radiolok/rln-trace/fw/README.md

# fw — прошивка CH569

Задачи прошивки:

- USB 3.0 SuperSpeed device (запасной путь — USB2 HS) с составным набором интерфейсов:
  трасса (как у ORBTrace), события, CMSIS-DAP v2, CDC-ACM, управление, DFU;
- приём пакетов из ПЛИС по HSPI (DMA, двойная буферизация) и отправка их в bulk IN;
- команды и запись CSR ПЛИС в обратную сторону;
- загрузка и обновление конфигурационного флеша ПЛИС по SPI0;
- позже — режим USB-Blaster для Quartus: отдельное перечисление как FT245-устройство Altera,
  образец — [`au/pico-usb-blaster`](../au/pico-usb-blaster).

Основа — BSP и примеры [`au/hydrausb3_fw`](../au/hydrausb3_fw), протокольное ядро CMSIS-DAP —
[`au/free-dap`](../au/free-dap).

## Состав

| Папка | Что |
|---|---|
| [`ch569/`](ch569/) | Прошивки CH569 на BSP HydraUSB3: пока `usbstream` — поток самопроверки USB3 без ПЛИС, 335–345 МБ/с без ошибок |
| [`uhsif/`](uhsif/) | Открытый драйвер UHSIF для CH32H417 — второго кандидата на USB3-мост, замена `libUHSIF.a` |
