radiolok/rln-trace/gw/boards/tangnano20k/README.md

# Tang Nano 20K — стенд, шаг 0

[`top_step0.sv`](top_step0.sv): ПЛИС → HSPI 16 бит → CH569 ([`fw/ch569/hspi2usb`](../../../fw/ch569/hspi2usb))
→ USB3 → [`sw/usbstream`](../../../sw/usbstream), и обратное направление CH569 → ПЛИС для замера CRC HSPI.

- 27 МГц → rPLL → `clk`, `CLK_MHZ`: 15 (проводки, по умолчанию), 30, 60, 96. Это HRCLK CH569 (через ODDR,
  в противофазе — CH569 защёлкивает HD по своему фронту посередине бита) и самотест: блоки PRBS31 по
  4096 байт, пакет HSPI — блок, USDF 0x0525354.
- HTCLK CH569 тактирует `hspi_rx` в сыром режиме; принятые пакеты уходят в UART BL616 (115200 8N1)
  hex-строками — вход [`tools/hspi-crc/find_crc.py`](../../../tools/hspi-crc).
- Раз в секунду в тот же UART — строка состояния (комментарий для `find_crc.py`):
  `# <пакетов ушло> <пакетов пришло> <из них плохих> <таймаутов HTACK> <флаги>`, всё hex;
  флаги: бит 0 — самотест включён, бит 1 — PLL захвачен, биты 15:8 — `CLK_MHZ`.
- Шина HD общая: пока CH569 держит HTREQ, новый пакет не начинается. HD отпущена (подтяжка вверх),
  пока ПЛИС не передаёт: HD0 низкий при включении CH569 — это его загрузчик.
- S1 (88) — сброс, S2 (87) — самотест вкл/выкл (после сброса включён). Нажатая кнопка даёт 1 — так в
  примерах Sipeed, на плате не проверено.

## Переделка платы

Резисторы светодиодов LED0–LED5 сняты: выводы 15–20 становятся обычными, все 34 вывода гребёнок заняты
стендом. Светодиодов на ПЛИС больше нет — состояние идёт строкой в UART.

## Выводы (план v2, HSPI 16 бит)

Гребёнки — по картинке Sipeed (`tang_nano_20k_pinlabel.png` на wiki.sipeed.com). Ограничения —
[`tangnano20k.cst`](tangnano20k.cst), частоты тактов — [`clocks.py`](clocks.py) (nextpnr) и
[`top_step0.sdc.in`](top_step0.sdc.in) (Gowin).

| Назначение | Выводы |
|---|---|
| HD0–HD14 | 80, 42, 41, 56, 54, 51, 48, 55, 49, 86, 79, 72, 71, 53, 52 (правая гребёнка) |
| HD15 | 30 |
| HRCLK, HRACT, HRVLD (выходы), HTACK (вход) | 73, 74, 75, 85 |
| HTCLK (вход, GCLKC_1), HTREQ, HTVLD (входы), HTRDY (выход) | 76, 25, 26, 29 |
| TRACECLK (GCLKT_1), TRACED0–3 — шаг 1 | 77; 15, 16, 27, 28 |
| PPS, SMA2 | 31, 17 |
| SWDIO, SWCLK, nRESET — шаг 6 | 20, 19, 18 |
| JTAG (шаг 7): TDI, TDO, nTRST | не хватает: HSPI на 8 бит освобождает HD8–HD15 |

77 — единственный вывод гребёнок для одиночного глобального такта (GCLKT), он у TRACECLK. HTCLK — на
парном 76 (GCLKC_1): по nextpnr домен HTCLK держит 155–177 МГц при нужных 120.

На тех же выводах сидит периферия платы: 79 — вход WS2812, 80 и 85 — слот SD (карту не вставлять),
51/54/55/56 — усилитель звука, 41/42/48/49 — разъём LCD. Это только нагрузка, мешать не должна.

## Соединение с CH569 EVT (проводки, шаг 0)

Гребёнка P3 (LEFT_P, 2×25) на CH569 EVT по схеме `EVT/PUB/CH569WSCH.pdf` (openwch/ch569):

- HD*n* — контакт 19 + *n*: HD0 — 19, HD1 — 20, …, HD15 — 34.
- Земля — 5, 7, 9, 11, 13, 15, 17, 18. **Контакты 1 и 3 — питание платы (POW), не подключать.**
- Линии управления идут на P3 через одну из двух пар резисторных сборок, смотрите, какая запаяна:
  **R34/R35** — прямо (метки на P3 = выводы CH569), **R32/R33** — накрест (для стыковки двух EVT,
  метка `HTCLK1` — это вывод HRCLK микросхемы и т. д.). В документе на EVT заводским для HSPI указан
  набор «R2/R22/R33» — похоже, плата приходит накрест, но лучше посмотреть.

| Tang Nano 20K | Сигнал CH569 | P3 при R34/R35 | P3 при R32/R33 |
|---|---|---|---|
| 73 HRCLK → | HRCLK (PA19) | 10 HRCLK1 | 2 HTCLK1 |
| 74 HRACT → | HRACT (PA18) | 12 HRACK1 | 4 HTREQ1 |
| 75 HRVLD → | HRVLD (PA6) | 16 HRVLD1 | 8 HTVLD1 |
| 85 HTACK ← | HTACK (PA10) | 14 HTACK1 | 6 HTRDY1 |
| 76 HTCLK ← | HTCLK (PA11) | 2 HTCLK1 | 10 HRCLK1 |
| 25 HTREQ ← | HTREQ (PA9) | 4 HTREQ1 | 12 HRACK1 |
| 26 HTVLD ← | HTVLD (PA21) | 8 HTVLD1 | 16 HRVLD1 |
| 29 HTRDY → | HTRDY (PA23) | 6 HTRDY1 | 14 HTACK1 |
| 80, 42, 41, 56, 54, 51, 48, 55 | HD0–HD7 | 19–26 | 19–26 |
| 49, 86, 79, 72, 71, 53, 52, 30 | HD8–HD15 | 27–34 | 27–34 |
| GND | GND | 5–17 нечётные, 18 | то же |

HD15 — PB14 через R2 (в ISP-варианте вместо него R1 на MISO): на заводской плате это HSPI. HD14 — PB15,
он же RST#: в нашем CH569 RESET_EN = 0, вывод свободен.

На проводках начинать с `CLK_MHZ = 15`: 16 бит × 15 МГц = 30 МБ/с. Земля — через каждые 2–3 сигнала,
HRCLK и HTCLK — с отдельной землёй рядом. Прошивка CH569 — `hspi2usb` (HSPI 16 бит).

## Сборка

```sh
make -C gw board-lint                    # Verilator, все четыре CLK_MHZ
make -C gw board-synth                   # Yosys synth_gowin (так и в CI)
make -C gw board-pnr OSS=~/.local/opt/oss-cad-suite/bin/ TN20K_MHZ=15     # nextpnr-himbaechel -> .fs
openFPGALoader -b tangnano20k gw/build/tangnano20k/top_step0.fs    # в SRAM; -f — во флеш
make -C gw board-gowin TN20K_MHZ=15      # Gowin EDA под Windows из WSL (gw_sh.exe, GW_SH=...)
```

`board-gowin` копирует исходники, `tangnano20k.cst`, SDC и [`gowin.tcl`](gowin.tcl) во временный каталог
Windows, подставляет `CLK_MHZ`, запускает `gw_sh` и забирает отчёты и битстрим в
`gw/build/tangnano20k/gowin/pnr/`. Нужна Gowin EDA с действующей лицензией (бесплатную выдаёт Gowin по
запросу). Путь — переменная `GW_SH`.

| Дата | Тулчейн | Вариант | LUT4 | ALU | DFF | BSRAM | Fmax clk / HTCLK |
|---|---|---|---|---|---|---|---|
| 2026-10-21 | Yosys 0.70 + nextpnr-himbaechel 0.11 | 8 бит, 60 МГц | 1002 | 354 | 549 | 1 | 150 / 197 МГц (нужно 60 / 120) |
| 2026-10-21 | Gowin EDA 1.9.12.04 | 8 бит, 60 МГц | 572 | 203 | 533 | 1 | 112 / 170 МГц |
| 2026-10-21 | Yosys 0.70 + nextpnr-himbaechel 0.11 | 16 бит, 15 МГц | 1401 | — | — | 1 | 115 / 155 МГц (нужно 15 / 120) |
| 2026-10-21 | Yosys 0.70 + nextpnr-himbaechel 0.11 | 16 бит, 96 МГц | 1392 | — | — | 1 | 102–123 / 174–177 МГц (нужно 96 / 120) |

Оценки Fmax у nextpnr заметно оптимистичнее, для подписи по таймингам надёжнее Gowin. На 96 МГц запас
по `clk` у nextpnr от прогона к прогону 6–28 % — до работы на этой частоте проверить в Gowin. Он же нашёл
узкое место HTCLK: свободное место FIFO `hspi_rx` (перевод указателя из кода Грея, вычитание,
сравнение) — 131 МГц при нужных 120; после регистра на `wfree` в `async_fifo` — 170 МГц.
