radiolok/rln-trace/hw/probe-b/kicad/README.md

# Открытый Debug+Trace зонд — схема rev 0.1 (KiCad 9)

Иерархический проект: корневой лист `probe.kicad_sch` + 5 листов.

| Лист | Содержимое |
|---|---|
| `usb_power.kicad_sch` | USB-C (USB 3.2 Gen1), мультиплексор SS-ориентации CBTL02043A + детектор CC на TLV7031, ESD (USBLC6, 2× TPD4EUSB30), предохранитель, 2× TLV62569 (3V3 и 1V0, 1V0 включается по PG от 3V3) |
| `mcu.kicad_sch` | CH569W: HSPI 16 бит, кварц 30 МГц, развязка по референсу WCH, BOOT (HD0), UART, доступ к флешу ПЛИС по SPI0, подтяжки I2C, разъём EXP |
| `fpga.kicad_sch` | GW2AR-18 QN88 (4 юнита: банки 0/1, 4/5, 2/3/6/7, питание), MSPI-флеш W25Q128, JTAG 10 pin 1,27 мм, генератор 50 МГц, MODE-резисторы, EXTR, светодиоды |
| `target.kicad_sch` | MIPI20, ESD (3× TPD4E02B04), последовательные 33 Ом, SN74AVC8T245 (вход трассы, TDO, контроль nRESET), SN74AVC4T245 (SWDIO, SWCLK, TDI), nRESET на 2N7002, фильтр VREF, TgtPwr (AP2161 + шунт + INA219, перемычка JP1 для 11/13), ADS1115 |
| `sma.kicad_sch` | 2× SMA, двунаправленные через SN74LVC1T45, 33 Ом, TVS, отключаемая нагрузка 50 Ом |

Также: `probe.kicad_sym` (все символы проекта), `probe.pretty` (посадка QN88), `pinmap.csv` (все выводы GW2AR-18 и CH569W → цепи), `BOM_draft.csv`. PDF-превью листов — [`../probe_schematic_preview.pdf`](../probe_schematic_preview.pdf).

## Откуда распиновки

- GW2AR-18 QN88 (вариант со SDRAM): Gowin UG115E v1.7.2, колонка QN88[1]. Сверено с Tang Nano 20K (тактовый на 4, кнопки на 87/88).
- CH569W: референсная схема WCH CH569W-R0-1v0 (репозиторий openwch/ch569).
- Остальные микросхемы: символы из библиотеки KiCad (с их номерами выводов).

## Как схема собрана

Схема сгенерирована скриптом [`tools/schgen`](../../../tools/schgen), KiCad в рабочем окружении не было. Связи сделаны метками: у каждого используемого вывода — короткий провод и метка или символ питания. Цепи между листами — глобальные метки. Собственная проверка связности (ERC-подобная) ошибок не нашла: все выводы подключены или помечены «не подключено», нет цепей из одного вывода, нет питания без источника, нет двух выходов на одной цепи.

**Первым делом:** откройте `probe.kicad_pro` в KiCad 9, выполните ERC и «Update PCB from schematic» — так проверяется, что файлы корректно читаются и все посадки находятся. Если KiCad ругнётся на формат, пришлите текст ошибки — генератор поправлю.

## Открытые вопросы до разводки

1. Посадка QN88: номинальная (контакт 0,22×0,85 мм, центральная площадка 6,74 мм), сверить с чертежом в UG229.
2. CH569W QFN68: размер центральной площадки по даташиту CH569DS1 (сейчас стоит стандартная 5,2×5,2 мм).
3. PB15 = HD14 одновременно RST#: в конфигурации CH569 отключить RST# до того, как ПЛИС начнёт управлять HSPI_D14 (стоит подтяжка 10 кОм).
4. MODE[1:0] = 00 → MSPI (по UG290, таблица 5-2), MODE2 внутри на земле — проверить.
5. Полярность SEL у CBTL02043A (SEL=0 → A↔B) — проверить по даташиту NXP.
6. Разъём USB-C (Amphenol 12401610E4-2A) — подтвердить, что это полная USB3-версия, или заменить на доступный.
7. Номиналы 33 Ом на линиях трассы подобрать на макете (84–100 МГц DDR).
8. Режим TRIGIN (TRC_DATA[2] на выход) в rev 0.1 не поддержан — вход трассы только через AVC8T245.
