radiolok/rln-trace/doc/slogic-pinmap-method.md

# SLogic16U3: методика прозвонки входов на стенде

Цель — узнать, на какие выводы GW5AT-15 приходят каналы CH0–CH15 (и выводы CK на гребёнке) у
Sipeed SLogic16U3, не рискуя прибором. Это нужно для своей прошивки направления A: адаптера потока
трассы TPIU. Что известно о приборе, его флеш и восстановлении — [`tools/slogic/README.md`](../tools/slogic/README.md).

## Что уже известно

- **ПЛИС — GW5AT-LV15MG132C1/I0**, корпус MG132: 53 пользовательских вывода. Флеш XT25F128F
  (16 МиБ, `0b4018`): приложение с 0x0, золотой образ DFU с 0x800000, оба зашифрованы; свой
  открытый битстрим ПЛИС принимает.
- **Входы — только пассивные компоненты** (резисторные сборки, конденсатор, защитный диод): каналы
  идут на выводы ПЛИС через последовательные резисторы. Порог анализатора, видимо, задаётся
  напряжением банка ввода-вывода от DC-DC (TMI7003?).
- **Отладочный разъём** `5V TMS TDO TCK TDI RXD TXD GND`, 3,3 В: JTAG ПЛИС и UART. JTAG работает
  (openFPGALoader через FT2232H); заводской образ в UART не пишет ничего.
- **Первая прозвонка (2026-10-21) собрана под корпус CS130** (`GW5AT-LV15CS130C1/I0`) вместо MG132.
  Сначала это сочли причиной неудачи; 2026-10-25 выяснилось, что нет: площадки кристалла у корпусов
  одни и те же, и образ слушал все 40 свободных (разбор — [журнал](slogic-pinmap-journal.md)).
  Итог: ни одного фронта на 40 выводах; D3, F7, K2, N2 (по раскладке CS130) снаружи держатся в 0; подтяжки вверх, вероятно, легли на линии USB-части — USB2 перестал подниматься, MODE не давал
  DFU. Прибор восстановлен через JTAG 2026-10-25.

## Стенд

```
STM32F4-Discovery ── PD0..7, PE0..7 (+GND) ──> входы CH0..CH15 SLogic16U3 ── USB ──> ПК (питание, заводской анализатор)
      │                                              │
   ST-LINK ──> ПК (OpenOCD)                     отладочный разъём
                                                     │
                                  FT2232H: канал A — JTAG, канал B — UART ──> ПК
```

| Откуда | Куда | Зачем |
|---|---|---|
| Discovery PD0–PD7, PE0–PE7 | SLogic CH0–CH15 | источник: бит k счётчика (канал CHk) меняется 500 кГц / 2^k раз в секунду ([`tools/slogic/pinmap/stm32`](../tools/slogic/pinmap/stm32)); PE0/PE1 заняты акселерометром — CH8/CH9 при необходимости с PE8/PE9 |
| Discovery GND | SLogic GND входов | общая земля |
| SLogic TCK, TDI, TDO, TMS | FT2232H ADBUS0, 1, 2, 3 | JTAG ПЛИС: загрузка образа в SRAM, чтение результата |
| SLogic TXD / RXD | FT2232H BDBUS1 / BDBUS0 (через 1 кОм) | UART разъёма, `/dev/ttyUSB1` |
| SLogic GND разъёма | FT2232H GND | |
| SLogic 5V разъёма | — | не подключать |
| SLogic USB | порт ПК (не зарядка) | питание и проверка заводским анализатором |

Все USB-устройства идут в WSL через usbipd: ST-LINK `0483:3748`, FT2232H `0403:6010`, SLogic
`359f:*` (приложение и DFU). Признак работы источника — зелёный PD12 на Discovery мигает ~1 Гц.

## Правила безопасности

1. **Флеш не трогать.** Опытные образы грузятся только в SRAM ПЛИС по JTAG
   (`openFPGALoader -c ft2232 -m образ.fs`). Сбой — передёрнуть питание SLogic: ПЛИС загрузит
   заводское приложение из флеш. Перед любой серией проверять, что бэкап `slogic16u3-factory.bin`
   на месте (sha256 `161e2bcf…85bc`), а JTAG-восстановление из `tools/slogic/README.md` под рукой.
2. **Никаких выходов на неизвестных выводах.** Все кандидаты — входы без подтяжки (в крайнем случае
   с подтяжкой вниз). Выход разрешается только на выводе, назначение которого подтверждено.
3. **Не трогать служебные выводы:** JTAG, RECONFIG_N (кнопка MODE), DONE, READY, MODE0/1, выводы
   флеш (CS, CLK, IO0–IO3), SerDes и всё, что относится к USB. Список — по таблице выводов MG132, а
   не по памяти и не по чужому корпусу.
4. **Банки ввода-вывода.** В образе задавать тот стандарт (LVCMOS33/25/18), который соответствует
   напряжению банка на плате; при сомнении — входом с самым высоким VCCIO, который не превышает
   питание банка. Напряжение банков проверить мультиметром на доступных конденсаторах, если найдутся.
5. **Остановиться**, если после загрузки образа меняется поведение прибора не так, как ожидалось
   (греется, гаснет индикатор, пропадает JTAG): снять питание, разобраться до следующей попытки.

## Ход эксперимента

### Э0. Подготовка

- Таблица выводов GW5AT-15 из документации Gowin («GW5AT-15 Pinout», excel, или «GW5A series
  Package & Pinout User Guide»; на gowinsemi.com — после входа в учётную запись). Из неё —
  список кандидатов: 53 пользовательских вывода MG132 минус служебные (п. 3 правил).
- Сборка образов для GW5AT-15 — только Gowin EDA: в открытом тулчейне
  (nextpnr-himbaechel / apycula) базы для этого кристалла нет. Корпус в проекте —
  `GW5AT-LV15MG132C1/I0`, ревизия кристалла — по `--detect` (прошлые сборки: device_version B).
- Прошивка источника на Discovery (`tools/slogic/pinmap/stm32`, OpenOCD
  `board/stm32f4discovery.cfg`); проверить PD12.

### Э1. Источник и входы — заводским анализатором

ПЛИС не трогаем. SLogic подключён к ПК, работает заводское приложение.

1. Записать несколько секунд всех 16 каналов на частоте ≥ 4 МГц (сигрок/PulseView или свой
   приёмник по протоколу Sipeed: vendor control, bulk IN 0x82).
2. Ожидание: канал CHk — меандр 500 кГц / 2^k / 2 (бит k меняется 500 кГц / 2^k раз в секунду).
3. Итог этапа: источник работает, входы целы, нумерация каналов на корпусе совпадает с прошивкой
   STM32. Если нет — дальше не идём, сначала источник и проводка.

### Э2. Канал для результата: JTAG

Чтобы не ставить ни одного выхода на неизвестный вывод, результат прозвонки читается обратно
**через JTAG**: в образе — примитив пользовательского JTAG Gowin (`GW_JTAG`, инструкции
пользовательских регистров), сдвиговый регистр с результатом. Читается он с ПК через тот же
FT2232H (OpenOCD `irscan`/`drscan` или pyftdi). Коды инструкций и поведение примитива на GW5A —
сверить с документацией Gowin (UG по примитивам и по конфигурации GW5A) и проверить на коротком
тестовом образе (константа в регистре) до прозвонки.

UART разъёма — запасной канал. Чтобы им пользоваться, сначала нужно найти шарик RXD: FT2232H шлёт в
RXD известную последовательность, образ (только входы) ищет вывод, на котором она видна. TXD —
вывод-выход: включать его только после того, как назначение подтверждено (рядом с RXD по разводке
или по документации платы, если появится).

### Э3. Прозвонка входов

Образ: все кандидаты — входы без подтяжки, на каждом — счётчик фронтов за окно (как в
[`tools/slogic/pinmap/pinmap.v`](../tools/slogic/pinmap/pinmap.v): 2^28 тактов внутреннего генератора ≈ 5 с) и
снимок уровня. Результат — в регистр пользовательского JTAG.

1. Загрузить образ в SRAM, источник **выключен** (STM32 в сбросе): записать уровни всех кандидатов.
   Это фон: что держится снаружи и чем.
2. Источник **включён**: записать число фронтов на каждом кандидате.
3. Канал опознаётся по частоте: `log2(ожидаемое для CH0 / измеренное)` = номер канала (разбор —
   [`pinmap.py`](../tools/slogic/pinmap/pinmap.py), отчёт в том же формате).
4. Повторить, отключив один канал на Discovery (вывод STM32 — вход), — подтверждение для каждого
   спорного соответствия.
5. Передёрнуть питание SLogic, убедиться, что заводское приложение работает (индикатор, USB).

### Э4. CK и порог

- Выводы CK на гребёнке (по Sipeed «зарезервированы») — найти тем же образом, подав на них сигнал с
  Discovery (свободный вывод PDx/PEx); это кандидат на вход TRACECLK.
- Порог: в заводском приложении менять порог (AUX-регистр) и смотреть, какое напряжение на плате
  меняется — так находится банк входов и его регулятор. Нужен для выбора IO_TYPE в своей прошивке.

## Что записывать

Журнал каждой попытки: дата, образ (имя, sha256, корпус и ревизия в сборке), что было подключено,
уровни и счётчики из отчёта, поведение прибора после образа и после передёргивания питания.
Итоговая таблица «канал → шарик MG132 → банк» — в `tools/slogic/README.md`.

## Восстановление

Если что-то пошло не так и передёргивание питания не помогает (а флеш не трогали — должно помогать):
порядок через JTAG в [`tools/slogic/README.md`](../tools/slogic/README.md#jtag-плис-путь-восстановления-без-dfu-проверен-2026-10-25):
дамп, сверка золотого образа, стирание 0x0, DFU, `slogic_dfu.py restore`.
