radiolok/rln-trace/tools/slogic/trace/runs/beu1000/show.txt

полубайтов 65536, простоя 43607, сообщений 3185, вне сообщений 3
  TCODE  3 DirectBranch           453
  TCODE  4 IndirectBranch         2720
  TCODE  9 ProgTraceSync          12
  @     5 10 d1 b4 07              IndirectBranch BTYPE=0 ICNT=13 UADDR=0xda                  
  @    15 10 81 60 07              IndirectBranch BTYPE=0 ICNT=8 UADDR=0xb0                   
  @    23 10 e1 2b                 IndirectBranch BTYPE=0 ICNT=14 UADDR=0x14                  
  @    29 10 e1 3c 07              IndirectBranch BTYPE=0 ICNT=14 UADDR=0x9e                  
  @    37 10 91 14 07              IndirectBranch BTYPE=0 ICNT=9 UADDR=0x8a                   
  @   137 0c 17                    DirectBranch ICNT=5                                        
  @   143 10 91 d7                 IndirectBranch BTYPE=0 ICNT=9 UADDR=0x6a                   
  @   151 10 d1 e4 07              IndirectBranch BTYPE=0 ICNT=13 UADDR=0xf2                  
  @   161 10 c1 30 07              IndirectBranch BTYPE=0 ICNT=12 UADDR=0x98                  
  @   169 10 e1 2b                 IndirectBranch BTYPE=0 ICNT=14 UADDR=0x14                  
  @   175 10 e1 48 07              IndirectBranch BTYPE=0 ICNT=14 UADDR=0xa4                  
  @   187 10 81 60 07              IndirectBranch BTYPE=0 ICNT=8 UADDR=0xb0                   
  @   277 0c 17                    DirectBranch ICNT=5                                        
  @   283 10 91 d7                 IndirectBranch BTYPE=0 ICNT=9 UADDR=0x6a                   
  @   291 10 d1 c0 07              IndirectBranch BTYPE=0 ICNT=13 UADDR=0xe0                  
  @   301 10 91 14 07              IndirectBranch BTYPE=0 ICNT=9 UADDR=0x8a                   
  @   309 10 e1 2b                 IndirectBranch BTYPE=0 ICNT=14 UADDR=0x14                  
  @   315 10 e1 18 07              IndirectBranch BTYPE=0 ICNT=14 UADDR=0x8c                  
  @   331 10 c1 30 07              IndirectBranch BTYPE=0 ICNT=12 UADDR=0x98                  
  @   425 0c 17                    DirectBranch ICNT=5                                        
  @   431 10 91 d7                 IndirectBranch BTYPE=0 ICNT=9 UADDR=0x6a                   
  @   439 10 d1 b4 07              IndirectBranch BTYPE=0 ICNT=13 UADDR=0xda                  
  @   449 10 81 60 07              IndirectBranch BTYPE=0 ICNT=8 UADDR=0xb0                   
  @   457 10 e1 2b                 IndirectBranch BTYPE=0 ICNT=14 UADDR=0x14                  
  @   463 10 e1 3c 07              IndirectBranch BTYPE=0 ICNT=14 UADDR=0x9e                  
  @   471 10 91 14 07              IndirectBranch BTYPE=0 ICNT=9 UADDR=0x8a                   
  @   571 0c 17                    DirectBranch ICNT=5                                        
  @   577 10 91 d7                 IndirectBranch BTYPE=0 ICNT=9 UADDR=0x6a                   
  @   585 10 d1 e4 07              IndirectBranch BTYPE=0 ICNT=13 UADDR=0xf2                  
  @   595 10 c1 30 07              IndirectBranch BTYPE=0 ICNT=12 UADDR=0x98                  
  @   603 10 e1 2b                 IndirectBranch BTYPE=0 ICNT=14 UADDR=0x14                  
  @   609 10 e1 48 07              IndirectBranch BTYPE=0 ICNT=14 UADDR=0xa4                  
  @   621 10 81 60 07              IndirectBranch BTYPE=0 ICNT=8 UADDR=0xb0                   
  @   711 0c 17                    DirectBranch ICNT=5                                        
  @   717 10 91 d7                 IndirectBranch BTYPE=0 ICNT=9 UADDR=0x6a                   
  @   725 10 d1 c0 07              IndirectBranch BTYPE=0 ICNT=13 UADDR=0xe0                  
  @   735 10 91 14 07              IndirectBranch BTYPE=0 ICNT=9 UADDR=0x8a                   
  @   743 10 e1 2b                 IndirectBranch BTYPE=0 ICNT=14 UADDR=0x14                  
  @   749 10 e1 18 07              IndirectBranch BTYPE=0 ICNT=14 UADDR=0x8c                  
  @   767 10 c1 30 07              IndirectBranch BTYPE=0 ICNT=12 UADDR=0x98                  
  @   861 0c 17                    DirectBranch ICNT=5                                        
  @   867 10 91 d7                 IndirectBranch BTYPE=0 ICNT=9 UADDR=0x6a                   
  @   875 10 d1 b4 07              IndirectBranch BTYPE=0 ICNT=13 UADDR=0xda                  
  @   885 10 81 60 07              IndirectBranch BTYPE=0 ICNT=8 UADDR=0xb0                   
  @   893 10 e1 2b                 IndirectBranch BTYPE=0 ICNT=14 UADDR=0x14                  
  @   899 10 e1 3c 07              IndirectBranch BTYPE=0 ICNT=14 UADDR=0x9e                  
  @   907 10 91 14 07              IndirectBranch BTYPE=0 ICNT=9 UADDR=0x8a                   
  @  1007 0c 17                    DirectBranch ICNT=5                                        
  @  1013 10 91 d7                 IndirectBranch BTYPE=0 ICNT=9 UADDR=0x6a                   
  @  1021 10 d1 e4 07              IndirectBranch BTYPE=0 ICNT=13 UADDR=0xf2                  
  @  1031 10 c1 30 07              IndirectBranch BTYPE=0 ICNT=12 UADDR=0x98                  
  @  1039 10 e1 2b                 IndirectBranch BTYPE=0 ICNT=14 UADDR=0x14                  
  @  1045 10 e1 48 07              IndirectBranch BTYPE=0 ICNT=14 UADDR=0xa4                  
  @  1053 10 81 60 07              IndirectBranch BTYPE=0 ICNT=8 UADDR=0xb0                   
  @  1147 0c 17                    DirectBranch ICNT=5                                        
  @  1153 10 91 d7                 IndirectBranch BTYPE=0 ICNT=9 UADDR=0x6a                   
  @  1161 10 d1 c0 07              IndirectBranch BTYPE=0 ICNT=13 UADDR=0xe0                  
  @  1171 10 91 14 07              IndirectBranch BTYPE=0 ICNT=9 UADDR=0x8a                   
  @  1179 10 e1 2b                 IndirectBranch BTYPE=0 ICNT=14 UADDR=0x14                  
  @  1185 10 e1 18 07              IndirectBranch BTYPE=0 ICNT=14 UADDR=0x8c                  
  @  1199 10 c1 30 07              IndirectBranch BTYPE=0 ICNT=12 UADDR=0x98                  
  @  1295 0c 17                    DirectBranch ICNT=5                                        
  @  1301 10 91 d7                 IndirectBranch BTYPE=0 ICNT=9 UADDR=0x6a                   
  @  1309 10 d1 b4 07              IndirectBranch BTYPE=0 ICNT=13 UADDR=0xda                  
  @  1319 10 81 60 07              IndirectBranch BTYPE=0 ICNT=8 UADDR=0xb0                   
  @  1327 10 e1 2b                 IndirectBranch BTYPE=0 ICNT=14 UADDR=0x14                  
  @  1333 10 e1 3c 07              IndirectBranch BTYPE=0 ICNT=14 UADDR=0x9e                  
  @  1341 10 91 14 07              IndirectBranch BTYPE=0 ICNT=9 UADDR=0x8a                   
  @  1441 0c 17                    DirectBranch ICNT=5                                        
  @  1447 10 91 d7                 IndirectBranch BTYPE=0 ICNT=9 UADDR=0x6a                   
  @  1455 10 d1 e4 07              IndirectBranch BTYPE=0 ICNT=13 UADDR=0xf2                  
  @  1465 10 c1 30 07              IndirectBranch BTYPE=0 ICNT=12 UADDR=0x98                  
  @  1473 10 e1 2b                 IndirectBranch BTYPE=0 ICNT=14 UADDR=0x14                  
  @  1479 10 e1 48 07              IndirectBranch BTYPE=0 ICNT=14 UADDR=0xa4                  
  @  1487 10 81 60 07              IndirectBranch BTYPE=0 ICNT=8 UADDR=0xb0                   
  @  1581 0c 17                    DirectBranch ICNT=5                                        
  @  1587 10 91 d7                 IndirectBranch BTYPE=0 ICNT=9 UADDR=0x6a                   
  @  1595 10 d1 c0 07              IndirectBranch BTYPE=0 ICNT=13 UADDR=0xe0                  
  @  1605 10 91 14 07              IndirectBranch BTYPE=0 ICNT=9 UADDR=0x8a                   
  @  1613 10 e1 2b                 IndirectBranch BTYPE=0 ICNT=14 UADDR=0x14                  
  @  1619 10 e1 18 07              IndirectBranch BTYPE=0 ICNT=14 UADDR=0x8c                  
  @  1633 10 c1 30 07              IndirectBranch BTYPE=0 ICNT=12 UADDR=0x98                  
  @  1729 0c 17                    DirectBranch ICNT=5                                        
  @  1735 10 91 d7                 IndirectBranch BTYPE=0 ICNT=9 UADDR=0x6a                   
  @  1743 10 d1 b4 07              IndirectBranch BTYPE=0 ICNT=13 UADDR=0xda                  
  @  1753 10 81 60 07              IndirectBranch BTYPE=0 ICNT=8 UADDR=0xb0                   
  @  1761 10 e1 2b                 IndirectBranch BTYPE=0 ICNT=14 UADDR=0x14                  
  @  1767 10 e1 3c 07              IndirectBranch BTYPE=0 ICNT=14 UADDR=0x9e                  
  @  1775 10 91 14 07              IndirectBranch BTYPE=0 ICNT=9 UADDR=0x8a                   
  @  1875 0c 17                    DirectBranch ICNT=5                                        
  @  1881 10 91 d7                 IndirectBranch BTYPE=0 ICNT=9 UADDR=0x6a                   
  @  1889 10 d1 e4 07              IndirectBranch BTYPE=0 ICNT=13 UADDR=0xf2                  
  @  1899 10 c1 30 07              IndirectBranch BTYPE=0 ICNT=12 UADDR=0x98                  
  @  1907 10 e1 2b                 IndirectBranch BTYPE=0 ICNT=14 UADDR=0x14                  
  @  1913 10 e1 48 07              IndirectBranch BTYPE=0 ICNT=14 UADDR=0xa4                  
  @  1921 10 81 60 07              IndirectBranch BTYPE=0 ICNT=8 UADDR=0xb0                   
  @  2015 0c 17                    DirectBranch ICNT=5                                        
  @  2021 10 91 d7                 IndirectBranch BTYPE=0 ICNT=9 UADDR=0x6a                   
  @  2029 10 d1 c0 07              IndirectBranch BTYPE=0 ICNT=13 UADDR=0xe0                  
  @  2039 10 91 14 07              IndirectBranch BTYPE=0 ICNT=9 UADDR=0x8a                   
  @  2047 10 e1 2b                 IndirectBranch BTYPE=0 ICNT=14 UADDR=0x14                  
  @  2053 10 e1 18 07              IndirectBranch BTYPE=0 ICNT=14 UADDR=0x8c                  
  @  2067 10 c1 30 07              IndirectBranch BTYPE=0 ICNT=12 UADDR=0x98                  
  @  2163 0c 17                    DirectBranch ICNT=5                                        
  @  2169 10 91 d7                 IndirectBranch BTYPE=0 ICNT=9 UADDR=0x6a                   
  @  2177 10 d1 b4 07              IndirectBranch BTYPE=0 ICNT=13 UADDR=0xda                  
  @  2187 10 81 60 07              IndirectBranch BTYPE=0 ICNT=8 UADDR=0xb0                   
  @  2195 10 e1 2b                 IndirectBranch BTYPE=0 ICNT=14 UADDR=0x14                  
  @  2201 10 e1 3c 07              IndirectBranch BTYPE=0 ICNT=14 UADDR=0x9e                  
  @  2209 10 91 14 07              IndirectBranch BTYPE=0 ICNT=9 UADDR=0x8a                   
  @  2309 0c 17                    DirectBranch ICNT=5                                        
  @  2315 10 91 d7                 IndirectBranch BTYPE=0 ICNT=9 UADDR=0x6a                   
  @  2323 10 d1 e4 07              IndirectBranch BTYPE=0 ICNT=13 UADDR=0xf2                  
  @  2333 10 c1 30 07              IndirectBranch BTYPE=0 ICNT=12 UADDR=0x98                  
  @  2341 10 e1 2b                 IndirectBranch BTYPE=0 ICNT=14 UADDR=0x14                  
  @  2347 10 e1 48 07              IndirectBranch BTYPE=0 ICNT=14 UADDR=0xa4                  
  @  2355 10 81 60 07              IndirectBranch BTYPE=0 ICNT=8 UADDR=0xb0                   
  @  2449 0c 17                    DirectBranch ICNT=5                                        
  @  2455 10 91 d7                 IndirectBranch BTYPE=0 ICNT=9 UADDR=0x6a                   
  @  2463 10 d1 c0 07              IndirectBranch BTYPE=0 ICNT=13 UADDR=0xe0                  
  @  2473 10 91 14 07              IndirectBranch BTYPE=0 ICNT=9 UADDR=0x8a                   
  @  2481 10 e1 2b                 IndirectBranch BTYPE=0 ICNT=14 UADDR=0x14                  
  @  2487 10 e1 18 07              IndirectBranch BTYPE=0 ICNT=14 UADDR=0x8c                  
  @  2501 10 c1 30 07              IndirectBranch BTYPE=0 ICNT=12 UADDR=0x98                  
  @  2597 0c 17                    DirectBranch ICNT=5                                        
  @  2603 10 91 d7                 IndirectBranch BTYPE=0 ICNT=9 UADDR=0x6a                   
  @  2611 10 d1 b4 07              IndirectBranch BTYPE=0 ICNT=13 UADDR=0xda                  
  @  2621 10 81 60 07              IndirectBranch BTYPE=0 ICNT=8 UADDR=0xb0                   
  @  2629 10 e1 2b                 IndirectBranch BTYPE=0 ICNT=14 UADDR=0x14                  
  @  2635 10 e1 3c 07              IndirectBranch BTYPE=0 ICNT=14 UADDR=0x9e                  
  @  2643 10 91 14 07              IndirectBranch BTYPE=0 ICNT=9 UADDR=0x8a                   
  @  2743 0c 17                    DirectBranch ICNT=5                                        
  @  2749 10 91 d7                 IndirectBranch BTYPE=0 ICNT=9 UADDR=0x6a                   
  @  2757 10 d1 e4 07              IndirectBranch BTYPE=0 ICNT=13 UADDR=0xf2                  
  @  2767 10 c1 30 07              IndirectBranch BTYPE=0 ICNT=12 UADDR=0x98                  
  @  2775 10 e1 2b                 IndirectBranch BTYPE=0 ICNT=14 UADDR=0x14                  
  @  2781 10 e1 48 07              IndirectBranch BTYPE=0 ICNT=14 UADDR=0xa4                  
  @  2789 10 81 60 07              IndirectBranch BTYPE=0 ICNT=8 UADDR=0xb0                   
  @  2883 0c 17                    DirectBranch ICNT=5                                        
  @  2889 10 91 d7                 IndirectBranch BTYPE=0 ICNT=9 UADDR=0x6a                   
  @  2897 10 d1 c0 07              IndirectBranch BTYPE=0 ICNT=13 UADDR=0xe0                  
  @  2907 10 91 14 07              IndirectBranch BTYPE=0 ICNT=9 UADDR=0x8a                   
  @  2915 10 e1 2b                 IndirectBranch BTYPE=0 ICNT=14 UADDR=0x14                  
  @  2921 10 e1 18 07              IndirectBranch BTYPE=0 ICNT=14 UADDR=0x8c                  
  @  2935 10 c1 30 07              IndirectBranch BTYPE=0 ICNT=12 UADDR=0x98                  
  @  3031 0c 17                    DirectBranch ICNT=5                                        
  @  3037 10 91 d7                 IndirectBranch BTYPE=0 ICNT=9 UADDR=0x6a                   
  @  3045 10 d1 b4 07              IndirectBranch BTYPE=0 ICNT=13 UADDR=0xda                  
  @  3055 10 81 60 07              IndirectBranch BTYPE=0 ICNT=8 UADDR=0xb0                   
  @  3063 10 e1 2b                 IndirectBranch BTYPE=0 ICNT=14 UADDR=0x14                  
  @  3069 10 e1 3c 07              IndirectBranch BTYPE=0 ICNT=14 UADDR=0x9e                  
  @  3077 10 91 14 07              IndirectBranch BTYPE=0 ICNT=9 UADDR=0x8a                   
  @  3177 0c 17                    DirectBranch ICNT=5                                        
  @  3183 10 91 d7                 IndirectBranch BTYPE=0 ICNT=9 UADDR=0x6a                   
  @  3191 10 d1 e4 07              IndirectBranch BTYPE=0 ICNT=13 UADDR=0xf2                  
  @  3201 10 c1 30 07              IndirectBranch BTYPE=0 ICNT=12 UADDR=0x98                  
  @  3209 10 e1 2b                 IndirectBranch BTYPE=0 ICNT=14 UADDR=0x14                  
  @  3215 10 e1 48 07              IndirectBranch BTYPE=0 ICNT=14 UADDR=0xa4                  
  @  3223 10 81 60 07              IndirectBranch BTYPE=0 ICNT=8 UADDR=0xb0                   
  @  3317 0c 17                    DirectBranch ICNT=5                                        
  @  3323 10 91 d7                 IndirectBranch BTYPE=0 ICNT=9 UADDR=0x6a                   
  @  3331 10 d1 c0 07              IndirectBranch BTYPE=0 ICNT=13 UADDR=0xe0                  
  @  3341 10 91 14 07              IndirectBranch BTYPE=0 ICNT=9 UADDR=0x8a                   
  @  3349 10 e1 2b                 IndirectBranch BTYPE=0 ICNT=14 UADDR=0x14                  
  @  3355 10 e1 18 07              IndirectBranch BTYPE=0 ICNT=14 UADDR=0x8c                  
  @  3369 10 c1 30 07              IndirectBranch BTYPE=0 ICNT=12 UADDR=0x98                  
  @  3465 0c 17                    DirectBranch ICNT=5                                        
  @  3471 10 91 d7                 IndirectBranch BTYPE=0 ICNT=9 UADDR=0x6a                   
  @  3479 10 d1 b4 07              IndirectBranch BTYPE=0 ICNT=13 UADDR=0xda                  
  @  3489 10 81 60 07              IndirectBranch BTYPE=0 ICNT=8 UADDR=0xb0                   
  @  3497 10 e1 2b                 IndirectBranch BTYPE=0 ICNT=14 UADDR=0x14                  
  @  3503 10 e1 3c 07              IndirectBranch BTYPE=0 ICNT=14 UADDR=0x9e                  
  @  3511 10 91 14 07              IndirectBranch BTYPE=0 ICNT=9 UADDR=0x8a                   
  @  3611 0c 17                    DirectBranch ICNT=5                                        
  @  3617 10 91 d7                 IndirectBranch BTYPE=0 ICNT=9 UADDR=0x6a                   
  @  3625 10 d1 e4 07              IndirectBranch BTYPE=0 ICNT=13 UADDR=0xf2                  
  @  3635 10 c1 30 07              IndirectBranch BTYPE=0 ICNT=12 UADDR=0x98                  
  @  3643 10 e1 2b                 IndirectBranch BTYPE=0 ICNT=14 UADDR=0x14                  
  @  3649 10 e1 48 07              IndirectBranch BTYPE=0 ICNT=14 UADDR=0xa4                  
  @  3657 10 81 60 07              IndirectBranch BTYPE=0 ICNT=8 UADDR=0xb0                   
  @  3751 0c 17                    DirectBranch ICNT=5                                        
  @  3757 10 91 d7                 IndirectBranch BTYPE=0 ICNT=9 UADDR=0x6a                   
  @  3765 10 d1 c0 07              IndirectBranch BTYPE=0 ICNT=13 UADDR=0xe0                  
  @  3775 10 91 14 07              IndirectBranch BTYPE=0 ICNT=9 UADDR=0x8a                   
  @  3783 10 e1 2b                 IndirectBranch BTYPE=0 ICNT=14 UADDR=0x14                  
  @  3789 10 e1 18 07              IndirectBranch BTYPE=0 ICNT=14 UADDR=0x8c                  
  @  3803 10 c1 30 07              IndirectBranch BTYPE=0 ICNT=12 UADDR=0x98                  
  @  3899 0c 17                    DirectBranch ICNT=5                                        
  @  3905 10 91 d7                 IndirectBranch BTYPE=0 ICNT=9 UADDR=0x6a                   
  @  3913 10 d1 b4 07              IndirectBranch BTYPE=0 ICNT=13 UADDR=0xda                  
  @  3923 10 81 60 07              IndirectBranch BTYPE=0 ICNT=8 UADDR=0xb0                   
  @  3931 10 e1 2b                 IndirectBranch BTYPE=0 ICNT=14 UADDR=0x14                  
  @  3937 10 e1 3c 07              IndirectBranch BTYPE=0 ICNT=14 UADDR=0x9e                  
  @  3945 10 91 14 07              IndirectBranch BTYPE=0 ICNT=9 UADDR=0x8a                   
  @  4045 0c 17                    DirectBranch ICNT=5                                        
  @  4051 10 91 d7                 IndirectBranch BTYPE=0 ICNT=9 UADDR=0x6a                   
  @  4059 10 d1 e4 07              IndirectBranch BTYPE=0 ICNT=13 UADDR=0xf2                  
  @  4069 10 c1 30 07              IndirectBranch BTYPE=0 ICNT=12 UADDR=0x98                  
  @  4077 10 e1 2b                 IndirectBranch BTYPE=0 ICNT=14 UADDR=0x14                  
  @  4083 10 e1 48 07              IndirectBranch BTYPE=0 ICNT=14 UADDR=0xa4                  
  @  4091 10 81 60 07              IndirectBranch BTYPE=0 ICNT=8 UADDR=0xb0                   
  @  4153 0c 17                    DirectBranch ICNT=5                                        
  @  4159 10 91 d7                 IndirectBranch BTYPE=0 ICNT=9 UADDR=0x6a                   
  @  4167 10 d1 c0 07              IndirectBranch BTYPE=0 ICNT=13 UADDR=0xe0                  
  @  4177 24 89 a0 00 20 00 83     ProgTraceSync SYNC=2 (периодическая) ICNT=2 FADDR=0x40010050 → 0x40010050 <op_a>
  @  4191 10 71 2c 07              IndirectBranch BTYPE=0 ICNT=7 UADDR=0x96                   → 0x400100c6 <main>
  @  4263 10 e1 2b                 IndirectBranch BTYPE=0 ICNT=14 UADDR=0x14                  → 0x400100d2 <main>
  @  4271 10 e1 18 07              IndirectBranch BTYPE=0 ICNT=14 UADDR=0x8c                  → 0x4001005e <op_b>
  @  4281 10 c1 30 07              IndirectBranch BTYPE=0 ICNT=12 UADDR=0x98                  → 0x400100c6 <main>
  @  4291 0c 17                    DirectBranch ICNT=5                                        → 0x400100aa <main>
  @  4295 10 91 d7                 IndirectBranch BTYPE=0 ICNT=9 UADDR=0x6a                   → 0x400100ac <main>
  @  4301 10 d1 b4 07              IndirectBranch BTYPE=0 ICNT=13 UADDR=0xda                  → 0x40010076 <op_c>
  @  4309 10 81 60 07              IndirectBranch BTYPE=0 ICNT=8 UADDR=0xb0                   → 0x400100c6 <main>
  @  4403 10 e1 2b                 IndirectBranch BTYPE=0 ICNT=14 UADDR=0x14                  → 0x400100d2 <main>
  @  4411 10 e1 3c 07              IndirectBranch BTYPE=0 ICNT=14 UADDR=0x9e                  → 0x4001004c <op_a>
  @  4421 10 91 14 07              IndirectBranch BTYPE=0 ICNT=9 UADDR=0x8a                   → 0x400100c6 <main>
  @  4431 0c 17                    DirectBranch ICNT=5                                        → 0x400100aa <main>
  @  4435 10 91 d7                 IndirectBranch BTYPE=0 ICNT=9 UADDR=0x6a                   → 0x400100ac <main>
  @  4441 10 d1 e4 07              IndirectBranch BTYPE=0 ICNT=13 UADDR=0xf2                  → 0x4001005e <op_b>
  @  4453 10 c1 30 07              IndirectBranch BTYPE=0 ICNT=12 UADDR=0x98                  → 0x400100c6 <main>
  @  4551 10 e1 2b                 IndirectBranch BTYPE=0 ICNT=14 UADDR=0x14                  → 0x400100d2 <main>
  @  4559 10 e1 48 07              IndirectBranch BTYPE=0 ICNT=14 UADDR=0xa4                  → 0x40010076 <op_c>
  @  4569 10 81 60 07              IndirectBranch BTYPE=0 ICNT=8 UADDR=0xb0                   → 0x400100c6 <main>
  @  4579 0c 17                    DirectBranch ICNT=5                                        → 0x400100aa <main>
  @  4583 10 91 d7                 IndirectBranch BTYPE=0 ICNT=9 UADDR=0x6a                   → 0x400100ac <main>
  @  4589 10 d1 c0 07              IndirectBranch BTYPE=0 ICNT=13 UADDR=0xe0                  → 0x4001004c <op_a>
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
  @  8059 10 d1 c0 07              IndirectBranch BTYPE=0 ICNT=13 UADDR=0xe0                  → 0x4001004c <op_a>
  @  8067 10 91 14 07              IndirectBranch BTYPE=0 ICNT=9 UADDR=0x8a                   → 0x400100c6 <main>
  @  8167 10 e1 2b                 IndirectBranch BTYPE=0 ICNT=14 UADDR=0x14                  → 0x400100d2 <main>
  @  8175 10 e1 18 07              IndirectBranch BTYPE=0 ICNT=14 UADDR=0x8c                  → 0x4001005e <op_b>
  @  8185 10 c1 30 07              IndirectBranch BTYPE=0 ICNT=12 UADDR=0x98                  → 0x400100c6 <main>
  @  8195 0c 17                    DirectBranch ICNT=5                                        → 0x400100aa <main>
  @  8199 10 91 d7                 IndirectBranch BTYPE=0 ICNT=9 UADDR=0x6a                   → 0x400100ac <main>
инструкций восстановлено 21629, ошибок пути 0
вызовов op_a/op_b/op_c 848, нарушений порядка a→b→c 0
ИТОГ: трасса цела, путь программы совпал
