radiolok/rln-trace/tools/slogic/trace/runs/beu1000/table-btm.md

| Исходник `main.c` | Адрес | Инструкция | Сообщение N-Trace | Декодер |
|---|---|---|---|---|
| 51: `ops[i % 3]();` | `4001011c` | `lw a5,0(a5)` | `10 20 05 64 07` IndirectBranch BTYPE=0 ICNT=18 UADDR=0xb2 | дальше |
| 44: `for (uint32_t i = 0;; i++) {` | `4001011e` | `addi s6,s6,1` | ″ | дальше |
| 51: `ops[i % 3]();` | `40010120` | `jalr a5` | ″ | косвенный → 4001004c (U-ADDR) |
| 20: `__attribute__((noinline)) static void op_a(void) { acc ^= 0x5A; }` | `4001004c` | `lui a4,0x40020` | `10 91 dc 0b` IndirectBranch BTYPE=0 ICNT=9 UADDR=0x16e | дальше |
|  | `40010050` | `lw a5,8(a4)` | ″ | дальше |
|  | `40010054` | `xori a5,a5,90` | ″ | дальше |
|  | `40010058` | `sw a5,8(a4)` | ″ | дальше |
|  | `4001005c` | `ret` | ″ | косвенный → 40010122 (U-ADDR) |
| 45: `n = i;` | `40010122` | `sw s6,12(s5)` | `0c 17` DirectBranch ICNT=5 | дальше |
| 46: `if (i & 1)` | `40010126` | `andi a5,s6,1` | ″ | дальше |
|  | `4001012a` | `bnez a5,400100ee` | ″ | взят → 400100ee |
| 47: `inc_odd();` | `400100ee` | `jal 4001003c` | `10 91 a4 0f` IndirectBranch BTYPE=0 ICNT=9 UADDR=0x1d2 | прямой → 4001003c |
| 19: `__attribute__((noinline)) static void inc_odd(void) { acc += 1; }` | `4001003c` | `lui a4,0x40020` | ″ | дальше |
|  | `40010040` | `lw a5,8(a4)` | ″ | дальше |
|  | `40010044` | `addi a5,a5,1` | ″ | дальше |
|  | `40010046` | `sw a5,8(a4)` | ″ | дальше |
|  | `4001004a` | `ret` | ″ | косвенный → 400100f0 (U-ADDR) |
| 50: `acc += bits(pat == 0xFFFFFFFF ? i : pat);` | `400100f0` | `lw a5,0(s1)` | `0c 13` DirectBranch ICNT=4 | дальше |
|  | `400100f4` | `beq a5,s4,40010136` | ″ | взят → 40010136 |
|  | `40010136` | `mv a0,s6` | `0c 43` DirectBranch ICNT=16 | дальше |
|  | `40010138` | `j 400100fc` | ″ | прямой → 400100fc |
|  | `400100fc` | `jal 40010086` | ″ | прямой → 40010086 |
| 29: `uint32_t len = nbits;` | `40010086` | `lui a5,0x40020` | ″ | дальше |
|  | `4001008a` | `lw a2,4(a5)` | ″ | дальше |
| 30: `for (uint32_t b = 0; b < len; b++) {` | `4001008e` | `beqz a2,400100b4` | ″ | не взят |
|  | `40010090` | `li a5,0` | ″ | дальше |
| 28: `uint32_t r = 0;` | `40010092` | `li a3,0` | ″ | дальше |
| 31: `if (x & (1u << (b & 31))) {` | `40010094` | `li a1,1` | ″ | дальше |
|  | `40010096` | `j 400100a0` | ″ | прямой → 400100a0 |
|  | `400100a0` | `sll a4,a1,a5` | ″ | дальше |
|  | `400100a4` | `and a4,a4,a0` | ″ | дальше |
|  | `400100a6` | `bnez a4,40010098` | ″ | взят → 40010098 |
| 32: `r += b;` | `40010098` | `add a3,a3,a5` | `0c 23` DirectBranch ICNT=8 | дальше |
| 30: `for (uint32_t b = 0; b < len; b++) {` | `4001009a` | `addi a5,a5,1` | ″ | дальше |
|  | `4001009c` | `beq a2,a5,400100b0` | ″ | не взят |
| 31: `if (x & (1u << (b & 31))) {` | `400100a0` | `sll a4,a1,a5` | ″ | дальше |
|  | `400100a4` | `and a4,a4,a0` | ″ | дальше |
|  | `400100a6` | `bnez a4,40010098` | ″ | взят → 40010098 |
| 32: `r += b;` | `40010098` | `add a3,a3,a5` | `0c 23` DirectBranch ICNT=8 | дальше |
| 30: `for (uint32_t b = 0; b < len; b++) {` | `4001009a` | `addi a5,a5,1` | ″ | дальше |
|  | `4001009c` | `beq a2,a5,400100b0` | ″ | не взят |
| 31: `if (x & (1u << (b & 31))) {` | `400100a0` | `sll a4,a1,a5` | ″ | дальше |
|  | `400100a4` | `and a4,a4,a0` | ″ | дальше |
|  | `400100a6` | `bnez a4,40010098` | ″ | взят → 40010098 |
| 32: `r += b;` | `40010098` | `add a3,a3,a5` | `0c 33` DirectBranch ICNT=12 | дальше |
| 30: `for (uint32_t b = 0; b < len; b++) {` | `4001009a` | `addi a5,a5,1` | ″ | дальше |
|  | `4001009c` | `beq a2,a5,400100b0` | ″ | не взят |
| 31: `if (x & (1u << (b & 31))) {` | `400100a0` | `sll a4,a1,a5` | ″ | дальше |
|  | `400100a4` | `and a4,a4,a0` | ″ | дальше |
|  | `400100a6` | `bnez a4,40010098` | ″ | не взят |
| 35: `r ^= b;` | `400100a8` | `xor a3,a3,a5` | ″ | дальше |
| 30: `for (uint32_t b = 0; b < len; b++) {` | `400100aa` | `addi a5,a5,1` | ″ | дальше |
|  | `400100ac` | `bne a2,a5,400100a0` | ″ | взят → 400100a0 |
| 31: `if (x & (1u << (b & 31))) {` | `400100a0` | `sll a4,a1,a5` | `0c 13` DirectBranch ICNT=4 | дальше |
|  | `400100a4` | `and a4,a4,a0` | ″ | дальше |
|  | `400100a6` | `bnez a4,40010098` | ″ | взят → 40010098 |
| 32: `r += b;` | `40010098` | `add a3,a3,a5` | `0c 33` DirectBranch ICNT=12 | дальше |
| 30: `for (uint32_t b = 0; b < len; b++) {` | `4001009a` | `addi a5,a5,1` | ″ | дальше |
|  | `4001009c` | `beq a2,a5,400100b0` | ″ | не взят |
| 31: `if (x & (1u << (b & 31))) {` | `400100a0` | `sll a4,a1,a5` | ″ | дальше |
|  | `400100a4` | `and a4,a4,a0` | ″ | дальше |
|  | `400100a6` | `bnez a4,40010098` | ″ | не взят |
| 35: `r ^= b;` | `400100a8` | `xor a3,a3,a5` | ″ | дальше |
| 30: `for (uint32_t b = 0; b < len; b++) {` | `400100aa` | `addi a5,a5,1` | ″ | дальше |
|  | `400100ac` | `bne a2,a5,400100a0` | ″ | взят → 400100a0 |
| 31: `if (x & (1u << (b & 31))) {` | `400100a0` | `sll a4,a1,a5` | `0c 13` DirectBranch ICNT=4 | дальше |
|  | `400100a4` | `and a4,a4,a0` | ″ | дальше |
|  | `400100a6` | `bnez a4,40010098` | ″ | взят → 40010098 |
| 32: `r += b;` | `40010098` | `add a3,a3,a5` | `10 e1 1f` IndirectBranch BTYPE=0 ICNT=14 UADDR=0xe | дальше |
| 30: `for (uint32_t b = 0; b < len; b++) {` | `4001009a` | `addi a5,a5,1` | ″ | дальше |
|  | `4001009c` | `beq a2,a5,400100b0` | ″ | не взят |
| 31: `if (x & (1u << (b & 31))) {` | `400100a0` | `sll a4,a1,a5` | ″ | дальше |
|  | `400100a4` | `and a4,a4,a0` | ″ | дальше |
|  | `400100a6` | `bnez a4,40010098` | ″ | не взят |
| 35: `r ^= b;` | `400100a8` | `xor a3,a3,a5` | ″ | дальше |
| 30: `for (uint32_t b = 0; b < len; b++) {` | `400100aa` | `addi a5,a5,1` | ″ | дальше |
|  | `400100ac` | `bne a2,a5,400100a0` | ″ | не взят |
| 40: `}` | `400100b0` | `mv a0,a3` | ″ | дальше |
|  | `400100b2` | `ret` | ″ | косвенный → 400100fe (U-ADDR) |
| 51: `ops[i % 3]();` | `400100fe` | `mulhu a5,s6,s2` | `10 20 05 40 07` IndirectBranch BTYPE=0 ICNT=18 UADDR=0xa0 | дальше |
| 50: `acc += bits(pat == 0xFFFFFFFF ? i : pat);` | `40010102` | `lw a4,8(s0)` | ″ | дальше |
|  | `40010106` | `add a4,a4,a0` | ″ | дальше |
|  | `40010108` | `sw a4,8(s0)` | ″ | дальше |
| 51: `ops[i % 3]();` | `4001010c` | `srli a4,a5,0x1` | ″ | дальше |
|  | `40010110` | `andi a5,a5,-2` | ″ | дальше |
|  | `40010112` | `add a5,a5,a4` | ″ | дальше |
|  | `40010114` | `sub a5,s6,a5` | ″ | дальше |
|  | `40010118` | `slli a5,a5,0x2` | ″ | дальше |
|  | `4001011a` | `add a5,a5,s3` | ″ | дальше |
|  | `4001011c` | `lw a5,0(a5)` | ″ | дальше |
| 44: `for (uint32_t i = 0;; i++) {` | `4001011e` | `addi s6,s6,1` | ″ | дальше |
| 51: `ops[i % 3]();` | `40010120` | `jalr a5` | ″ | косвенный → 4001005e (U-ADDR) |
| 21: `__attribute__((noinline)) static void op_b(void) { acc = acc << 1 | acc >> 31; }` | `4001005e` | `lui a4,0x40020` | `10 c1 f8 0b` IndirectBranch BTYPE=0 ICNT=12 UADDR=0x17c | дальше |
|  | `40010062` | `lw a5,8(a4)` | ″ | дальше |
|  | `40010066` | `lw a3,8(a4)` | ″ | дальше |
|  | `4001006a` | `slli a5,a5,0x1` | ″ | дальше |
|  | `4001006c` | `srli a3,a3,0x1f` | ″ | дальше |
|  | `4001006e` | `or a5,a5,a3` | ″ | дальше |
|  | `40010070` | `sw a5,8(a4)` | ″ | дальше |
|  | `40010074` | `ret` | ″ | косвенный → 40010122 (U-ADDR) |
| 45: `n = i;` | `40010122` | `sw s6,12(s5)` | `10 e1 1b` IndirectBranch BTYPE=0 ICNT=14 UADDR=0xc | дальше |
| 46: `if (i & 1)` | `40010126` | `andi a5,s6,1` | ″ | дальше |
|  | `4001012a` | `bnez a5,400100ee` | ″ | не взят |
| 49: `inc_even();` | `4001012c` | `jal 4001002c` | ″ | прямой → 4001002c |
| 18: `__attribute__((noinline)) static void inc_even(void) { acc += 2; }` | `4001002c` | `lui a4,0x40020` | ″ | дальше |
|  | `40010030` | `lw a5,8(a4)` | ″ | дальше |
|  | `40010034` | `addi a5,a5,2` | ″ | дальше |
|  | `40010036` | `sw a5,8(a4)` | ″ | дальше |
|  | `4001003a` | `ret` | ″ | косвенный → 4001012e (U-ADDR) |
| 50: `acc += bits(pat == 0xFFFFFFFF ? i : pat);` | `4001012e` | `lw a5,0(s1)` | `0c 63` DirectBranch ICNT=24 | дальше |
|  | `40010132` | `bne a5,s4,400100f8` | ″ | не взят |
|  | `40010136` | `mv a0,s6` | ″ | дальше |
|  | `40010138` | `j 400100fc` | ″ | прямой → 400100fc |
|  | `400100fc` | `jal 40010086` | ″ | прямой → 40010086 |
| 29: `uint32_t len = nbits;` | `40010086` | `lui a5,0x40020` | ″ | дальше |
|  | `4001008a` | `lw a2,4(a5)` | ″ | дальше |
| 30: `for (uint32_t b = 0; b < len; b++) {` | `4001008e` | `beqz a2,400100b4` | ″ | не взят |
|  | `40010090` | `li a5,0` | ″ | дальше |
| 28: `uint32_t r = 0;` | `40010092` | `li a3,0` | ″ | дальше |
| 31: `if (x & (1u << (b & 31))) {` | `40010094` | `li a1,1` | ″ | дальше |
