radiolok/rln-trace/doc/beu1000-trace-journal.md

# BE-U1000: журнал приёма трассы N-Trace

Продолжение [трассы STM32](slogic-trace-journal.md): тот же приёмник на SLogic16U3, но источник —
RISC-V микроконтроллер BE-U1000 («Байкал Электроникс») на отладочной плате EVU-BA-2.5, протокол —
RISC-V N-Trace через PIB (Pin Interface Block). Блоки **«Для статьи»** — повороты и находки, из
которых потом складывается рассказ.

Источники:

- [BE_U1000_tech_v_1_8.pdf](https://mcu.baikalelectronics.ru/storage/files/BE_U1000_tech_v_1_8.pdf) — даташит МК (ID BE-U-DS-RU#1737, v1.8);
- [EVU-BA-2.5_Tech.pdf](https://mcu.baikalelectronics.ru/storage/files/EVU-BA-2.5_Tech.pdf) — описание платы (BE-U-TD-RU#1734, v2.5.4), на
  стр. 24–28 — **принципиальная схема** (листы 1–5 из 7; без неё вывод про QSPI-флеш ниже не
  получился бы);
- [BE-U1000_RM_v.1.3.0.pdf](https://mcu.baikalelectronics.ru/storage/files/BE-U1000_RM_v.1.3.0.pdf) — Reference Manual (BE-U-RM#1740,
  v1.3.0): гл. 5 — CRU (такты, выводы), гл. 16 — Tracer;
- Baikal MCU SDK — подмодуль [`au/mcu-sdk`](../au/mcu-sdk) (тег 2.4.0, [gitflic](https://gitflic.ru/project/baikalelectronics/mcu-sdk)):
  OpenOCD с конфигами BE-U1000 лежит в нём самом, тулчейн `riscv32-none-elf` (GCC 15.2) — вложенный
  подмодуль на 1,7 ГБ, на Linux — тег `2.4.0_lin` (см. [`au/README.md`](../au/README.md)). Начинали с
  архива SDK 2.3.0 с сайта Байкала (распакован в `~/.local/opt/baikal-mcu-sdk-2.3.0`; тот же OpenOCD,
  компилятор даёт побайтно тот же код прошивки) — инструменты берут его, если подмодуль не развёрнут;
- [`au/riscv-nexus-trace`](../au/riscv-nexus-trace) — подмодуль со спецификациями RISC-V Trace Control
  Interface (регистры) и N-Trace (протокол), там же эталонный кодер/декодер `refcode/c/NexRv*`.

## Итог

### Шаг 2: ядро 200 МГц, BTM и HTM, фильтры (2026-10-25)

Ядро 0 — PLL 200 МГц (шина и периферия 100 МГц), трасса — `tclk` 50 МГц. Прошивка та же, но в цикле
добавлена `bits(i)`: внутренний цикл на `nbits` шагов с ветвлением по битам `i` (2 условных перехода
на шаг); `nbits` и `pat` (фиксированный узор вместо `i`) меняются по SBA на ходу. Все записи ниже
разобраны до инструкций **без единой ошибки пути**; где были потери (Error), декодер перезапускался
по следующей синхронизации.

**BTM против HTM.** Трафик — байт трассы на восстановленную инструкцию; полоса PIB на 50 МГц —
400 Мбит/с, ядро на 200 МГц выполняет ~200 млн инструкций/с, т. е. без потерь проходит не больше
~2 бит на инструкцию.

| `nbits` (условных на проход) | BTM, бит/инстр | HTM, бит/инстр | HTM легче в | Потери BTM (Error за 0,65 мс) | Потери HTM |
|---|---|---|---|---|---|
| 0 (2) | 4,65 | 4,24 | 1,1 раза | 243 | 163 |
| 8 (18) | 3,21 | 1,97 | 1,6 раза | 142 | 0 |
| 32 (66) | 2,92 | 1,12 | 2,6 раза | 201 | 0 |
| 128 (258) | 2,86 | **0,68** | **4,2 раза** | 172 | 0 |

Выигрыш HTM целиком зависит от кода: HTM сжимает только условные переходы (бит в HIST вместо
сообщения DirectBranch на каждый взятый), а косвенные — возвраты, вызовы через указатель — стоят
столько же. В цикле с 4 косвенными переходами на проход разница 1,6 раза; «раза в 3» и больше — на
коде, где условных переходов на порядок больше, чем вызовов и возвратов. **BTM на ядре 200 МГц не
пролезает в 50 МГц PIB ни на каком коде, HTM — на всём, кроме кода из одних вызовов.**

**Stall** (`TR_TE_INST_STALL_EN`, `nbits` = 8): BTM без stall — 1,68 млн проходов/с и 172 Error за
запись; со stall — 1,31 млн (**−22 %**) и ни одной потери; HTM со stall и без — 1,67 млн, потерь нет
(ядро не ждёт). `TR_TE_INST_STALL_OR_OVERFLOW` (бит 12) при этом выставлен.

Исходник → инструкция → сообщение → декодер, BTM (`runs/beu1000/table-btm.md`, полностью — 120
строк). Сообщение стоит у первой инструкции блока, который оно описывает (приходит после последней):

| Исходник `main.c` | Адрес | Инструкция | Сообщение N-Trace | Декодер |
|---|---|---|---|---|
| 51: `ops[i % 3]();` | `4001011c` | `lw a5,0(a5)` | `10 20 05 64 07` IndirectBranch BTYPE=0 ICNT=18 UADDR=0xb2 | дальше |
| 44: `for (uint32_t i = 0;; i++) {` | `4001011e` | `addi s6,s6,1` | ″ | дальше |
| 51: `ops[i % 3]();` | `40010120` | `jalr a5` | ″ | косвенный → 4001004c (U-ADDR) |
| 20: `__attribute__((noinline)) static void op_a(void) { acc ^= 0x5A; }` | `4001004c` | `lui a4,0x40020` | `10 91 dc 0b` IndirectBranch BTYPE=0 ICNT=9 UADDR=0x16e | дальше |
|  | `40010050` | `lw a5,8(a4)` | ″ | дальше |
|  | `40010054` | `xori a5,a5,90` | ″ | дальше |
|  | `40010058` | `sw a5,8(a4)` | ″ | дальше |
|  | `4001005c` | `ret` | ″ | косвенный → 40010122 (U-ADDR) |
| 45: `n = i;` | `40010122` | `sw s6,12(s5)` | `0c 17` DirectBranch ICNT=5 | дальше |
| 46: `if (i & 1)` | `40010126` | `andi a5,s6,1` | ″ | дальше |
|  | `4001012a` | `bnez a5,400100ee` | ″ | взят → 400100ee |
| 47: `inc_odd();` | `400100ee` | `jal 4001003c` | `10 91 a4 0f` IndirectBranch BTYPE=0 ICNT=9 UADDR=0x1d2 | прямой → 4001003c |
| 19: `__attribute__((noinline)) static void inc_odd(void) { acc += 1; }` | `4001003c` | `lui a4,0x40020` | ″ | дальше |
|  | `40010040` | `lw a5,8(a4)` | ″ | дальше |
|  | `40010044` | `addi a5,a5,1` | ″ | дальше |
|  | `40010046` | `sw a5,8(a4)` | ″ | дальше |
|  | `4001004a` | `ret` | ″ | косвенный → 400100f0 (U-ADDR) |
| 50: `acc += bits(pat == 0xFFFFFFFF ? i : pat);` | `400100f0` | `lw a5,0(s1)` | `0c 13` DirectBranch ICNT=4 | дальше |
|  | `400100f4` | `beq a5,s4,40010136` | ″ | взят → 40010136 |
|  | `40010136` | `mv a0,s6` | `0c 43` DirectBranch ICNT=16 | дальше |
|  | `40010138` | `j 400100fc` | ″ | прямой → 400100fc |
|  | `400100fc` | `jal 40010086` | ″ | прямой → 40010086 |
| 29: `uint32_t len = nbits;` | `40010086` | `lui a5,0x40020` | ″ | дальше |
|  | `4001008a` | `lw a2,4(a5)` | ″ | дальше |

То же место в HTM (`runs/beu1000/table-htm.md`): условные переходы молчат, их исходы — биты HIST в
ближайшем IndirectBranchHist (здесь 18 исходов `bits()` и проверки `pat` в одном сообщении из 9 байт,
против девяти DirectBranch в BTM):

| Исходник `main.c` | Адрес | Инструкция | Сообщение N-Trace | Декодер |
|---|---|---|---|---|
| 51: `ops[i % 3]();` | `4001011c` | `lw a5,0(a5)` | `10 20 05 40 07` IndirectBranch BTYPE=0 ICNT=18 UADDR=0xa0 | дальше |
| 44: `for (uint32_t i = 0;; i++) {` | `4001011e` | `addi s6,s6,1` | ″ | дальше |
| 51: `ops[i % 3]();` | `40010120` | `jalr a5` | ″ | косвенный → 4001005e (U-ADDR) |
| 21: `__attribute__((noinline)) static void op_b(void) { acc = acc << 1 | acc >> 31; }` | `4001005e` | `lui a4,0x40020` | `10 c1 f8 0b` IndirectBranch BTYPE=0 ICNT=12 UADDR=0x17c | дальше |
|  | `40010062` | `lw a5,8(a4)` | ″ | дальше |
|  | `40010066` | `lw a3,8(a4)` | ″ | дальше |
|  | `4001006a` | `slli a5,a5,0x1` | ″ | дальше |
|  | `4001006c` | `srli a3,a3,0x1f` | ″ | дальше |
|  | `4001006e` | `or a5,a5,a3` | ″ | дальше |
|  | `40010070` | `sw a5,8(a4)` | ″ | дальше |
|  | `40010074` | `ret` | ″ | косвенный → 40010122 (U-ADDR) |
| 45: `n = i;` | `40010122` | `sw s6,12(s5)` | `70 e1 19 0b` IndirectBranchHist BTYPE=0 ICNT=14 UADDR=0xc HIST=2 | дальше |
| 46: `if (i & 1)` | `40010126` | `andi a5,s6,1` | ″ | дальше |
|  | `4001012a` | `bnez a5,400100ee` | ″ | HIST 0: не взят |
| 49: `inc_even();` | `4001012c` | `jal 4001002c` | ″ | прямой → 4001002c |
| 18: `__attribute__((noinline)) static void inc_even(void) { acc += 2; }` | `4001002c` | `lui a4,0x40020` | ″ | дальше |
|  | `40010030` | `lw a5,8(a4)` | ″ | дальше |
|  | `40010034` | `addi a5,a5,2` | ″ | дальше |
|  | `40010036` | `sw a5,8(a4)` | ″ | дальше |
|  | `4001003a` | `ret` | ″ | косвенный → 4001012e (U-ADDR) |
| 50: `acc += bits(pat == 0xFFFFFFFF ? i : pat);` | `4001012e` | `lw a5,0(s1)` | `70 20 15 a0 0d 5c a4 14 07` IndirectBranchHist BTYPE=0 ICNT=82 UADDR=0x1d0 HIST=285271 | дальше |
|  | `40010132` | `bne a5,s4,400100f8` | ″ | HIST 0: не взят |
|  | `40010136` | `mv a0,s6` | ″ | дальше |
|  | `40010138` | `j 400100fc` | ″ | прямой → 400100fc |
|  | `400100fc` | `jal 40010086` | ″ | прямой → 40010086 |
| 29: `uint32_t len = nbits;` | `40010086` | `lui a5,0x40020` | ″ | дальше |
|  | `4001008a` | `lw a2,4(a5)` | ″ | дальше |
| 30: `for (uint32_t b = 0; b < len; b++) {` | `4001008e` | `beqz a2,400100b4` | ″ | HIST 0: не взят |
|  | `40010090` | `li a5,0` | ″ | дальше |
| 28: `uint32_t r = 0;` | `40010092` | `li a3,0` | ″ | дальше |
| 31: `if (x & (1u << (b & 31))) {` | `40010094` | `li a1,1` | ″ | дальше |
|  | `40010096` | `j 400100a0` | ″ | прямой → 400100a0 |
|  | `400100a0` | `sll a4,a1,a5` | ″ | дальше |
|  | `400100a4` | `and a4,a4,a0` | ″ | дальше |
|  | `400100a6` | `bnez a4,40010098` | ″ | HIST 0: не взят |
| 35: `r ^= b;` | `400100a8` | `xor a3,a3,a5` | ″ | дальше |
| 30: `for (uint32_t b = 0; b < len; b++) {` | `400100aa` | `addi a5,a5,1` | ″ | дальше |
|  | `400100ac` | `bne a2,a5,400100a0` | ″ | HIST 1: взят → 400100a0 |
| … | | | | |

### Что из N-Trace реализовано в BE-U1000

Проверено открытием (записать единицы, прочитать) и опытами; RM v1.3.0 местами ошибается.

| Возможность (Trace Control Interface / N-Trace 1.0) | BE-U1000 | Как проверено |
|---|---|---|
| Режимы `trTeInstMode` | **3 — BTM, 6 — HTM** (0..2 → 0, 3..5 → 3, 6..7 → 6). RM: «2 — HTM» — неверно | запись всех значений |
| Формат | только N-Trace (`trTeFormat` = 1) | запись 7 → 1 |
| Периодическая синхронизация `trTeInstSyncMode/Max` | поля записываются (режимы 1–3) | по сообщениям, 2⁸ — в работе |
| Stall (`trTeInstStallEna`) | **есть**, работает | −22 % скорости, 0 потерь |
| Переполнение | Error (ETYPE 0, ECODE 4) + синхронизация с **SYNC = 5**, а по спецификации должно быть 7 | ядро 200 МГц, BTM |
| Триггеры → trace on/off (`trTeInstTrigEnable`) | **есть** (бит 11 записывается, в RM — нет) | см. «Фильтры» |
| Поле SRC (`trTeSrcBits/ID`, `trTeInhibitSrc`) | нет: SRC_BITS = 0; InhibitSrc записывается, но ни на что не влияет | открытие |
| Ownership / контекст (`trTeContext`) | нет (только чтение, 0) | открытие |
| `trTeInstFeatures`: NoAddrDiff, implicit return, branch prediction, jump target cache, repeated history, all jumps, extend MSB | **ничего** (регистр — нули, запись не держится) | открытие |
| RepeatBranch, HREPEAT | не встречаются (repeated history нет) | — |
| Фильтры `trTeInstFilters`, `trTeFilter*`/`trTeComp*` (0x400–0x7FF) | **нет** | открытие |
| Трасса данных `trTeData*` | **нет** | открытие |
| Внешние триггеры `trTeTrig*` (0x50–0x58) | нет | открытие |
| Метки времени `trTs*` | есть: 32 бита, пределитель 1/4/16/64, считает только тип 2 (системная шина, `hclk`); тип 3 (такт ядра) и 4 стоят. **В каждом сообщении — абсолютное значение**, по спецификации вне синхронизаций должна быть разница | запись `trTsEnable`, ×1,8 трафика |
| HIST | 32 бита (31 исход + стоп-бит) | порог: `nbits` 14 → 15 |
| ResourceFull по HIST | **без TCODE** и с молчаливым сбросом I-CNT — см. запись «ResourceFull без заголовка» | `pat`, перебор |
| ResourceFull по I-CNT (RCODE 0) | не вызывали (нужен линейный код длиннее предела I-CNT) | — |
| Сообщения, встреченные на линиях | DirectBranch 3, IndirectBranch 4, Error 8, ProgTraceSync 9, IndirectBranchSync 12, IndirectBranchHist 28, ProgTraceCorrelation 33 (EVCODE 4 при trace-off), ResourceFull (без TCODE) | записи `runs/beu1000/` |
| SYNC | 2 — периодическая **и** trace-notify (должно быть 6), 5 — включение трассы **и** после переполнения (должно быть 7) | опыты |
| PIB | только 4 бита, без делителя; регистры повторяются каждые 8 байт по всему окну 4 КБ | открытие |
| RAM-приёмник | только SRAM (`HAS_SRAM`), `Limit` фиксирован (0x3FC), `WP`/`RP` записываются | открытие, в работе не проверяли |
| Выбор ядра | `SYSCR0.TRACESEL` (CRU) или `TRACE_SEL` 0x4000_A014 — последний виден только ядру 2 (у ядра 0 там ROM) | чтение |

### Фильтры

Собственных фильтров у кодера нет — ни адресных диапазонов (`trTeFilter*`), ни компараторов
(`trTeComp*`), ни фильтра по режиму привилегий. Остаётся то, что даёт отладочный модуль RISC-V:

- **Триггеры ядра с действием trace-on / trace-off / trace-notify** (Debug Spec, `mcontrol.action`
  2/3/4). У ядра 0 **четыре** триггера, все `mcontrol` (`tinfo` = 4), и они минимальные: только
  точное совпадение адреса (`match` = 0; «≥», «<», маски и NAPOT не держатся), **без цепочек**
  (`chain`), без сравнения данных (`select`) и без `timing`; зато выполнение, чтение и запись и выбор
  режима M/S/U. Итого фильтр — четыре точки «адрес → включить / выключить / пометить», диапазон
  адресов одним условием не задать.
- Включаются битом `trTeInstTrigEnable` (11), `trTeInstTracing` при этом не ставится — его дёргают
  триггеры. Опыт: trace-on на входе в `op_a`, trace-off на входе в `op_c` — трасса включается **на**
  первой инструкции `op_a` (ProgTraceSync, SYNC = 5, I-CNT = 0, F-ADDR = `op_a`) и выключается
  **после** первой инструкции `op_c` (ProgTraceCorrelation, EVCODE = 4, I-CNT = 2, пустой HIST): за
  запись `op_c` попала в трассу ровно одной инструкцией `lui` 340 раз из 340 входов, остальные её
  инструкции — ни разу. Трафик — 2,42 бит/инстр против 1,97 без фильтра (каждое включение — полная
  синхронизация, 7 байт).
- trace-notify на `op_b` — синхронизация с полным адресом сразу после первой инструкции `op_b` на
  каждый вход (340), трасса не прерывается; код причины — SYNC = 2, а не 6.
- Программно: регистры трассера видны ядру (0x1510_4000 в его карте памяти), так что программа может
  сама ставить и снимать `trTeInstTracing` вокруг нужного участка. Не проверяли.

### Шаг 1: трасса инструкций N-Trace на 25 и 50 МГц (2026-10-25)

Источник — своя прошивка [`fw/main.c`](../tools/slogic/trace/beu1000/fw/main.c) в TCMA ядра 0 (ядро на
`sys_clk` 25 МГц от CLKI): цикл с условным переходом по чётности счётчика и вызовом через указатель
`ops[i % 3]`. Трассер — branch trace (BTM), периодическая синхронизация каждые 2⁸ сообщений,
настраивается по SBA с ПК, ядро не останавливается. Приёмник — тот же образ `tracela.v`, режим 2
(IDDR от TRACECLK), IODELAY 224, разбор — [`ntrace.py`](../tools/slogic/trace/beu1000/ntrace.py): MSEO →
сообщения → поля → путь программы по ELF.

| `tclk` (= TRC_CLK) | Запись (65 536 полубайт) | Сообщений | Инструкций | Ошибок пути | Порядок `op_a→op_b→op_c` |
|---|---|---|---|---|---|
| 25 МГц, `sys_clk` | ~1,3 мс, простоя 67 % | 3185 | 21 629 | 0 | 848 вызовов, 0 нарушений |
| 25 МГц, PLL 200 / 8 | ~1,3 мс | 3186 | 21 364 | 0 | 838 / 0 |
| 50 МГц, PLL 200 / 4 | ~0,65 мс, простоя 83 % | 1591 | 11 495 | 0 | 451 / 0 |

Все периодические синхронизации (`ProgTraceSync`, SYNC = 2) пришли ровно туда, куда декодер дошёл
сам по I-CNT. **На 50 МГц трасса чистая** — дальше упирается в жгут, как и у STM32. Записи —
`tools/slogic/trace/runs/beu1000/`, разбор первой — `runs/beu1000/show.txt`.

### Что выяснили на железе

- **TRC_CLK = `tclk`**, данные по обоим фронтам: один байт трассы на такт `tclk`. Делителя в PIB нет
  (`TR_PIB_DIVIDER` = 0, только чтение), режим — только 4 бита. Скорость задаёт `tclk` из CRU:
  `CLKSEL.TCLK_SEL` (0 — `sys_clk`, 1 — делитель от PLL) и `CLKCR1.TCLKDIV`; максимум по RM — 100 МГц.
- **TRC_CLK идёт, только когда трассеру есть что слать** (включён кодер или калибровка). При
  включённом PIB и выключенном кодере линии и такт стоят — при первом заходе это выглядело как «от PLL
  такта нет».
- **Данные меняются по фронту TRC_CLK, а не в середине бита**, хотя `TR_PIB_CLK_CENTER` читается как 1.
  Смена приходит на 0,6–2,2 нс позже фронта (на входе ПЛИС; D0 и D2 позже D1 и D3), одинаково на 25 и
  50 МГц. Приёмник выбирает данные **после** смены: IODELAY 176–255 (2,2–3,2 нс) годится для всех
  линий; до следующей смены — полбита (10 нс на 50 МГц).
- **Калибровка есть, но бит не там, где в RM.** Запись бита 9 (`TR_PIB_CALIBRATE` по RM) читается
  как бит 8, а узор `A 5 A 5 0 F F 0` из спецификации идёт на линии — при работающем трассере.
- `TR_TE_INST_MODE`: 3 — branch trace, 6 — branch history, как в спецификации (RM пишет 2 — это не
  держится; поправлено на шаге 2).
  `trTeImpl` = 0x101 (версия 1.0, тип 1), `trRamImpl` = 0x1901 (только SRAM), `trTsControl` = 0x2000_0000
  (счётчик меток времени 32 бита).
- BE-U1000 **сбрасывается при каждом запуске OpenOCD** с конфигом платы (FTDI DD7 дёргает nSRST при
  входе в MPSSE): настройки трассера, сделанные одним запуском, к следующему пропадают. Отсюда —
  постоянный сервер OpenOCD (`ocd.py`).

### Шаг 0: что читали и куда подключать (2026-10-25)

Подключение (подробно — в «Стенд»): **PB0–PB3 → CH8–CH11, PB4 → CH12, земля — XP10 контакты 4 и 20**,
всё на разъёме XP10 платы. **Перед подключением — снять R5 (22 Ом)** у QSPI-флеш DD1, иначе трасса
пойдёт и во флеш (см. запись «Где взять PIB на плате»).

План первого опыта: режим калибровки PIB (`trPibCalibrate`) — он не требует ни кодера, ни
работающей программы, только два регистра PIB; на линиях должен крутиться узор `A 5 A 5 0 F F 0`.

## Что выяснили о трассе BE-U1000 (по документам, до железа)

*Написано до Reference Manual и до железа; поправки — в «Что выяснили на железе» выше.*

### Блок трассировки

- Ядра 0 и 1 (CloudBEAR BR-350, RV32IMCBFNAU[P], до 200 МГц) отдают трассу через интерфейс RVT в
  общий **Tracer**. Трассер **в каждый момент работает только с одним из ядер 0 или 1**. Ядро 2
  (BM-310, «PIO-ядро») трассы не имеет, зато в его собственном окне 0x4000_A000 лежит блок
  «PIO, Software JTAG и **Trace Select**» — видимо, это и есть переключатель ядра для трассера.
- Компоненты трассера в карте памяти ядер 0/1 (область высокоскоростной периферии):

| Адрес | Компонент (даташит) | Компонент по Trace Control Interface | Обязательные регистры |
|---|---|---|---|
| 0x1510_4000 | Tracer encoder control interface | Trace Encoder | `trTeControl` +0x000, `trTeImpl` +0x004 |
| 0x1510_5000 | Tracer RAM control interface | Trace RAM Sink | `trRamControl`, `trRamImpl`, `trRamStart/Limit/WP` |
| 0x1510_6000 | Tracer PIB control interface | Trace PIB Sink | `trPibControl` +0x000, `trPibImpl` +0x004 |
| 0x1510_7000 | Tracer SRAM interface | (окно в буфер RAM-приёмника) | — |

  Воронки (Funnel) и моста ATB нет: один кодер — один приёмник за раз. Сверка на железе — по
  `tr??Impl[11:8]` (тип компонента): кодер `0x1`, PIB `0xA`; `trTeImpl[3:0]` = 0 означает
  доратификационную версию 0 (SiFive, 2020) — тогда раскладка битов другая.
- Доступ внешнего отладчика к этим регистрам по спецификации — через **SBA** (System Bus Access)
  отладочного модуля RISC-V, т. е. чтение/запись памяти, пока ядро бежит. Альтернатива — программа
  на самом ядре пишет регистры сама (так было с ITM/ETM на STM32).

### PIB по спецификации

`trPibControl` (0x1510_6000):

| Биты | Поле | Что ставим |
|---|---|---|
| 0 | `trPibActive` | 1 — вывести из сброса (ждать, пока прочитается 1) |
| 1 | `trPibEnable` | 1 — последним, после настройки и запуска приёмника |
| 3 | `trPibEmpty` (RO) | 1 — буферы пусты |
| 7:4 | `trPibMode` | **10 = TRC_CLK + 4 TRC_DATA** (WARL: записать и прочитать — принято ли) |
| 8 | `trPibClkCenter` | **1 — фронт TRC_CLK в середине бита** (WARL, может не быть) |
| 9 | `trPibCalibrate` | 1 — узор калибровки вместо трассы |
| 14:12 | `trPibAsyncFreq` | частота вставки байтов простоя для выравнивания |
| 31:16 | `trPibDivider` | делитель входного такта: f = f_in / (N + 1); ширина и источник такта — по реализации |

Порядок: Active → (Mode, Divider, ClkCenter, Calibrate) → запустить приёмник → Enable.

- **Данные идут по обоим фронтам TRC_CLK (DDR), как у TPIU STM32.** При `trPibClkCenter` = 0
  фронты TRC_CLK совпадают со сменой данных, бит = период делённого такта, TRC_CLK = f / 2. При
  `trPibClkCenter` = 1 TRC_CLK вдвое медленнее (f / 4) и его фронты — в середине бита.
- **Для нашего приёмника нужен `trPibClkCenter` = 1.** Режим 2 приёмника (IDDR от TRACECLK)
  защёлкивает данные фронтом такта, а IODELAY двигает выборку максимум на 255 × 12,5 пс ≈ 3,2 нс.
  При ClkCenter = 0 и TRC_CLK 25 МГц полбита — 10 нс: задержкой не дотянуться, нужен сдвиг такта
  на 90° через PLL ПЛИС (спецификация так и предлагает пробникам). Если бит WARL не примется —
  делать PLL.
- Порядок бит: байт идёт младшим полубайтом вперёд, TRC_DATA[0] — младший бит. Как у TPIU.
- Калибровка в 4-битном режиме: байты `5A 5A F0 0F` → на линиях `A, 5, A, 5, 0, F, F, 0` по
  кругу. Готовый тест проводки и перестановки линий (то, что на STM32 пришлось делать перебором
  24 перестановок по `FF 7F`).

### Протокол N-Trace на линиях

- Сообщение — последовательность байт; в каждом байте **MSEO[1:0] — два младших бита, MDO[5:0] —
  шесть старших**. MSEO = 00 — первый байт сообщения и байты полей фиксированной длины; 01 —
  последний байт поля переменной длины; 11 — последний байт сообщения; 10 — резерв.
- Простой — байт `0xFF` (MSEO = 11, MDO = 111111). Кадров форматтера, ID источников и
  синхронизации `FF FF FF 7F` нет вообще: выравнивание — по простоям.
- **Простой может быть любым числом фронтов, в том числе нечётным** (раздел «PIB Idle Cycles
  Explained»): в 4-битном режиме следующее сообщение может начаться на любом полубайте. Значит,
  разбор не может резать поток на байты один раз — после каждого простоя выравнивание заново:
  первый полубайт с младшими битами ≠ `11` после серии `F` — начало сообщения (MSEO = 00).
  Для 1/2/4-битных режимов PIB обязан периодически вставлять хотя бы один байт простоя и всегда —
  перед синхронизирующим сообщением.
- Первый байт: MSEO = 00, MDO = TCODE (6 бит). Эталонный декодер `NexRv` умеет разбирать поток
  байт и восстанавливать путь программы по ELF — его и берём за образец.

## Стенд

Стенд трассы BE-U1000

*Схема — `tools/diagrams/beu1000_bench.py` (подписи поверх раскладки стенда прозвонки).*

| EVU-BA-2.5, XP10 | Вывод МК (корпус QFN-88) | Функция (АФ4 порта PB) | SLogic | Шарик ПЛИС |
|---|---|---|---|---|
| 1 | PB0 (12) | PIB_D[0] | CH8 | N11 |
| 2 (на рисунке платы подписан «GPIO 1») | PB1 (11) | PIB_D[1] | CH9 | P11 |
| 3 | PB2 (9) | PIB_D[2] | CH10 | N10 |
| 19 | PB3 (8) | PIB_D[3] | CH11 | P10 |
| 6 | PB4 (7) | PIB_CLK | CH12 | N9 (вход глобального такта) |
| 4, 20 | — | GND | GND | |

Распределение каналов — как у STM32 (`LANES = "0123"`, такт на CH12), приёмник менять не надо.
PB3 стоит на другом конце разъёма (контакт 19), поэтому и вторая земля — с контакта 20, рядом с ним.

Плата: загрузка — сценарий «JTAG EXT» (перемычки XP1 DBG-M2-M1-M0 = 0100), отладчик — FTDI DD7 на
плате через XS2 (JTAG на PA0–PA4). Тактирование — от генератора 25 МГц (перемычка CLK на XP1
снята): для трассы нужен стабильный такт, внутренний RC-генератор 12–32 МГц плавает.

## 2026-10-25. Где взять PIB на плате

У BE-U1000 три варианта выводов PIB (табл. 3-2 и 5-4/5-5 даташита):

| Вариант | Выводы | АФ | Что ещё на этих выводах на EVU-BA-2.5 |
|---|---|---|---|
| PB0–PB4 | D0–D3, CLK | АФ4 | QSPI1 → флеш DD1 (MT25QL128), XP10 |
| PC11–PC15 | D0–D3, CLK | АФ3 | PC13 — кнопка SB1 с RC-цепочкой; PC15 — EN ключа питания USB (DD4); XP8 |
| PC0–PC4 | D0–D3, CLK | АФ5 | PC0 — светодиод LD1; PC4 — перемычка MODE[2] (при «JTAG EXT» стоит, подтяжка к 3,3 В); PC0–PC3 — ещё и вариант JTAG |

Вариант PC0–PC4 отпадает сразу: PIB_CLK на выводе конфигурации загрузки с внешней подтяжкой.

**Для статьи: трасса, которая стирает флеш.** На блок-схеме платы у порта B нарисована QSPI-флеш,
и по схеме видно, что она висит прямо на будущих линиях трассы: PB0 — её S# (выбор кристалла),
PB1 — такт C, PB2 — DQ0, PB3 — DQ1 (выход флеш!), PB4 — W#/DQ2, PB5 — HOLD#/DQ3. Последовательные
0 Ом R53, R47–R51 у выводов МК не спасают — разъём XP10 по схеме подключён после них, на стороне
флеш. Если пустить трассу как есть, флеш видит на S#, C и DQ0 случайный поток: рано или поздно
она получит «чтение» и начнёт выдавать данные на DQ1 навстречу PIB_D[3] (два выхода друг против
друга через 22 Ом — ошибки в трассе и ток через выводы), а в quad-режиме — и на DQ0–DQ3. Хуже
того, случайная пара команд «разрешить запись» + «стереть» — и флеш потеряет содержимое. Перевести
её программно в глубокий сон тоже не выход: выход из сна — однобайтовая команда `0xAB`, которая в
случайном потоке рано или поздно встретится.

Лечится одним резистором: **S# флеш подтянут к 3,3 В резистором R4 10 кОм на стороне флеш, а к PB0
идёт через R5 22 Ом.** Снять R5 — флеш навсегда не выбрана, её выходы в третьем состоянии, остальные
линии видят только входы флеш (единицы пФ) и отводы 22 Ом. Цена — недоступна загрузка «QSPI»;
вернуть — запаять R5 обратно (или 0 Ом).

Вариант PC11–PC15 требует двух переделок вместо одной: у кнопки SB1 на PC13 стоит гасящая цепочка
100 Ом + 100 нФ на землю (на 25 МГц это просто 100 Ом на землю — PIB_D[2] будет убит), её отрезать
снятием R22 (0 Ом); PC15 через R43 (0 Ом) управляет ключом питания USB OTG — PIB_CLK стал бы дёргать
VBUS на XS1. Плюс выводы PC11–PC14 — ещё и запасной JTAG. Поэтому — **PB0–PB4 и снятый R5.**

## Инструменты и команды

Файлы — в [`tools/slogic/trace/beu1000/`](../tools/slogic/trace/beu1000/).

| Файл | Что делает |
|---|---|
| `openocd.cfg` | OpenOCD SDK к BE-U1000 через FTDI платы: без остановки ядра, свои порты (6668/4446/3337), `riscv virt2phys_mode off` и `set_mem_access sysbus` для CORE_0 — память читается на бегущем ядре |
| `trace.tcl` | процедуры: `pll nr nf od`, `core cdiv pdiv` (ядра и шина от PLL), `tclk src [div]`, `pins [ds]` (АФ4 на PB0–PB4, крутизна), `pib_on`, `te_on [mode sync syncmax stall trig]`, `te_off`, `trig_set idx addr act`, `trig_clear`, `discover base` (открытие по спецификации), `tr_status` |
| `ocd.py` | постоянный OpenOCD в фоне и команды ему через Tcl-порт (каждый новый запуск сбрасывает МК) |
| `fw/` | источник: `main.c` (известная последовательность ветвлений; `pat` 0x4002_0000, `nbits` 0x4002_0004, `n` 0x4002_000C), `start.S`, `link.ld` (код в TCMA, данные в TCMB) |
| `ntrace.py` | `cal` — окно каждой линии по IODELAY на узоре калибровки; `cap`/`decode` — MSEO → сообщения → поля (табл. N-Trace 1.0) → путь программы по ELF (BTM и HTM, ResourceFull без TCODE, RepeatBranch, Error, остановка трассы) с проверкой синхронизаций и порядка вызовов; `table` — исходник → инструкция → сообщение → декодер. `cap --save` кладёт копию ELF рядом с записью |

```sh
cd tools/slogic/trace
export RLN_BEU_USB=1-1 RLN_FPGA_USB=1-2    # две одинаковые FT2232H: плата и наша (места на шине USB)
make -C beu1000/fw
openFPGALoader -c ft2232 --busdev-num 1:$(cat /sys/bus/usb/devices/1-2/devnum) -m gw/tracela.fs

python3 beu1000/ocd.py "halt; load_image $PWD/beu1000/fw/trace.elf; reg pc 0x40010000; resume"
python3 beu1000/ocd.py "pins 3; pll 1 48 6; tclk 1 4; pib_on; te_on 3 1 4; tr_status"   # 50 МГц
python3 beu1000/ocd.py "core 1 2; te_off; te_on 6 1 4 0"   # ядро 200 МГц, HTM (stall — 4-й аргумент)
python3 beu1000/ocd.py "wr 0x40020004 32"                  # nbits
python3 beu1000/ocd.py "te_off; te_on 6 1 4 0 1; trig_set 0 0x4001004c 2; trig_set 1 0x40010076 3"  # фильтр
python3 beu1000/ocd.py 'discover $TR_TE'                   # открытие компонента
python3 beu1000/ocd.py 'wr $TR_PIB 0x203'          # калибровка (бит 9, читается как 8)
python3 beu1000/ntrace.py cal                      # окно линий
python3 beu1000/ocd.py 'wr $TR_PIB 3'              # обратно в трассу
python3 trace.py freq                              # TRC_CLK — строка «в домене TRACECLK»; читать дважды
python3 beu1000/ntrace.py cap --dly 224 --save runs/beu1000/x.json
python3 beu1000/ntrace.py table runs/beu1000/table-m6.json --start 0x4001011c --skip 3 --count 120
python3 beu1000/ocd.py --stop
```

Через USB 3.0 (образ `usb3d`, Windows; `PY` — Python Windows, как в README):

```sh
openFPGALoader -c ft2232 --busdev-num 1:$(cat /sys/bus/usb/devices/1-2/devnum) -m ../usb3/usb3d.fs
"$PY" $(wslpath -w ../usb3/host/usb3d.py)                                       # TRACECLK, счётчики
"$PY" $(wslpath -w ../usb3/host/usb3d.py) --dly 208 208 208 208 cap -s 1 -o 'C:\Users\Public\nt.bin'
python3 beu1000/ntrace.py decode /mnt/c/Users/Public/nt.bin --words 0 --limit 0   # ~37 с на 50 МБ
```

Грабли:

- частотомер ПЛИС обновляется раз в 0,56 с: сразу после перенастройки показывает старый такт;
- `trace.py` и `openFPGALoader` без указания адаптера берут первую FT2232H — может оказаться плата;
- `pkill -f` по имени конфига убивает и собственный шелл (в его командной строке та же строка);
- `set_mem_access` из `taps.cfg` SDK применяется к последней созданной цели (CORE_2), не к CORE_0;
- Windows видит SLogic16U3 как неизвестное устройство 0000:0002 — так и должно быть: USB у прибора
  делает сама ПЛИС, а в образе `tracela` его нет; заводской анализатор возвращается передёргиванием
  питания (образ — только в SRAM);
- адреса переменных прошивки сдвигаются при правках `main.c` — смотреть `nm fw/trace.elf`;
- компилятор вставляет свои условные переходы (`beqz len`, проверка `pat`) — их исходы тоже в HIST;
- стандартный `EVU_BA_2_5.cfg` SDK после сброса выводит PIB_CLK ещё и на PC4 (`IOAFCR4` = 0x88858888) —
  это вывод загрузочной перемычки MODE[2].

## 2026-10-25. Подключение: OpenOCD, сбросы, первый такт

В WSL не было ни одного USB-устройства — обе FT2232H (плата и наша для ПЛИС) были расшарены в
usbipd, но не подключены. Серийников у них нет, отличаются только местом на шине; плата — 1-1, наша —
1-2 (проверено: на 1-2 отвечает TAP Gowin `0x0001681b`). В цепочке JTAG платы три TAP с ID `0x1bafa001`
(ядра 2, 1, 0). `SBCS` отладочного модуля = 0x20040407: SBA есть, адрес 32 бита, доступ 8/16/32.

Первые же записи в регистры «не держались»: PIB, только что включённый, в следующем запуске снова
читался в сбросе. Списал было на смену такта, но метка в `IODSCR1` показала: **сбрасывается весь
кристалл при каждом запуске OpenOCD**. Дальше — один сервер на всю работу.

Ядро 0 после «JTAG EXT» стоит в загрузочном ROM на `0x4000124C` (шаг отладчиком не сдвигает PC — `wfi`
или переход на себя). Такт ядра проверен по `mcycle`: 55,1 млн тактов за ~2,1 с — 25 МГц, т. е.
`sys_clk` от CLKI (`SYSSR0.STRAP` = 0b00100: «JTAG EXT», CLK_STRAP = 0).

**Для статьи: калибровка, которой «нет».** По RM бит `TR_PIB_CALIBRATE` — девятый. Пишу `0x203`
(Calibrate + Enable + Active) — читается `0x1A3`: девятого бита нет, зато появился восьмой
(`TR_PIB_CLK_CENTER`, «только чтение, всегда 1»). Линии данных стоят. Вывод напрашивался — калибровки
нет. Но стоило включить кодер, и на линиях пошёл узор — сначала `a5f55ff0`, а при IODELAY 255 —
ровно `A 5 A 5 0 F F 0` из спецификации. Калибровка есть, просто идёт только при работающем
трассере, а бит в регистре читается со сдвигом.

## 2026-10-25. Окно линий и первая трасса

Перебор IODELAY на узоре калибровки (`ntrace.py cal`, 25 МГц): при крутизне выводов 0 (4,5 мА) D1 и D3
верны при 0–32 и 144–255, D0 — только 240–255, D2 — 208–255: смена данных приходит почти на фронт
TRC_CLK, и D0/D2 запаздывают. Крутизна 3 (18 мА) сдвинула смены на ~0,8 нс раньше: все четыре линии
верны при 176–255. На 50 МГц — те же 176–255 (смена на фиксированной задержке от фронта, а не в
середине бита). Рабочая точка — IODELAY 224.

После снятия калибровки — один простой: ядро в ROM крутится на месте, а у `wfi`/`j .` сообщений в
branch trace нет. С прошивкой `fw/` пошли сообщения: DirectBranch (TCODE 3), IndirectBranch (4) и
ProgTraceSync (9).

**Для статьи: байт за байтом.** Сообщение `10 e1 2b` (возврат из `inc_even`):

| Байт | MSEO | MDO | Что в нём |
|---|---|---|---|
| `0x10` | 00 — начало | 000100 | TCODE = 4, IndirectBranch |
| `0xE1` | 01 — конец поля | 111000 | B-TYPE = 00 (обычный косвенный переход), I-CNT = 1110 = 14 полуслов |
| `0x2B` | 11 — конец сообщения | 001010 | U-ADDR = 0xA → XOR 0x14 с прошлым адресом: `0x400100C6 ^ 0x14 = 0x400100D2` |

Периодическая синхронизация `24 89 a0 00 20 00 83`: TCODE 9, SYNC = 2, I-CNT = 2, F-ADDR = 0x40010050
(середина `op_a`) — полный адрес, от которого декодер стартует и с которым сверяется на ходу.

**Для статьи: трасса снова сама себя проверяет.** Три свидетельства, что разбор верен: каждая
периодическая синхронизация совпадает с адресом, куда декодер дошёл сам; последняя инструкция каждого
блока — именно тот переход, о котором сообщение (условный для DirectBranch, `ret`/`jalr` для
IndirectBranch); и вызовы `op_a → op_b → op_c` идут по кругу без пропусков — 848 подряд.

## 2026-10-25. Ядро 200 МГц: BTM, stall, HTM

`core 1 2` — ядра от PLL 200 МГц, шина и периферия 100 МГц (как `QSPI_clk_init` в SDK, но без
перезапуска PLL). Цикл прошивки — 1,68 млн проходов/с. BTM без stall: 172 Error за запись, после каждой —
синхронизация, декодер восстанавливается; со stall — ни одной потери ценой 22 % скорости ядра.

**Для статьи: HTM, которого нет.** RM v1.3.0: «`TR_TE_INST_MODE` 0x2 — Branch History Messaging,
0x3 — Branch Trace». Пишу 2 — читается 0, трассы нет. Перебор всех восьми значений: 0–2 → 0, 3–5 → 3,
6–7 → 6. Поле — ровно по спецификации (6 — HTM), RM ошибся в цифре. С `te_on 6` пошли
IndirectBranchHist (TCODE 28).

## 2026-10-25. ResourceFull без заголовка

На `nbits` = 32 HTM перестал сходиться, а в потоке появились пары сообщений с TCODE 33
(ProgTraceCorrelation — «трасса остановлена»), которых тут быть не должно: в паре первое меняется от
прохода к проходу, второе — постоянно; поле одно, переменной длины, 30 бит. И I-CNT в следующем
IndirectBranchHist — 14, хотя должен покрывать весь цикл `bits()`.

**Для статьи: сыщик с известным ответом.** Подбирать раскладку по случайным `i` — гадание, поэтому
прошивке дали переменную `pat`: при `pat` ≠ 0xFFFFFFFF в `bits()` идёт фиксированный узор, и
последовательность исходов известна заранее до бита. Дальше — по шагам:

1. Порог: `nbits` 14 (29 исходов на проход) — всё в IndirectBranchHist; 15 (31 исход) — появляется
   сообщение с первым байтом `04` (TCODE 1); 16 — `84` (TCODE 33). Бит 5 первого байта меняется с
   данными — значит, он **не TCODE**.
2. `pat` = 0, 1, 0x2000, 0x4000, 0x8000 при `nbits` = 16 (ожидается: `beqz` 0, пары `01`…, конец `00`):
   поле читается как HIST по стандарту (старший бит — стоп, под ним первый исход, младший — последний),
   но начинается **с бита 4** первого байта: при `pat` = 0x4000 первый байт стал `c4` — это исход
   `bnez` шага 14, и в следующем IndirectBranchHist осталось ровно три исхода вместо четырёх.
3. Итог: младшие 4 бита — `0001`, дальше 32 бита HIST. Это поля ResourceFull по спецификации — RCODE = 1
   (4 бита) и RDATA = HIST, — **но без 6-битного TCODE 27 впереди**. Отсюда и «TCODE 1/33»: в
   заголовок попадают RCODE и первые два бита истории.
4. I-CNT: после такого сообщения следующий IndirectBranchHist несёт I-CNT = 14 — ровно от условного
   перехода, который заполнил HIST, до `ret` (1+1+2+2+1+1+1+1+2+1+1 полуслов). Кодер **сбрасывает I-CNT
   на заполнении HIST, не передавая его** (по спецификации I-CNT сбрасывается только после передачи).
   Декодировать всё равно можно: идти по коду, пока не уйдёт последний бит HIST, — блок кончается на
   переходе, который его взял.

После этого все записи с ResourceFull разбираются без ошибок: `nbits` 15, 16, 32, 128, все `pat`.
Отличить такое сообщение от настоящего ProgTraceCorrelation можно по числу полей (у того их два —
I-CNT и HIST — плюс EVCODE/CDF), при включённых метках времени — пока нет (не проверяли).

## 2026-10-25. Фильтры и метки времени

Открытие (`discover`) показало, что у кодера кроме `trTeControl`, `trTeImpl` и `trTsControl` нет ничего:
окно 0x400–0x7FF (фильтры, компараторы), триггеры 0x50–0x58, трасса данных, `trTeInstFeatures` —
нули и запись не держат. Фильтровать можно только триггерами ядра — подробности в «Фильтры» выше.

**Для статьи: фильтр из отладчика.** Две строки — `trig_set 0 op_a 2` (trace-on) и `trig_set 1 op_c 3`
(trace-off) — и трасса идёт только от входа в `op_a` до входа в `op_c`. Кодер при этом делает всё
по спецификации: на выключении — ProgTraceCorrelation с причиной «трасса выключена», I-CNT и
пустым HIST (декодер знает, где остановилось), на включении — синхронизация с полным адресом.

Метки времени: `trTsControl` — тип 2 (системная шина), ~25 МГц на `hclk` = `sys_clk`, 100 МГц после
`core 1 2`. С `trTsEnable` поле TSTAMP приходит в **каждом** сообщении, и всегда абсолютное (6840276,
6840288, …), — трафик HTM вырос с 1,97 до 3,55 бит/инстр, пошли потери (47 Error). По спецификации
абсолютная метка нужна только в синхронизациях, в остальных — разница с предыдущей.

## 2026-10-26. Трасса через USB 3.0: usb3d вместо буфера в ПЛИС

Тот же стенд, но в SLogic16U3 вместо `tracela` (буфер в ПЛИС, выгрузка по JTAG) — образ `usb3d`: IDDR → FIFO →
EP1 IN по USB 3.0 на Windows (`tools/slogic/usb3/host/usb3d.py cap`). `ntrace.py decode` теперь принимает и сырой
`.bin` из `usb3d.py cap` (слова little-endian, тот же порядок полубайтов, что у режима 2 `tracela`).

Методика:

1. BE-U1000: прошивка `fw/`, `pins 3; pll 1 48 6; tclk 1 4; pib_on; te_on 3 1 4` — branch trace, TRC_CLK 50 МГц.
2. SLogic: `usb3d.fs` в SRAM; `usb3d.py` — частотомер показал 50,000 МГц (pclk-домен, точнее, чем OSC у tracela).
3. Окно IODELAY — перебором прямо по USB: на узоре калибровки (`wr $TR_PIB 0x203`) задержка 0…248 шагом 8,
   по 4 МБ на точку, ошибки по каждой линии отдельно (предсказание полубайта по трём предыдущим).
4. Трасса (`wr $TR_PIB 3`), `usb3d.py --dly 208 208 208 208 cap -s 1`, разбор `ntrace.py decode x.bin --words 0`.

Результат:

| Запись | Объём | Потерь | Сообщений | Инструкций | Ошибок пути |
|---|---|---|---|---|---|
| 3 × 1 с | по 50,6 МБ | 0 | по 2,59 млн | по 17,9 млн | 0 |
| 20 с | 1,0 ГБ (50,00 МБ/с) | 0 | хвост 50 МБ: 2,55 млн | 17,65 млн | 0 |

Порядок вызовов `op_a → op_b → op_c` — ни одного нарушения на ~200 тыс. вызовов в секунду. FIFO в ПЛИС за 20 с не
набрал больше одного слова: хост на 50 МБ/с успевает с огромным запасом (предел шины — 465 МБ/с). Длина записи теперь
ограничена только диском — у `tracela` было 32 К слов.

Находки:

- **Окно задержек зависит от образа.** У `usb3d` линии верны при IODELAY 168–255 (у `tracela` было 176–255): другая
  разводка — другие задержки от вывода до IDDR. При 0–16 и 104–160 D0 и D2 ловят соседний полубайт, при 40–64 — все
  четыре линии в другой фазе. Рабочая — 208, середина окна.
- **Калибровка при работающем кодере — не чистый узор.** Пока ядро гоняло прошивку, в узор
  `A 5 A 5 0 F F 0` подмешивались байты простоя `FF` (нерегулярно, раз в ~50 полубайт) и куски, похожие на
  данные сообщений, — ~0,1 % «ошибок» на всех линиях поровну и при любой задержке. Наутро (кодер стоял) узор
  шёл с простоем строго в каждом периоде, ошибок 0 на 23 МБ. Мерить окно линий — при остановленном ядре или
  считать только побитные расхождения внутри узора.
- **Потери были на стыках записи, не в потоке.** Первая версия `cap` включала источник до постановки чтений
  (FIFO 16 КБ переполнялся за 330 мкс) и снимала чтения до выключения источника — ~50 тыс. слов терялось в
  начале и в конце, и одна ошибка пути пришлась на такой стык. Теперь `usb3d.py` включает источник, когда чтения
  уже стоят в очереди, а в конце выключает его и дочитывает остаток: принято = отдано до слова.
- После ночи usbip-канал к адаптеру платы завис (`mpsse_flush` без прогресса) — OpenOCD пришлось перезапустить
  (сброс МК, прошивку и трассер — заново), `usbipd detach/attach` адаптера.

## 2026-11-13. Модель BE-U1000 в QEMU против кристалла

Никита Шубин выложил модель BE-U1000 для QEMU ([статья на Хабре](https://habr.com/ru/articles/1105944/),
ветка `n.shubin/landau/be-u1000-rc0` в `git.rulkc.org/pub/scm/landau/qemu/git/baikal/qemu.git`, машина `evu-ba`):
CLIC с изоляцией Core 0/1, MTIMER, CRU, UART, контроллер сброса; трассер, отладка и почти вся периферия — заглушки.
Одна и та же проба прогнана в модели и на плате — [`tools/slogic/trace/beu1000/probe/`](../tools/slogic/trace/beu1000/probe).

Методика:

1. Модель: `configure --target-list=riscv32-softmmu --enable-trace-cpu-filter`, `ninja qemu-system-riscv32`.
   На GCC 11.4 ветка не собирается (`-Werror=maybe-uninitialized` в `rmw_mie`/`rmw_hie`/`rmw_mieh`): `rmw_mie64` в
   режиме CLIC не заполняет `ret_val`, `csrr mie` отдаёт мусор со стека (`0xffff0aaa`) вместо нуля, как у `mip`.
   Поправлено локально (CLIC → 0, как у `mip`), в их репозиторий не отправлено.
2. `probe/qemu.S` — в eFLASH (`-device loader`, вектор сброса 0xa0000000), результаты в SRAM, чтение — `xp` из
   монитора (`make qemu`). Исключения — обработчик с `mepc += 4`, в слоте пробы — `mcause`.
3. Плата — `make hw`: `core0.S` в TCMA 0x40010000, `core2.S` — в TCMB Core 2 через окно Core 0 (0x70010000),
   запуск Core 2 — `SYSCR0 |= 0x60`, `SYSCR2 = 0x40008000`, `SYSCR0 |= 0x10`, отладчик держит его на векторе —
   `targets CORE_2; resume`. Первое исключение (чтение 0x30000000) — до любого обращения к `mnstatus`.

| | Кристалл | QEMU |
|---|---|---|
| Исключение у BR350 | в `mtvec` (`mcause` 0x30000005) | на 0: Smrnmi, после сброса `NMIE = 0` |
| `mnstatus` (0x744) | illegal instruction | есть |
| `mtvec` BR350 | режим CLIC намертво: пишем direct — читается `…303` | принимает direct |
| `misa` BR350 | 0x40903127: RV32IMAFCB + U, X | 0x4010112d: RV32IMAFDC + U |
| `misa` BM310 | 0x40101106: RV32IMCB + U | 0x40101125: RV32IMAFC + U |
| Триггеры | 4, `tinfo = 0x4` (только mcontrol), chain/match не держатся | 2, `tinfo = 0x44` (и mcontrol6) |
| Кодер 0x15104000 | 0x01000008 | 0: заглушка CORE2_PIO (0x151037f4 + 4 КБ) |
| RAM / PIB / SRAM трассера | 0x8 / 0xa8 / данные | access fault |
| QSPI0 0x11000000 | 0x01070000 | заглушка CORE2_TRACE (и CORE2_DEBUG там же) |
| Core Debug 0x0, BEU 0x02020000 | читаются (под отладчиком) | access fault |
| Код из SRAM на Core 0 | instruction access fault | исполняется |
| Core 2: TRACE_SEL, SWJTAG, PIO, mailbox | читаются (TRACE_SEL = 0) | access fault |
| Core 2: кодер и PIB | читаются | заглушка / fault |
| Core 2: SRAM 0x70000000 | access fault (`mtval` = pc) | доступна: у Core 2 вся шина |

**Для статьи:**

- **Модель придумала NMI, которого нет.** У BR350 включён Smrnmi: после сброса `NMIE = 0`, и первое же исключение
  уходит на RNMI-вектор — 0. В RM (6.1.1.1) — обычный NMI с `NMITVEC`, пишущий `MEPC`/`MCAUSE`; на кристалле
  `mnstatus` — illegal instruction, load fault честно приходит в `mtvec`.
- **Core 2 трассу не даёт, а управляет ею.** Источник трассы — только Core 0 или Core 1 (RM, гл. 16): Core 2
  выбирает его через TRACE_SEL (у себя по 0x4000A014; в CRU — `SYSCR0.TRACESEL`, сигналы по ИЛИ) и видит регистры
  кодера и PIB. Имя заглушки CORE2_TRACE в модели сбивает: «трассы Core 2» нет.
- **У Core 2 своё крошечное адресное пространство.** RM, табл. 3-2: ROM 16 КБ, TCMA 2 КБ, TCMB 8 КБ, PIO/SWJTAG/
  TRACE_SEL, mailbox — и трассер. SRAM и eFLASH ему не видны, код и данные ему кладёт Core 0 через окна
  0x7000F800 (TCMA) и 0x70010000 (TCMB). В модели — наоборот: вся шина есть, своих регистров нет.
- **Кристалл: SRAM не исполняется, `mtvec` только в режиме CLIC**, у BM310 `mtval` при load fault — pc, а не адрес.
- **ISA по `misa` расходится с моделью у обоих ядер**: у BR350 нет D, зато есть B и X; у BM310 нет A и F.

## Открытые вопросы

1. ~~Reference Manual~~, ~~отладчик~~, ~~такт PIB~~, ~~ClkCenter/Calibrate/InstMode~~ — см. «Что выяснили
   на железе».
2. ~~Ядро 200 МГц, stall~~, ~~HTM~~, ~~метки времени~~ — шаг 2.
3. ResourceFull по I-CNT (RCODE 0): тоже без TCODE? Нужен линейный код длиннее предела I-CNT.
4. ResourceFull без TCODE при включённых метках времени — как отличать от ProgTraceCorrelation.
5. Ядро 1 (`SYSCR0.TRACESEL`), RAM-приёмник (SRAM), программное управление трассой с самого ядра.
6. Для Байкала: калибровочный бит со сдвигом, ClkCenter не центрирует, ResourceFull без TCODE и сброс
   I-CNT, абсолютные метки времени, коды SYNC 2/5 вместо 6/7, номер HTM в RM; триггеры без chain, хотя RM
   обещает; `mtval` = pc у BM310.

## Что дальше

1. ~~Подключение, калибровка, трасса инструкций до 50 МГц~~ — сделано (шаг 1).
2. ~~Ядро на PLL 200 МГц, переполнение и stall; HTM; фильтры~~ — шаг 2.
3. Сверка с эталонным `NexRv` на тех же байтах (с поправкой на ResourceFull без TCODE).
4. Переходник — общий с STM32; на нём — `tclk` 66 и 100 МГц.
5. ~~Трасса через USB 3.0 без предела длины записи~~ — 50 МБ/с без потерь, 20 с подряд (`usb3d`). Дальше — HTM и
   метки времени на длинных записях, `tclk` выше 50 МГц на переходнике.
