radiolok/rln-trace/doc/jtag-journal.md

# JTAG цели: журнал

Свой движок отладки для зонда (шаг 6 [стенда](bench.md#отладка-swdjtag)). Цель — STM32F4-Discovery, зонд
пока на Tang Nano 9K; потом тот же движок переедет в SLogic16U3 с каналом команд по USB 3.0. Блоки
**«Для статьи»** — находки для рассказа.

## Шаг 1: OpenOCD через remote_bitbang и UART (2026-11-08)

**Что собрано.** Tang Nano 9K, образ [`top_jtag`](../gw/boards/tangnano9k/README.md#jtag-зонд-для-stm32f4-discovery-top_jtag).
Цепочка: OpenOCD (`remote_bitbang`) → TCP 3335 → [`sw/rbb/rbb_bridge.py`](../sw/rbb/rbb_bridge.py) → UART BL702 (канал B,
`/dev/ttyUSB1`) → [`uart_rx`](../gw/cores/uart_rx.sv) → [`rbb_jtag`](../gw/cores/rbb_jtag.sv) → выводы J5 → PA13/PA14/PA15/PB3/PB4/NRST.
Протокол — один байт ASCII на команду: `0`–`7` = {TCK, TMS, TDI}, `R` → `0`/`1`, `r`–`u` = {TRST, SRST}.
Ответы TDO копятся в очереди на 16 бит, так что `R` подряд не тормозит приём.

**Почему так.** Канал наружу у 9K — только UART BL702, а драйвер OpenOCD для протокола «байт на такт» уже
есть. Ни строчки C на ПК, проверять можно сразу настоящим OpenOCD. Движок здесь — просто регистр выводов.
Сдвиговое ядро, CMSIS-DAP и SWD — следующие шаги.

**Проверка.**
- Verilator: `make -C gw test-rbb` — все команды, 64 чтения TDO вперемешку с тактами. Отправитель на 3 %
  быстрее приёмника, очередь ответов при этом растёт.
- UART без потерь: 4000 `R` подряд — 4000 ответов. Тот же поток байт, что OpenOCD шлёт при `init`
  (снят заглушкой-сервером, 3273 байта, 1007 `R`), прямо в порт — 1007 ответов.
- OpenOCD: найдены обе TAP — `0x4ba00477` (JTAG-DP Cortex-M4) и `0x06413041` (граничное сканирование F407).
  `reset halt`, PC = 0x080002c0, UID `002a0019 32314714 31383435`, DBGMCU_IDCODE `0x10016413` (rev Z),
  `flash probe` — 1024 КиБ. Вся сессия — 1,5 с.

| UART | Чтение 16 КиБ ОЗУ (`dump_image`) | Скорость | `verify_image` (CRC на цели) |
|---|---|---|---|
| 1 Мбод (DIV 27) | 8,9 с | 1,8 КБ/с | 0,51 с |
| 3 Мбод (DIV 9) | 4,4 с | 3,7 КБ/с | 0,27 с |

Втрое быстрее UART — только вдвое быстрее чтение: остальное съедает задержка USB 1.1 у BL702 на каждом
обмене OpenOCD «отправил — жду TDO».

**Грабли.**
- **Первое открытие `/dev/ttyUSB1` после загрузки ПЛИС иногда молчит** — BL702 будто не берёт скорость.
  Повторное открытие работает. Мост теперь при старте шлёт `R` и переоткрывает порт, пока не придёт ответ.
  Самое первое зависание OpenOCD на `DR scan interrogation` было именно этим: команды уходили, ответы — нет.
- `ttyUSB0` — канал A BL702 (JTAG самой ПЛИС), на запись отвечает эхом `\xfa<байт>`. Не путать.
- `stm32f4x.cfg` меняет `adapter speed` в событиях reset-start и reset-init, а у `remote_bitbang` скорости
  нет — `reset halt` падает с «Translation from khz to adapter speed not implemented». В
  [`stm32f4-rbb.cfg`](../sw/rbb/stm32f4-rbb.cfg) те же события переопределены без смены скорости.
- После `resume` — сотня `DAP transaction stalled (WAIT)`: прошивка трассы ставит RCC_CFGR = 0x94f0
  (HCLK = HSI / 512 = 31 кГц), и доступы AP ждут ядро. Тот же эффект, что у ST-LINK; `halt` всё равно
  проходит. Подключение — под сбросом (`connect_assert_srst`).

**Для статьи.** Отладчик за вечер: 200 LUT, UART и драйвер OpenOCD, который был там всегда. Медленно —
3,7 КБ/с, но это настоящая сессия: IDCODE, halt, регистры, флеш. Узкое место — задержка обмена через USB,
а не JTAG: каждое чтение TDO — круг до ПК и обратно. Отсюда и следующий шаг — сдвиг в ПЛИС целыми словами.

## Шаг 1б: зонд настраивает трассу (2026-11-08)

`stm32cfg.py -f sw/rbb/stm32f4-rbb.cfg` (подмодуль, ключ `-f`) пишет режим трассы через 9K вместо ST-LINK:
TRACECLK на SLogic16U3 переключался 15,6 кГц → 8,17 → 1,01 → 49,84 МГц, порт 4/2/1 бит. Вся цепочка без
ST-LINK: свой зонд → цель → трасса → SLogic по USB 3.0. Чтение ОЗУ цели при HCLK 2 МГц иногда отдаёт нули
(при этом регистры отладки читаются) — разобрать вместе со сдвиговым ядром.

## Шаг 2: SWD через remote_bitbang (2026-11-08)

Те же провода: SWCLK = TCK (PA14), SWDIO = TMS (PA13). В [`rbb_jtag`](../gw/cores/rbb_jtag.sv) — SWD-команды
`remote_bitbang`: `O`/`o` (выход SWDIO вкл/выкл), `c` (чтение SWDIO), `d`–`g` ({SWCLK, SWDIO}); вывод TMS стал
двунаправленным (IOBUF, подтяжка). Конфиг — [`sw/rbb/stm32f4-rbb-swd.cfg`](../sw/rbb/stm32f4-rbb-swd.cfg).

- Тест `test-rbb`: 48 чтений `c` вперемешку с `R`, SWDIO и TDO меняются независимо.
- Грабли: `R` = 0x52 и `c` = 0x63 различаются не битом 1 (у обоих 1), а битом 5 — поймано при чтении
  кода до прогона.
- Железо: `SWD DPIDR 0x2ba01477`, `reset halt`, cfg прошивки (`RLNT`) читается. JTAG на том же образе — как
  раньше.

| Транспорт | Чтение 16 КиБ | Скорость |
|---|---|---|
| JTAG | 4,4 с | 3,7 КБ/с |
| SWD | 59 с | 0,28 КБ/с |

**Для статьи.** SWD через тот же «байт на такт» в 13 раз медленнее JTAG. Причина — в драйвере: bitbang-SWD
OpenOCD читает каждый бит SWDIO синхронно (`swdio_read` ждёт ответ), и каждый бит — круг через USB BL702.
Чтения JTAG OpenOCD копит и забирает пачкой. Протокол «бит за обмен» упирается в задержку, а не в полосу —
ровно то, что лечит сдвиговое ядро с транзакциями целиком.

## Шаг 3: CMSIS-DAP в ПЛИС, пакеты целиком (2026-11-08)

**Что собрано.** [`dap_core`](../gw/cores/dap_core.sv): буфер запроса и ответа (BSRAM, 512 байт), разбор команд
CMSIS-DAP v2 и сдвиговое ядро — бит за `half` тактов низкого и высокого TCK, вход через синхронизатор
(отсюда предел 27 МГц / 8). Transfer для SWD — с отложенными чтениями AP (данные чтения N приходят в
транзакции N+1, хвост забирается через RDBUFF) и повтором при WAIT. Ядро не знает про транспорт: вход —
запись в буфер и `req_go`, выход — чтение буфера по `resp_valid`. [`dap_uart`](../gw/cores/dap_uart.sv) — кадры
`[длина][пакет]` по UART BL702; в SLogic16U3 его место займёт bulk-эндпоинт USB 3.0 (CMSIS-DAP v2 — это
тот же пакет в bulk). Хост — [`sw/dap/dap_uart.py`](../sw/dap/dap_uart.py).

**Проверка.**
- Verilator `make -C gw test-dap`: модели цели на уровне выводов — DP (DPIDR, CTRL/STAT с подтверждением
  питания, RDBUFF) и MEM-AP (CSW, TAR с автоинкрементом, DRW) с отложенными чтениями и подставленными WAIT,
  TAP JTAG с IDCODE. Info, Connect, SWJ_Clock/Sequence/Pins, Transfer (чтения, записи, WAIT в пределах и
  сверх повторов), SWD_Sequence, JTAG_Sequence. Тест проверен на падение подменой ожиданий.
- Тот же тест на нетлисте после `yosys synth` — проходит.
- Железо, F407: DPIDR `0x2ba01477`, CTRL/STAT `0xf0000040`, слова флеша как у OpenOCD, DBGMCU_IDCODE
  `0x10016413`; JTAG IDCODE `0x4ba00477`. 4 КиБ флеша, прочитанные через DAP, совпали с `trace.elf` побайтно.

| Путь | SWCLK | Чтение ОЗУ |
|---|---|---|
| remote_bitbang, SWD | — | 0,28 КБ/с |
| remote_bitbang, JTAG | — | 3,7 КБ/с |
| CMSIS-DAP в ПЛИС, SWD | 1 МГц | 52 КиБ/с |
| CMSIS-DAP в ПЛИС, SWD | 3,375 МГц | 99 КиБ/с |

Пакет: запись TAR + 112 чтений DRW (ответ 451 байт); TAR переписывается на каждой границе 1 КиБ
(автоинкремент MEM-AP её не переходит).

**Грабли.**
- **Образ молчал** при живом тесте и живом нетлисте. Сброс шёл только с кнопки S1, а ПЛИС после загрузки
  стартует с нулей: `half` = 0 вместо делителя на 1 МГц, `tms_oe` = 0. Добавлен сброс на 16 тактов после
  конфигурации — в `top_dap` и `top_jtag` (там SWDIO мог висеть в Hi-Z до нажатия S1).
- После SWD порт SWJ-DP остаётся в SWD: перед JTAG нужна последовательность SWD→JTAG (`0xE73C`), иначе
  IDCODE = `0xffffffff`.

**Для статьи.** Тот же UART, те же провода, но 190-кратный выигрыш по скорости: запрос уходит пакетом,
ПЛИС сама проводит сотню транзакций SWD и возвращает ответ одним куском. Задержка USB теперь делится на
112 слов, а не платится за каждый бит.

## Шаг 4: SWO (2026-11-08)

**Что собрано.** [`swo_rx`](../gw/cores/swo_rx.sv): приёмник UART (NRZ) с фазовым аккумулятором вместо делителя —
скорость = step · 27 МГц / 2³², любая до 27 МГц / 8, step считает тот же делитель, что и для SWJ_Clock
(обобщён до 64-битного числителя). FIFO 8 КиБ в BSRAM, флаг переполнения. В [`dap_core`](../gw/cores/dap_core.sv) —
команды SWO_Transport (только через DAP_SWO_Data), SWO_Mode (UART; Manchester → 0xFF), SWO_Baudrate,
SWO_Control, SWO_Status, SWO_Data; Info: caps 0x07, размер буфера. Провод — тот же TDO: PB3 в SWD — TRACESWO.

**Цель.** Демо-прошивка (ITM-счётчик) на HSI / 1 без ETM; хост через DAP переключает TPIU: SPPR = 2 (NRZ),
FFCR = 0x100 (форматтер в обход — идёт чистый поток ITM), ACPR = 16 МГц / скорость − 1, TRACE_MODE = 0.
Всё делает `sw/dap/dap_uart.py --swo <скорость>`.

**Проверка.**
- Verilator: 300 случайных байт на 2,55 Мбод при заданных 2,5 (дробная длина бита, расхождение 2 %),
  Status/Data/Control, отказ Manchester и слишком высокой скорости.
- F407:

| SWO | Захват | Байт/с | ITM | Разрывы | Переполнение |
|---|---|---|---|---|---|
| 1 Мбод | 3 с | 97,6 кБ/с | 58 540 значений | 0 | нет |
| 2 Мбод | 0,3 с | 197,9 кБ/с | 11 883 | 0 | нет |
| 2 Мбод | 3 с | 196,1 кБ/с | 116 353 | 8 | да |

На 2 Мбод упирается не приём, а UART до ПК: 3 Мбод с кадрами и встречными запросами не вывозят 200 кБ/с, буфер
8 КиБ переполняется за десятки миллисекунд — флаг переполнения это и показывает. В SLogic16U3 поток пойдёт по USB 3.0.

**Грабли.**
- **Прошивка цели сама откатывала SWO.** Её проверка «трасса настроена» сравнивала ITM_TCR целиком, а бит 23 —
  BUSY: на медленном SWO ITM занят почти всегда, проверка проваливалась, и прошивка возвращала параллельный порт
  поверх настройки хоста (`reinit` растёт, SPPR снова 0). Исправлено в подмодуле: BUSY маскируется. Прошивка
  записана своим же зондом: `top_jtag` + OpenOCD по SWD (`program … verify` — 1 КиБ за несколько секунд).
- `verify_image` OpenOCD кладёт алгоритм в рабочую область с 0x20000000 — прямо на cfg демо-прошивки, а
  `shutdown` оставляет ядро остановленным. `--swo` теперь это видит и перезапускает цель через nRESET (SWJ_Pins).
- После сеанса DAP порт SWJ-DP остаётся в SWD, и OpenOCD с `transport select jtag` цепочку не видит
  (`all ones`): прошивать через `stm32f4-rbb-swd.cfg`.

**Для статьи.** SWO — второй выход трассы на том же проводе, что и TDO. Приёмнику не нужна точная
кратность частот: фазовый аккумулятор держит 2,55 Мбод на такте 27 МГц (10,6 такта на бит) без ошибок.

## Что дальше

1. ~~Сдвиговое ядро~~ — сделано вместе с CMSIS-DAP, шаг 3.
4. OpenOCD на `dap_core`: мост USB/IP (CMSIS-DAP v2 как USB-устройство) поверх UART — до переезда в SLogic16U3.
5. Transfer в режиме JTAG (pyOCD им пользуется), TransferBlock, WriteABORT.
2. ~~SWD на тех же выводах~~ — сделано, шаг 2.
3. Канал команд в SLogic16U3 по USB 3.0, протокол CMSIS-DAP v2.
