radiolok/rln-trace/doc/slogic-trace-journal.md

# SLogic16U3: журнал приёма трассы STM32

Продолжение [прозвонки входов](slogic-pinmap-journal.md): теперь на входы SLogic16U3 идёт
настоящий порт трассы TPIU от STM32F407, а ПЛИС принимает его своим образом. Блоки **«Для
статьи»** — повороты и находки, из которых потом складывается рассказ.

## Итог

### Шаг 1: данные идут (2026-10-25)

Приёмник — образ [`tracela.v`](../tools/slogic/trace/gw/tracela.v): пятиканальный логический
анализатор на внутреннем генераторе ПЛИС (~30 МГц), буфер 16 Кслов в BSRAM, выдача через
пользовательский JTAG. Источник — ITM-счётчик через TPIU, порт 4 бита, такт — HSI 16 МГц с
делителем AHB. Проверка — непрерывность 32-битного счётчика после разбора TPIU и ITM на ПК.

| Делитель AHB | HCLK | TRACECLK (частотомер ПЛИС) | Полупериод, тактов OSCB | Режим 0: значений / разрывов | Режим 1: значений / разрывов |
|---|---|---|---|---|---|
| 512 | 31,25 кГц | 15,5 кГц | 969 | 148 / 0 | 1762 / 0 |
| 256 | 62,5 кГц | 30,9 кГц | 485 | 147 / 0 | 1773 / 0 |
| 128 | 125 кГц | 61,8 кГц | 242 | 156 / 0 | 1772 / 0 |
| 64 | 250 кГц | 123,6 кГц | 121 | 155 / 0 | 1773 / 0 |
| 16 | 1 МГц | 494 кГц | 30 | 140 / 0 | 1759 / 0 |
| 8 | 2 МГц | 989 кГц | 15 | 144 / 0 | 1773 / 0 |
| 4 | 4 МГц | 1,98 МГц | 8 | 152 / 0 | 1758 / 0 |
| 2 | 8 МГц | 3,96 МГц | 4 | 142 / 0 | 1766 / 0 (dly 0; dly 1–2 — сбой, см. ниже) |
| 1 | 16 МГц | 7,91 МГц | 2 | 65 / 42 | 63 / 62 |

Режим 0 — запись моментов смены уровней, выборка на ПК в середине полупериода; режим 1 — выборка в
ПЛИС через dly тактов после фронта TRACECLK, 8 полубайт на слово.

**До TRACECLK 3,96 МГц приём чистый** на штатных проводах анализатора (~10 см, жгутом). Сбой на
7,9 МГц — предел самого приёмника, а не проводов: при ~30 МГц выборки на полупериод приходится два
такта. Где начнут сбоить провода, покажет только приём с тактированием от самого TRACECLK (шаг 2).

### Шаг 2: приём от TRACECLK (2026-10-25)

Режим 2 того же образа: TRACECLK (CH12, N9) — на глобальный такт ПЛИС, данные — через IODELAY
(своя задержка у каждой линии, 0–255 ступеней по ~12,5 пс) в IDDR, буфер 8 Кслов пишется тактом
TRACECLK. Источник — PLL STM32 от HSE 8 МГц, HCLK = SYSCLK (без делителя AHB), порт 4 бита.

| TRACECLK | Крутизна выводов STM32 «очень высокая» (OSPEEDR 3) | «Средняя» (OSPEEDR 1), худший шаблон данных |
|---|---|---|
| до 57 МГц | чисто при любой задержке 0–255 (кроме SYSCLK 168 МГц с делителем, см. ниже) | не проверяли |
| 61–62 МГц | ошибки зависят от данных: шаблон `0x55`/`0xAA` — 0, `0x0F` — 85–124 разрыва на ~880 значений | 0 разрывов |
| 66 МГц | сбой при любой задержке | 0 разрывов |
| 74–75 МГц | сбой | на грани: 2–98 разрывов, зависит от задержки и прогона |
| 83–84 МГц | сбой (простой порта `FF 7F` при этом без единой ошибки) | сбой: TRACECLK теряет ~3 % тактов (частотомер 80,6 МГц вместо 82,9) |

**На жгуте анализатора (~10 см, одна земля) чистый предел — около 57 МГц TRACECLK на самой быстрой
крутизне и около 66 МГц на средней.** Предел ставят одновременные переключения всех четырёх линий
данных (байт `0x0F` = полубайты `F`→`0`), т. е. наводки и земля в жгуте, а не момент выборки:
задержка выборки ошибок не убирает, а замедление фронтов — убирает. 84 МГц на этих проводах не
берётся ни так, ни так: быстрые фронты наводят, медленные не доводят до порога сам такт. Дальше —
переходник.

### Шаг 3: трасса инструкций ETM на 50 МГц (2026-10-25)

Рабочая точка до своей платы — **TRACECLK 50 МГц** (PLL 100 МГц, без делителя AHB, IODELAY 32):
на ней приём чистый с запасом. Прошивка включает ETM (ETMv3.5, ID шины 2) рядом с ITM (ID 1),
`trace.py show` разбирает запись на три уровня: поток TPIU → пакеты ITM и ETM → выполненные
инструкции по `trace.elf`. Одна запись (8 Кслов, ~650 мкс): 848 значений ITM без разрывов,
2523 байта ETM → 19 641 инструкция (E 19 424, N 217), ни одной потери адреса; периодический
I-sync совпал с адресом, до которого декодер дошёл сам; записей в `ITM_STIM0` по ETM — 496 =
31 пачка × 16, как в прошивке. Листинг — `tools/slogic/trace/runs/show.txt`.

### Что выяснили о порте TPIU STM32F407

- TRACECLK = HCLK / 2, данные по обоим фронтам (DDR): 4 бита × 2 фронта = HCLK / 2 байт/с.
- По спецификации ([SEGGER, Arm trace technical specification](https://kb.segger.com/Arm_trace_technical_specification))
  TRACECLK переключается по фронту такта процессора, данные — на полтакта раньше: на фронтах
  TRACECLK они стабильны, ts = th = ½ периода такта процессора. Измерено: на HSI / 512 данные
  меняются за 30–100 нс (1–3 такта OSCB, фаза 0,9–1,0 полупериода) до фронта TRACECLK — это ½
  периода **SYSCLK** 16 МГц (31 нс), а не HCLK (32 мкс). Так и выходит по перебору IODELAY (ниже):
  запас установки растёт с периодом SYSCLK, а не HCLK. Значит, «такт процессора» для TPIU —
  SYSCLK, и с делителем AHB данные не по центру: установка ½ T_SYSCLK, удержание — почти весь
  полупериод TRACECLK. Без делителя (HCLK = SYSCLK) — по центру, как на диаграмме спецификации.
  *Первая запись в журнале («данные меняются чуть раньше фронта, порт выровнен по фронтам») была
  неверным прочтением той же гистограммы — поправил пользователь.*
- В непрерывном режиме форматтера полная синхронизация `FF FF FF 7F` **не появляется вообще**
  (ни одной за 131 тыс. полубайт), только полуслова `FF 7F` — и TPIU вставляет их в простое в любом
  месте, в том числе внутри 16-байтного кадра.

## Стенд

```
                         USB (питание, отладчик)                      USB (питание)
 ПК (WSL) ◄──────────────────────────── ST-LINK                ПК ◄──────────── SLogic16U3
    ▲                                   │ SWD + NRST                                 ▲
    │                          STM32F4-Discovery                                     │ CH8–CH12, GND
    │                   PE2 TRACECLK, PE3–PE6 TRACED0–3, GND ────────────────────────┘
    │ USB                                                         отладочный разъём SLogic
    └──── FT2232H ── канал A: JTAG ───────────────────────────────── TCK TDI TDO TMS GND
```

| Discovery | Функция | SLogic | Шарик |
|---|---|---|---|
| PE2 | TRACECLK | CH12 | N9 (GCLKT_2, BPLL_T_IN0) |
| PE3 | TRACED0 | CH8 | N11 |
| PE4 | TRACED1 | CH9 | P11 |
| PE5 | TRACED2 | CH10 | N10 |
| PE6 | TRACED3 | CH11 | P10 |
| PD0–PD7 | (свободны) | CH0–CH7 | остались от прозвонки |
| GND | | GND | |

Первые опыты шли с PE5 на CH11 и PE6 на CH10 (см. «Первый захват»); провода переставлены
2026-10-25, после этого `LANES = "0123"`. Провода — штатные от анализатора, около 10 см, одним жгутом. PE3 на Discovery — ещё и CS
акселерометра; трассе это не мешает. PE2–PE6 — единственные выводы TRACECLK/TRACED у STM32F407
(AF0), выбора нет. TRACECLK выбран на CH12 потому, что N9 — вход глобального такта и PLL.

FT2232H на JTAG-разъёме SLogic — как при прозвонке ([разводка](slogic-pinmap-journal.md#стенд)).

## Инструменты и команды

Файлы — в [`tools/slogic/trace/`](../tools/slogic/trace/).

| Файл | Что делает |
|---|---|
| `stm32/main.c` | источник: ITM пишет счётчик в стимул-порт 0 пачками по 16, между пачками пауза; режим (такт, делитель AHB, ширина порта) — из структуры в RAM `0x20000000` |
| `gw/tracela.v`, `tracela.cst`, `tracela.sdc`, `gowin.tcl` | приёмник: режимы 0/1 (OSCB) и 2 (IODELAY → IDDR от TRACECLK), два буфера по 8192 × 32 бит (32 из 35 BSRAM), частотомер пяти линий по OSCB и TRACECLK в своём домене (код Грея), команды в ER2 (`0xA` — запись/чтение, `0xB` — IODELAY линии), чтение в ER1 |
| `gw/tb.v` | симуляция: синтетический поток TPIU (`trace.py encode`), три записи через модель TAP, дамп `gw/tb.fst` для wavepeek, разбор тем же `trace.py` |
| `trace.py` | режим источника через ST-LINK (такт, делитель, ширина, крутизна выводов, начальное значение счётчика, ETM), частотомер, запись и разбор TPIU/ITM, переборы: `sweep` (OSCB), `sweep2` (режим 2: частоты × задержки), `lanes` (окно каждой линии); `show` — пакеты ITM/ETM и инструкции (декодер ETMv3 по правилам OpenCSD, дизассемблер — `arm-none-eabi-objdump`); `table` — кусок трассы таблицей «исходник → инструкция → пакет ETM» |

```sh
cd tools/slogic/trace
O=~/.local/opt/oss-cad-suite/bin

# источник
make -C stm32
$O/openocd -f board/stm32f4discovery.cfg -c "reset_config srst_only srst_nogate connect_assert_srst" \
    -c "program stm32/trace.elf verify reset exit"

# приёмник: симуляция, сборка (Gowin EDA на диске C:), загрузка только в SRAM
python3 trace.py encode --out gw/stream.hex
iverilog -g2012 -o /tmp/tb gw/tb.v gw/tracela.v && vvp -n /tmp/tb -fst
for m in 0 1 2; do python3 trace.py decode gw/tb_m$m.hex; done
wavepeek change --waves gw/tb.fst --scope tb.dut --on 'negedge tck iff (en2_q && upd_q)' --signals sr,cmd,dls
B=/mnt/c/Users/Public/rln-tracela; rm -rf $B; mkdir -p $B; cp gw/gowin.tcl gw/tracela.v gw/tracela.cst gw/tracela.sdc $B/
(cd $B && /mnt/c/Gowin/Gowin_V1.9.12.04_x64/IDE/bin/gw_sh.exe gowin.tcl)    # → impl/pnr/tracela.fs
cp -f $B/impl/pnr/tracela.fs gw/ && chmod 644 gw/tracela.fs      # из Windows приходит только для чтения
$O/openFPGALoader -c ft2232 -m gw/tracela.fs

# опыты
python3 trace.py stm --src hsi --hdiv 512 --width 4   # минимальная скорость: TRACECLK 15,6 кГц
python3 trace.py freq                                 # частоты линий
python3 trace.py cap --mode 0 --save runs/x.json      # фаза данных, разбор
python3 trace.py cap --mode 1 --dly 480               # выборка в ПЛИС
python3 trace.py sweep                                # HSI / 512 … / 1, итоги в runs/sweep-hsi.json
python3 trace.py cap --mode 2 --iodelay 48 48 48 48   # IDDR от TRACECLK
python3 trace.py sweep2                               # частоты до PLL 168 МГц × IODELAY → runs/sweep2.json
python3 trace.py stm --src pll --pll-n 248 --hdiv 1 --n0 0x0f000000 --ospeed 1   # 62 МГц, худший шаблон
python3 trace.py stm --src pll --pll-n 200 --hdiv 1   # рабочая точка: TRACECLK 50 МГц, ITM + ETM
python3 trace.py show --save runs/x.json              # пакеты и инструкции → runs/show.txt
```

Грабли:

- ST-LINK не держит связь с ядром на HCLK в десятки кГц — режим источника пишется только под
  сбросом (`connect_assert_srst`), см. запись ниже;
- перестановка линий данных под проводку — `LANES` в `trace.py` или `--lanes` (записи
  `runs/*.json` и `sweep-hsi.json` сняты до перестановки проводов: разбирать с `--lanes 0132`);
- первый `freq` сразу после `stm` может захватить окно, в котором STM32 ещё стоял в сбросе, —
  частота занижена на проценты; читать второй раз;
- `cp` образа из папки сборки на диске C: молча не перезаписывает файл только для чтения — однажды
  так загрузился старый образ, и «режим 2» отработал как режим 1. После сборки — `cp -f` и
  `chmod`, после загрузки — проверить версию в заголовке;
- выше ~60 МГц ошибки зависят от данных: один захват ничего не говорит, сравнивать на одном
  шаблоне (`--n0`) и несколько раз.

## 2026-10-25. Источник: ITM-счётчик через TPIU

Прошивка [`stm32/main.c`](../tools/slogic/trace/stm32/main.c), 892 байта, без библиотек. Настройка
порта: PE2–PE6 в AF0 с максимальной крутизной, `DBGMCU_CR` — `TRACE_IOEN` и `TRACE_MODE` (1/2/4
бита), TPIU — `CSPSR` (ширина), `SPPR = 0` (параллельный порт), `FFCR = 0x102` (форматтер,
непрерывный режим), ITM — ID шины 1, стимул-порт 0. Полезная нагрузка — 32-битный счётчик:
разрыв на приёме сразу виден. Пачки по 16 значений с паузой: в паузе TPIU шлёт синхронизацию.

Самая низкая скорость, которую даёт STM32F407 без перенастройки отладки: HSI 16 МГц / 512 = HCLK
31,25 кГц, TRACECLK 15,6 кГц (с HSE 8 МГц / 512 — вдвое ниже, не пробовали). Верх — PLL 168 МГц,
TRACECLK 84 МГц.

**Для статьи: на 31 кГц отладчик теряет ядро.** План был менять режим на ходу: прошивка следит за
структурой в RAM, `trace.py` пишет в неё через OpenOCD. Сразу после прошивки OpenOCD перестал
подключаться (`init mode failed`), а с подключением под сбросом — `jtag status contains invalid
mode value - communication failure`, как только ядро уходит на HCLK 31 кГц. Доступ к памяти идёт
по шине AHB, а она тактируется от HCLK: ST-LINK V2J14 не дожидается ответа. Решение — режим пишется,
пока ядро стоит в сбросе (`reset_config srst_only srst_nogate connect_assert_srst`, `reset halt`):
до первой команды прошивки STM32 работает на HSI 16 МГц. Сброс по NRST RAM не стирает, прошивка
читает структуру при старте. Побочный бонус: каждое изменение режима — чистый старт.

OpenOCD при подключении переписывает `DEMCR`/DWT — прошивка проверяет `ITM_TCR`, `ITM_TER`,
`TRCENA`, `TRACE_IOEN` после каждой пачки и при сбое настраивает трассу заново (счётчик `reinit`
в структуре; за первый прогон — 3 раза).

## 2026-10-25. Приёмник, шаг 1: логический анализатор вместо приёмника

Сразу принимать TPIU тактированием от TRACECLK рано: неизвестно, как данные стоят относительно
фронтов (это решает, где брать выборку), и что вообще доходит через входные делители. Поэтому
первый образ — пятиканальный логический анализатор на OSCB (~30 МГц, см. прозвонку): режим 0
пишет время каждой смены уровней (27-битная метка + 5 линий), режим 1 — полубайт через dly тактов
после каждого фронта TRACECLK. Частотомер на всех пяти линиях работает всегда. Команды — 32-битным
словом в ER2 `GW_JTAG` (метка `0xA` в старших битах, эхо — в заголовке ER1: сразу видно, дошёл ли
TDI без сдвига), чтение буфера — блоками по 1024 слова через ER1.

Gowin EDA: 690 LUT, 535 регистров, **32 из 35 BSRAM** (буфер 16384 × 32 с двумя тактами: запись от
OSCB, чтение от TCK).

Симуляция [`tb.v`](../tools/slogic/trace/gw/tb.v) гоняет синтетический поток: `trace.py encode`
кодирует ITM-пакеты в кадры форматтера с синхронизацией, тестбенч выдаёт их на линии,
записывает в обоих режимах и сохраняет кадр ER1; разбирает тот же `trace.py decode`, что и
записи с железа. Обе записи дали 160 значений подряд — цепочка «линии → буфер → JTAG → разбор»
проверена до железа.

## 2026-10-25. Первый захват: HSI / 512

Загрузка в SRAM, частотомер: TRACECLK 15,16 кГц (в окно попал кусок сброса STM32 — повторное
чтение дало 15,5 кГц), все четыре линии данных переключаются. Эхо команды ER2 совпало — TDI
доходит без сдвига (в отличие от TDO, где у `GW_JTAG` первым идёт лишний бит).

Режим 0, фазы смен данных внутри полупериода TRACECLK:

```
  0.0–0.1     590 ######
  0.1–0.2…0.8–0.9  0
  0.9–1.0    5428 ############################################################
```

Данные меняются за 1–3 такта OSCB **до** фронта такта: это ½ периода SYSCLK 16 МГц, как и положено по
спецификации (см. «Что выяснили о порте TPIU»). На этой скорости окно данных — почти весь полупериод,
выборка в середине полупериода надёжна.

**Для статьи: синхронизация, которой нет.** Разбор искал полную синхронизацию TPIU `FF FF FF 7F` —
и не нашёл ни одной. В потоке полубайт — бесконечные `fffbfffbfffb…`. Полуслово синхронизации
`FF 7F` в полубайтах (младший вперёд) — `f f f 7`, у нас `f f f b`: 7 = `0111`, B = `1011` — ровно
переставлены биты 2 и 3. Перебор всех 24 перестановок линий: только одна — TRACED2 ↔ TRACED3 —
дала 148 значений счётчика подряд без разрывов, остальные — мусор. Значит, провода PE5 и PE6
пришли на CH11 и CH10 наоборот (прозвонка CH10/CH11 по частоте надёжна). Простой сигнал
синхронизации оказался заодно и тестом проводки.

Вторая находка там же: полной синхронизации в непрерывном режиме нет совсем, а полуслова `FF 7F`
TPIU вставляет в простое **в любом месте, в том числе внутри кадра**: между `03 03 E0 3D 00 00` и
следующим куском кадра. Разбор переделан: выбросить все полуслова `0x7FFF` (полуслово `FF 7F` в
настоящем кадре невозможно — байт `FF` на чётном месте значил бы смену ID на зарезервированный
0x7F), склеить остаток в 16-байтные кадры, начало кадра (одно из 8 положений) — по полной
синхронизации, если она есть, иначе по наибольшему числу непрерывных значений счётчика.

Режим 1 (dly 481 — середина полупериода): 131 072 полубайта, 742 кадра, 1758 значений подряд,
пропущенных фронтов 0.

## 2026-10-25. Перебор скоростей с OSCB

`trace.py sweep`: HSI / 512 … / 1, на каждом — частотомер, режим 0, режим 1 с задержкой из
режима 0. Итог — в таблице наверху. Частоты по частотомеру ниже расчётных на 1,1 % (HSI и OSCB
врут на проценты; на HSE можно было бы откалибровать OSCB — не делали).

До 1,98 МГц всё чисто в обоих режимах. На 3,96 МГц (полупериод 4 такта OSCB) режим 0 ещё
разбирается, а режим 1 сломался на **каждом** значении (451 разрыв из 452). Перебор dly 0–3:
dly 0 — 1766 значений подряд, dly 1 и 2 — сбой, dly 3 — ни одного слова (dly не меньше полупериода:
каждый новый фронт перезапускает ожидание, выборка не случается никогда). Причина — счёт задержки
на единицу: выборка в режиме 1 берётся через dly + 1 тактов после того, как фронт прошёл
синхронизатор, а `trace.py` считал через dly; при полупериоде 4 такта и данных, меняющихся перед
фронтом, это попадание в смену. Формула поправлена (`mode1_dly`).

На 7,9 МГц (2 такта на полупериод) не работает ничего — это предел выборки от OSCB, ожидаемый.

## 2026-10-25. Шаг 2: IDDR от TRACECLK

Образ v2: режим 2 — TRACECLK с N9 на глобальную сеть, данные через `IODELAY` (динамическая
задержка, 256 ступеней по ~12,5 пс, UG304 §4.4.1) в `IDDR` (Q0 — по фронту, Q1 — по следующему
спаду), четыре байта — слово в отдельный буфер с тактом TRACECLK. Частоту TRACECLK OSCB выше
~15 МГц не оцифрует, поэтому такты считаются в домене самого TRACECLK и переносятся в домен
OSCB кодом Грея. Ограничения — `tracela.sdc` (TRACECLK 84 МГц, домены асинхронны): Fmax домена
TRACECLK 235–298 МГц, нарушений нет; `IDDR` и `IODELAY` сели в IOLOGIC (4 из 53). Чтобы режимы 0/1
остались в том же образе, буфер OSCB уменьшен до 8 Кслов: оба буфера — 32 из 35 BSRAM.

Первая проверка на HSI / 512 — 877 значений подряд. Перебор `sweep2` (15 точек, задержки 0, 64,
128, 192, 255): до 57 МГц всё чисто, 61 МГц — только при задержке 32–64, с 65 МГц — сбой при
любой.

**Для статьи: ½ такта процессора — это SYSCLK.** В том же переборе на PLL 168 МГц **с делителем**
AHB (TRACECLK 5–40 МГц) большие задержки ломали приём даже на 5 МГц, а на PLL 50 МГц без делителя
проходили все. Точный перебор при близких HCLK (~10–12 МГц) и разных SYSCLK, задержка с шагом 16:
SYSCLK 168 МГц — граница на 112 ступенях (~1,4 нс), SYSCLK 100 и 50 МГц — граница дальше 255 (3,2
нс), HSI 16 МГц — тоже. Задержка данных в ПЛИС двигает точку выборки к предыдущей смене данных; запас
— это ts из спецификации TPIU (½ периода такта процессора) минус разница путей такта и данных в
ПЛИС. Он растёт с периодом SYSCLK, а не HCLK, — «тактом процессора» для TPIU служит SYSCLK, и с
делителем AHB данные стоят не по центру полупериода TRACECLK. (Пользователь поправил моё первое
прочтение гистограммы из шага 1 — «данные меняются у фронта» — ссылкой на диаграмму SEGGER.)

### Раздельные задержки и гонка в JTAG

Образ v3 — у каждой линии своя задержка (команда ER2 `0xB`), чтобы проверить, не съедает ли окно
разбег между линиями. В симуляции работало, на железе ER2 перестал принимать команды совсем (эхо
0, запись не запускается), хотя чтение ER1 работало, а образ v1 на том же стенде принимал команды.

**Для статьи: `tck_o` у `GW_JTAG` инвертирован.** Отладочные слова в заголовке (сдвиговый регистр
ER2 и счётчики) показали: принятая команда — отправленная, сдвинутая на бит (`0x40002468` вместо
`0xA0001234`), а после «исправления» (состояние TAP по спаду) — каждый бит склеен с соседним по ИЛИ
(`0x1234` → `0x367c`), то есть TDI брался в момент смены. Вместо догадок — образ с четырьмя
вариантами приёма параллельно (TDI по фронту или спаду `tck_o`, состояние напрямую, по фронту или
по спаду), все четыре регистра видны в ER1. Точную команду дал один: **состояние по фронту
`tck_o`, TDI по спаду**. Значит, спад `tck_o` — это фронт TCK на выводе (на нём TAP берёт TDI,
адаптер меняет TDI по спаду TCK). Логика по фронту `tck_o` попадает ровно на смену состояния TAP —
гонка, и исход зависит от разводки: v1 повезло, v3 нет. Отсюда же, вероятно, «лишний бит» на TDO
при прозвонке. Теперь вся JTAG-логика образа — по спаду `tck_o`, состояние TAP защёлкивается по
фронту (середина такта TCK); модель в `tb.v` переделана под настоящий порядок TAP (состояние — после
фронта TCK, TDI — по спаду), и её `tck_o` тоже инвертирован. Проверка в симуляции — через wavepeek:
264 такта сдвига на 8 команд (захват + 32), в Update-DR в регистре ровно отправленное слово. Сдвиг
на бит на TDO остался — метка `RLNA` нужна по-прежнему.

### Ошибки зависят от данных

Окно каждой линии на 61 МГц (`trace.py lanes`: три линии на 48, четвёртая — 0…255) вышло шумом:
одна и та же настройка (все на 48) в разных строках дала 3, 109, 0 и 68 разрывов. Строки снимались
подряд, а счётчик ITM за это время уходил в другие значения. Прошивка теперь принимает начальное
значение счётчика (`--n0`): при 124 МГц старший байт держится пару секунд. Тот же режим, задержка 48:

| Старший байт счётчика | Разрывов на ~880 значений (2 захвата) |
|---|---|
| `0x55` | 0, 0 |
| `0xAA` | 0, 0 |
| `0x00` | 0, 34; повтор — 0, 0 |
| `0xFF` | 0, 10; повтор — 0, 37 |
| `0xF0` | 10, 44 |
| `0x0F` | 85, 118 |

**Для статьи: виноваты не фазы, а одновременные переключения.** Байт `0x0F` в 4-битный порт уходит
полубайтами `F` и `0` — все четыре линии данных переключаются разом; у `0x55`/`0xAA` полубайты
одинаковые, линии внутри байта стоят. На 84 МГц простой порта (`fff7`, переключается одна D3) — без
единой ошибки на 26 тыс. выборок, а данные — в клочья. Это наводки и земля в жгуте из 10-см
проводов с одной землёй, задержкой выборки не лечится. Проверка — крутизна выводов STM32 (OSPEEDR,
поле `ospeed` в прошивке) на худшем шаблоне `0x0F`, задержки 0 и 48:

| TRACECLK | OSPEEDR 3 (очень высокая) | 2 (высокая) | 1 (средняя) |
|---|---|---|---|
| 62 МГц | 73, 106 разрывов | 124, 112 | **0, 0** |
| 66 МГц | 117, 53 | 134, 156 | **0, 0** |
| 75 МГц | 60, 73 | 122, 102 | 53, 2 |
| 84 МГц | 58, 38 | 140, 83 | 179, 147 |

Медленные фронты убирают ошибки до 66 МГц. На 75 МГц со средней крутизной — на грани (перебор
задержек 0…255: лучшая точка — 10 разрывов при задержке 32). На 84 МГц средняя крутизна уже не вытягивает сам
такт: частотомер ПЛИС насчитал 80,6 МГц вместо 82,9 — ~3 % периодов TRACECLK не доходят до порога.

Открытый вопрос: в режиме 2 на HSI / 512 разбор нашёл и полные синхронизации `FF FF FF 7F` (118 за
запись), хотя в шаге 1 на той же скорости — ни одной. Возможно, полная синхронизация попадает на
нечётный байт относительно полуслов и в шаге 1 её не распознавал разбор. Не разбирались.

## 2026-10-25. Шаг 3: ETM и трасса инструкций

Решено (пользователь): до своей платы работаем на 50 МГц; рекорды скорости — на ней.

Прошивка включает ETM-M4: `ETMCR` с битом программирования, ожидание `ETMSR.ProgBit`, триггер
«никогда» (`0x406F`), трасса всегда (`TEEVR = 0x6F`, `TECR1 = 0x01000000` — исключающий режим без
областей), ID шины 2, остановка ядра при почти полном FIFO (`ETMCR[7]`, `FFLR = 24`), без
широковещания ветвлений — прямые переходы декодер берёт из ELF. `ETMCR` снимает бит
программирования последней записью. Прошивка сохраняет `ETMIDR` в cfg: `0x4114F250` — ETMv3.5,
бит 20 — **альтернативное кодирование адреса ветвления** (последний байт сжатого адреса несёт 6 бит
и флаг исключения); от него зависит разбор адреса.

Декодер в `trace.py` написан по исходникам OpenCSD (`decoder/source/etmv3`): P-заголовок формата 1
`1NEEEE00` (до 15 E и один N), формата 2 `1000FF10`; один атом — одна инструкция; пакет адреса
ветвления (`…1`, до 5 байт, Thumb — сдвиг на 1) обновляет только переданные биты прошлого
выданного адреса и приходит после атома косвенного перехода; I-sync `08` + инфо + 4 байта адреса.
Восстановление инструкций — проход по дизассемблеру `objdump`: E на прямом переходе — в цель, на
косвенном (`bx`, `pop {…pc}`) — ждать пакет адреса, иначе — следующая инструкция.

### Примеры пакетов (запись `runs/show-50mhz.json`, TRACECLK 50 МГц)

**Кадр форматтера TPIU** — 16 байт, в которых перемешаны оба источника:

```
05 bc 03 03 b0 5f b2 06 03 03 b0 5f b2 06 05 68
```

| Байт | Значение | Что это |
|---|---|---|
| 0: `05` | чётный, бит 0 = 1 → смена ID на `05 >> 1` = 2 (бит 0 вспомогательного байта = 0: сразу) | дальше — ETM |
| 1: `bc` | данные ID 2 | P-заголовок ETM: 15 инструкций выполнены |
| 2: `03` | смена ID на 1 | дальше — ITM |
| 3: `03` | данные ID 1 | заголовок ITM: стимул-порт 0, 4 байта |
| 4–7: `b0 5f b2 06` | чётные байты теряют младший бит — он в вспомогательном: `b2` + бит 3 = `b3` | значение `0x06b35fb0` |
| 8–13: `03 03 b0 5f b2 06` | то же, младшие биты из вспомогательного байта: `b0`→`b1`, `b2`→`b3` | ITM: `0x06b35fb1` |
| 14: `05` | смена ID на 2, данных после неё в этом кадре нет | |
| 15: `68` = `01101000` | вспомогательный байт: младшие биты 8 чётных байтов | |

Между кадрами и внутри них в простое — полуслова синхронизации `ff 7f` (в сырых полубайтах
`ff7fff7f…`); полная `ff ff ff 7f` в этой записи — 674 раза.

**ITM** (ID 1):

| Байты | Разбор |
|---|---|
| `03 b0 5f b3 06` | заголовок `03`: программный источник, порт `03 >> 3` = 0, размер `03 & 3` = 3 → 4 байта; значение (младший вперёд) `0x06b35fb0` = 112 418 736 |
| `03 b1 5f b3 06` | следующее значение, +1 |

**ETM** (ID 2):

| Байты | Пакет | Разбор |
|---|---|---|
| `00 00 00 00 00 80` | A-sync | граница пакетов: пять нулей и `80`; до первой A-sync поток ETM не разбирается |
| `08 01 dd 03 00 08` | I-sync | `08` — заголовок, `01` — инфо (причина `00` — периодическая), адрес `0x080003dd`: бит 0 = Thumb, адрес инструкции `0x080003dc` (`reset`, пустой цикл паузы) |
| `bc` = `1 0 1111 00` | P-заголовок, формат 1 | `1 N EEEE 00`: 15 атомов E, без N — 15 инструкций выполнены |
| `cc` = `1 1 0011 00` | формат 1 | 3 E и один N: «EEEN» |
| `c8` | формат 1 | «EEN» — выход из цикла паузы (N — на `bne`) |
| `f0` | формат 1 | 12 E и N |
| `c0` | формат 1 | один N |
| `88`, `84` | формат 1 | «EE», «E» |

Частоты P-заголовков в записи: `bc` 1661, `cc` 125, `c8` 84, `f0` 42, `d4` 42. Формат 2
(`1000FF10`, два атома) и пакеты адреса ветвления в этой записи не встретились: в рабочем цикле
нет косвенных переходов (`bx lr` и `pop {…, pc}` — только в `apply_*`, они выполняются при старте).

### Исходник → ассемблер → пакеты ETM → декодер

Таблицы печатает `trace.py table runs/show-50mhz.json --start <адрес> --skip <n> --count <k>`
(строки исходника — `addr2line` по `trace.elf`, собранному с `-g`; код от `-g` не меняется,
бинарник сверен). Один байт P-заголовка покрывает до 16 инструкций: «″» — тот же пакет.

Конец пустого цикла паузы и выход из него (`--start 0x80003da --skip 35 --count 10`):

| Исходник `main.c` | Адрес | Инструкция | Пакет ETM (смещение: байт) | Атом | Декодер |
|---|---|---|---|---|---|
| 231: `for (volatile uint32_t i = CFG->idle; i; i--)` | `080003da` | `ldr r2, [sp, #4]` | 1076: `bc` = EEEEEEEEEEEEEEE | E (12/15) | дальше |
|  | `080003dc` | `subs r2, #1` | ″ | E (13/15) | дальше |
|  | `080003de` | `b.n 800035c` | ″ | E (14/15) | переход → 0800035c |
|  | `0800035c` | `str r2, [sp, #4]` | ″ | E (15/15) | дальше |
|  | `0800035e` | `ldr r1, [sp, #4]` | 1077: `c8` = EEN | E (1/3) | дальше |
|  | `08000360` | `cmp r1, #0` | ″ | E (2/3) | дальше |
|  | `08000362` | `bne.n 80003da` | ″ | N (3/3) | не выполнен → 08000364 |
| 233: `if (++blink >= 256) {` | `08000364` | `adds r6, #1` | 1078: `f0` = EEEEEEEEEEEEN | E (1/13) | дальше |
|  | `08000366` | `cmp.w r6, #256` | ″ | E (2/13) | дальше |
|  | `0800036a` | `bne.n 800037c` | ″ | E (3/13) | переход → 0800037c |

Одна запись в ITM внутри пачки (`--start 0x80003c8 --skip 1 --count 9`). Строка 223 у первой
`ldr` — компилятор поднял загрузку константы из соседнего кода (`-Os`):

| Исходник `main.c` | Адрес | Инструкция | Пакет ETM (смещение: байт) | Атом | Декодер |
|---|---|---|---|---|---|
| 223: `apply_trace();` | `080003c8` | `ldr r2, [pc, #44]` | 1084: `bc` = EEEEEEEEEEEEEEE | E (7/15) | дальше |
| 226: `while (!(ITM_STIM0 & 1u) && ++t < 100000)  // ITM выключен — не виснуть` | `080003ca` | `ldr r1, [r7, #0]` | ″ | E (8/15) | дальше |
|  | `080003cc` | `lsls r1, r1, #31` | ″ | E (9/15) | дальше |
|  | `080003ce` | `bmi.n 80003d4` | ″ | E (10/15) | переход → 080003d4 |
| 228: `ITM_STIM0 = n++;` | `080003d4` | `str r5, [r7, #0]` | ″ | E (11/15) | дальше |
|  | `080003d6` | `adds r5, #1` | ″ | E (12/15) | дальше |
|  | `080003d8` | `b.n 8000354` | ″ | E (13/15) | переход → 08000354 |
| 224: `for (uint32_t k = CFG->burst; k; k--) {` | `08000354` | `cmp r5, r3` | ″ | E (14/15) | дальше |
|  | `08000356` | `bne.n 80003c8` | ″ | E (15/15) | переход → 080003c8 |

Вся запись в ITM — 9 инструкций, 9 атомов E: ETM тратит на неё меньше байта, ITM — 5 байт.

**Для статьи: трасса сама себя проверяет.** Три независимых свидетельства, что декодер прав: (1)
периодический I-sync несёт полный адрес — он совпал с адресом, до которого декодер дошёл по
атомам и ELF; (2) по ETM запись в `ITM_STIM0` выполнилась 496 раз — ровно 31 пачка по 16, а сам
ITM в той же записи пришёл непрерывным счётчиком; (3) листинг читается как исходник: выход из
пустого цикла паузы атомом N на `bne`, счётчик мигания, проверка `seq`, четыре условных перехода
`trace_ok` с атомом N (настройки трассы на месте), опрос готовности FIFO ITM и `str r5, [r7]` в
`0xE0000000`.

## 2026-10-26. Через USB 3.0 (usb3d): ITM + ETM на 50 МГц, запись без предела длины

Тот же STM32F4-Discovery, жгут переподключён. В SLogic — образ `usb3d` (IDDR → FIFO → EP1 IN по USB 3.0);
`trace.py decode` и `show --file` принимают сырой `.bin` из `usb3d.py cap` (`--skip`/`--words` — кусок записи).

Методика: `trace.py stm` задаёт частоту и крутизну, на каждую задержку — `usb3d.py --dly D D D D cap -s 0.05`,
разбор 64 К слов, критерий — непрерывность счётчика ITM.

| TRACECLK | OSPEEDR | Чистые IODELAY (usb3d) |
|---|---|---|
| 6,25 и 12,5 МГц | 3 | все (на 12,5 — кроме 255) |
| 25 МГц | 3 | 0–192 (224 и 255 — смена данных за ~3 нс до фронта) |
| 37,5 МГц | 3 | 0–64 |
| 50 МГц | 3 | **нет** — сбои при любой задержке |
| 50 МГц | 2 | нет (лучше всего 32: 2 разрыва на 6,5 тыс.) |
| 50 МГц | 1 | 0–88, рабочая 40 |

Запись 5 с на 50 МГц (OSPEEDR 1, IODELAY 40): 250,7 МБ = 50,01 МБ/с, потерь 0. Восемь кусков по 1 млн слов по
всей записи: по 103,7 тыс. значений ITM, в четырёх кусках — по одному испорченному значению. ETM (кусок 200 тыс.
слов): 817 828 инструкций, I-sync 59 из 59 совпали с позицией декодера, потерь адреса 0.

**Находка: сбои — от одновременного переключения линий, и это жгут, а не USB 3.0.** Все четыре сбоя —
лишняя единица в одном бите на полубайте, где разом переключаются все четыре линии (`1 → e`, `4 → b`):
`…e1fb` пришло как `…f1fb`, `0b4c` — как `0f4c`. Порядок — одна ошибка на ~2 млн слов. Чтобы отделить
наводки USB 3.0 в ПЛИС от проводки, на том же жгуте загружен старый `tracela` (без USB): на 50 МГц и
OSPEEDR 3 он теперь тоже сбоит при любой задержке (8–40, по 4 записи), хотя 25.10 был чист до 57 МГц —
жгут после переподключения хуже. Значит, приёмник ни при чём, нужен переходник (п. 3 ниже).

Окно задержек у `usb3d` сдвинуто относительно `tracela` (как и у BE-U1000): брать из перебора, а не из
журнала. Разбор `trace.py` чисто на Python — ~4 с на 64 К слов; длинную запись разбирать кусками параллельно.

## 2026-10-27. Переходник на MIPI20: схема rev 0.1

Схема — [`hw/slogic-mipi20`](../hw/slogic-mipi20/README.md): вилка 2×12 прямо в гребёнку прибора, с другого края
MIPI20. Трасса и TDO идут в анализатор через 33 Ом, TCK/TMS/TDI — через 74AUP1G126 от VREF цели, nRESET — через
74LVC1G06 с открытым стоком, на всех линиях MIPI20 стоят TPD4E02B04. Занято 14 каналов из 16: CH12 — TRACECLK,
CH8–CH11 — данные, как на стенде.

**Для статьи: выход логического анализатора — источник на 72 кОм.** Сопротивление от канала до земли 136 кОм,
коэффициент делителя 0,47 — значит, сверху ≈72 кОм с ускоряющим конденсатором, снизу ≈64 кОм. ПЛИС, поставив
канал на выход, выдаёт на разъём полные 3,3 В, но только в КМОП-вход без нагрузки, а фронты проходят через
ускоряющий конденсатор. Решение — тот же приём, что у щупа осциллографа, только наоборот: на входе буфера
Rl ‖ Cl, и при Rl·Cl = R1·C1 фронт плоский. Подтяжки, bus-hold, автоопределение направления (TXS/TXB)
здесь не годятся. Земля нижнего плеча делителя даёт «выключено по умолчанию» бесплатно: OE буферов —
активный высокий, сброс — инвертор с открытым стоком.

Схема собрана скриптом `tools/kisch` из символов библиотек KiCad 10 и проверена `kicad-cli sch erc`
(0 нарушений) и экспортом списка цепей. C1 прибора ещё не измерен: Rl/Cl и предельный TCK — по осциллографу.

## 2026-11-08. Переходник rev 0.2: односторонняя плата

Пользователь будет делать плату дома, в один слой. Изменения: обе вилки угловые 2,54 мм (MIPI20 — с нумерацией
1:1, дальше шлейф или переходники на 1,27 мм), пассив 0805, ESD — USBLC6-4SC6 вместо TPD4E02B04 в USON-10.

**Для статьи: раскладка каналов как задача о плоском графе.** Сигналы идут от гребёнки к MIPI20 полосами; чтобы
не было пересечений, порядок полос на J1 должен совпадать с порядком контактов MIPI20. У угловой двухрядной
вилки дорожка от ряда у края выходит между штырями дальнего ряда — слева или справа, на выбор, и этой свободы
хватает почти на всё. Мешал только такт: на MIPI20 TRACECLK стоит между nRESET и D0…D3, а CH12 на гребёнке
зажат так, что с одной стороны от него помещаются лишь три канала. Второй глобальный тактовый вход — CH8
(N11, GCLKT_3): с ним трасса ложится подряд, `D3 D2 D1 D0 TCLK` = CH14 CH13 CH12 CH10 CH8. Отдельный канал EN
у TCK/TDI давал неизбежное пересечение — OE этих буферов теперь на VREF (TMS по-прежнему в Hi-Z, пока ПЛИС не
включит SWDIO_OE). Чтобы контакт VREF попал в полосу к буферам TCK и TMS, дорожка TMS обходит его со стороны края
платы. Остаётся одна проволочная перемычка — VREF к буферам TDI и nRESET через три полосы. SOT-23-6 пропускает
мимо себя только две полосы (по одной с каждой стороны), поэтому USBLC6-4 стоят по две линии на корпус, шесть
штук. Верх платы — сплошная земля: земляные штыри MIPI20 стоят между сигналами и сшивают слои у разъёма.

Прошивке нужна правка: такт `ch[8]`, данные `{ch[14], ch[13], ch[12], ch[10]}`. ERC — 0 нарушений.

## 2026-11-08. Свой зонд вместо ST-LINK, порт 1 и 2 бита

**Стенд.** Перемычки CN3 сняты, цель настраивает не ST-LINK, а JTAG-зонд на Tang Nano 9K
([jtag-journal.md](jtag-journal.md)): `stm32cfg.py -f sw/rbb/stm32f4-rbb.cfg`. SLogic16U3 прокинут в WSL
через usbipd, захват — `usb3d.py cap -b 65536` (блок 1 МБ на 1 МБ/с не успевает заполниться за секунду;
через usbipd захват обрывается на STALL после нескольких блоков, но пришедшие блоки целые — тестовый
источник `usb3d.py test` без разрывов).

**Звон на 1 МГц.** Первые записи — мусор при любой частоте, от 1 до 50 МГц, и ни одна перестановка линий
не помогала. Сначала была забыта земля; с землёй — то же самое. Признак: фаза полусинхрослов `FF 7F` в
паузах прыгает ровно на полубайт, раз в несколько сотен тактов, то есть лишний фронт TRACECLK. OSPEEDR:

| OSPEEDR | TRACECLK 1 МГц, ITM, 16 Кслов |
|---|---|
| 3 | 2088 значений, 1471 разрыв |
| 1 | сбои (рабочая точка 26.10 на прежней укладке жгута) |
| 0 | 5271 значение, 0 разрывов |

**Для статьи.** Частота тут ни при чём: звенит фронт, а не период. Тот же жгут, уложенный иначе (рядом
провода JTAG к 9K), ломает приём на 1 МГц так же, как на 50.

**Порт 1 и 2 бита.** Приёмник снимает все 4 линии, узкий порт разбирает декодер:
`tpiu_decode.py --width 1|2` берёт младшие линии каждого полубайта. TRACECLK 1 МГц, OSPEEDR 0:

| Ширина | Источник | Результат |
|---|---|---|
| 4 | ITM + ETM | 5104 значения, 0 разрывов |
| 2 | ITM + ETM | 4703 значения, 0 разрывов |
| 1 | ITM + ETM | синхрослов нет: порт занят ETM всё время |
| 1 | ITM | 1429 значений, 0 разрывов |

В 1 бите ETM забивает порт (2 бита за такт) целиком, TPIU не простаивает и не шлёт `FF 7F` — кадры не
найти. Упаковка узкого порта в ПЛИС (в 2–4 раза меньше полосы USB) — следующим шагом, на корректность
она не влияет.

## Что дальше

1. ~~Перекинуть PE5/PE6~~ — сделано, проверено: HSI / 512, режим 1 — 1773 значения подряд без
   перестановки линий.
2. ~~Шаг 2: приём от TRACECLK~~ — сделано: IDDR + IODELAY, чисто до 57 МГц на быстрых фронтах и
   до 66 МГц на средних; дальше упирается в жгут.
3. **Переходник** вместо жгута (схема rev 0.1 — 27.10, `hw/slogic-mipi20`): короткие проводники, земля рядом с каждым сигналом (или витые
   пары сигнал/земля), последовательные резисторы 22–33 Ом у выводов STM32. Цель — 84 МГц на
   OSPEEDR 3 и худшем шаблоне `0x0F`; мерить тем же `sweep2 --n0 0x0f000000`.
4. Разбег линий по IODELAY — заново, когда пропадут ошибки от наводок (сейчас шум их забивает).
5. ~~Поток через USB 3.0~~ — `usb3d`: 50 МГц, ITM + ETM, запись любой длины; остаток — сбои жгута (см. 26.10).
6. ~~Ширина порта 1 и 2 бита~~ — разбор на ПК (`tpiu_decode.py --width`), 08.11; упаковка в ПЛИС — впереди.
