radiolok/rln-trace/doc/slogic-usb-journal.md

# SLogic16U3: журнал своего USB

Продолжение [трассы STM32](slogic-trace-journal.md) и [BE-U1000](beu1000-trace-journal.md): до сих пор
трасса уходила с SLogic16U3 только через JTAG (буфер 8 Кслов, потом чтение). Цель — непрерывный поток на
ПК по USB. Порядок выбран такой: сначала USB2 HS на готовых IP Gowin (около 35–40 МБ/с, канал команд
и отладки), затем USB3 на SerDes. Блоки **«Для статьи»** — повороты и находки для рассказа.

Источники:

- Gowin IPUG781 — USB 2.0 SoftPHY (схема подключения для Arora V, типы выводов): `doc/gowin/IPUG781E-usb2-softphy.pdf`
  (в git не кладётся, скачан с cdn.gowinsemi.com.cn/IPUG781E.pdf);
- [gowinsemi/USB2Peripheral](https://github.com/gowinsemi/USB2Peripheral) — справочный проект Gowin на тех же IP
  (верхний модуль, подключение контроллера к PHY; дескрипторы зашифрованы);
- [usb_serial](https://jorisvr.nl/article/usb-serial) Й. ван Рантвейка (VHDL, 2013) — из него вырос USB 2.0 Device
  Controller Gowin: те же комментарии к портам, тот же интерфейс ПЗУ дескрипторов;
- DS981 (GW5AT): пределы PLL — PFD 19–81,25 МГц, VCO 650–1300 МГц; REFCLK SerDes 20–800 МГц;
- [ciniml/fpga_samples](https://github.com/ciniml/fpga_samples), `eda/slogic16u3_usb2` (К. Ида, BSL-1.0) — USB2 HS
  на этом же SLogic16U3 со своим PHY: какая пара dx, D14 = разрешение генератора, настройка SerDes, от которой
  взят такт (`tools/slogic/usb2/serdes/` — оттуда);
- [sipeed/TangMega-138KPro-example](https://github.com/sipeed/TangMega-138KPro-example), `usb2_soft/usb_cy_streamer` —
  Gowin SoftPHY на Arora V (GW5AST-138): fclk 960 МГц, TX Delay 1, RX Normal;
- [Daisho](https://github.com/enjoy-digital/daisho), `core/usb2` (Marshall H., BSD-2) — открытый USB2 device
  поверх ULPI: пакетный и протокольный уровни взяты в `tools/slogic/usb2/daisho/`;
- USB 2.0, 7.1.7.5 (сброс и согласование HS), UTMI 1.05 — чирп через OpMode 2 и LineState;
- [ciniml/fpga_samples](https://github.com/ciniml/fpga_samples) (К. Ида, BSL-1.0), `rtl/usb3` + `eda/slogic16u3_usb3` —
  свой стек USB 3.0 на Veryl поверх USB 3.0 PHY Gowin, уже поднятый на SLogic16U3: какая линия квада, особенности PHY
  Gowin, бренчмарки EP1 IN. Взят за основу USB3 (коммит ciniml `41354eb`).

## Итог (2026-10-25)

| Что | Состояние |
|---|---|
| Выводы USB2 | Gowin SoftPHY, Single LVDS: dx = K3/K2, терминаторы = P2/P1, подтяжка C14, D14 — разрешение генератора 125 МГц |
| Точный такт | генератор 125 МГц → REFCLK0 SerDes Q0 → линия 0 на 1,25 Гбит/с → tx_pcs_clkout 125 МГц → 2 PLL → 960/60 МГц; +42 ppm к SOF хоста |
| USB2 FS | **работает**: перечисление, bulk IN 1,10 МБ/с без единого разрыва счётчика, bulk OUT |
| USB2 HS | **работает**: 480M, bulk IN **25,45 МБ/с** (WSL через usbipd) 30 с без разрывов, `tx_failed` 0; bulk OUT; любые наполнения пакетов |
| Свой стек USB2 | **работает**: ядро Daisho + свой слой UTMI (`usb2d.v`), чирп по KJ хоста, HS, bulk IN **23,8 МБ/с** 30 с без разрывов, bulk OUT 1 МиБ; без IP Gowin, кроме PHY |
| Команды по USB | **работают**: vendor-запросы EP0 — запись регистров, чтение слов состояния; JTAG — запасной путь и журнал |
| Windows без usbipd | **работает**: BOS + MS OS 2.0 → WinUSB без драйверов и Zadig; bulk IN **46,5 МБ/с** (87 % потолка HS), 30 с без разрывов; через usbipd — 43,7 |
| USB3 SS | **работает** (стек ciniml, своя сборка `tools/slogic/usb3`): U0, bcdUSB 3.10, WinUSB; EP1 IN PRBS15 **463,7 МБ/с** 60 с без ошибок; петля OUT → IN без расхождений; тайминг pclk **закрыт** (125,05 МГц, перебор расстановок) |
| Свой верх USB3 | **работает** `usb3d.v`: регистры по EP0 (vendor 0x03/0x04), журнал заголовков по JTAG, поток трассы IDDR → afifo → sfifo 16 КБ → EP1 IN; тестовый источник: 62,5 МБ/с — 1–2 разрыва в минуту из-за пауз хоста, учёт потерь точный до слова; pclk 125,08 МГц; линт Verilator чистый. Приём от настоящего TRACECLK ещё не проверен |
| Сборка | целиком из командной строки, без GUI Gowin: `tools/slogic/usb2/build.sh` |

## Инструменты

| Папка | Что |
|---|---|
| [`tools/slogic/uprobe`](../tools/slogic/uprobe/) | 22 свободных GPIO: вход / 0 / 1 по JTAG, кто идёт следом, запись смен уровней, частотомер G13 |
| [`tools/slogic/sdprobe`](../tools/slogic/sdprobe/) | SerDes Q0: CSR из toml, детекторы REFCLK, CMU_OK, частоты тактов квада; `sdlib.v` — общий с usb2 |
| [`tools/slogic/usb2`](../tools/slogic/usb2/) | образ USB2 HS: SoftPHY + Device Controller, такт от SerDes (`serdes/` — ciniml, BSL-1.0), ПЗУ дескрипторов (`mkdesc.py`), EP1 IN — счётчик или тестовое наполнение, EP1 OUT; журнал пакетов UTMI в BSRAM |
| [`tools/slogic/usb3`](../tools/slogic/usb3/) | USB3: стек ciniml (`ciniml/`, BSL-1.0, Veryl), IP SerDes / USB 3.0 PHY / арбитр upar — из своей Gowin EDA (`ip/`), `build.sh`, `host/u3status.py` (ER1 и журнал заголовков по JTAG), `host/u3prbs.py` (скорость EP1 IN) |
| `tools/slogic/usb3` — `usb3d.v` | свой верх: `u3stream.v` (afifo → sfifo → EP1 IN, тестовый источник), `afifo.v`, регистры, `host/usb3d.py`; `sim/run.sh` (iverilog), `sim/lint.sh` (Verilator -Wall) |
| `tools/slogic/usb2` — `usb2d.v` | образ на своём стеке: [`daisho/`](../tools/slogic/usb2/daisho/) (BSD-2) + `usb2_utmi.v`; EP1 IN, EP2 OUT; журнал пакетов и событий шины; `usb2d.py`; симуляция `sim/run.sh` |

```sh
export RLN_FPGA_USB=1-2                     # наша FT2232H (JTAG ПЛИС), см. журнал BE-U1000
O=~/.local/opt/oss-cad-suite/bin
sh tools/slogic/usb2/build.sh               # IP → нетлисты, PLL, сборка → usb2.fs
$O/openFPGALoader -c ft2232 --busdev-num 1:$(cat /sys/bus/usb/devices/1-2/devnum) -m tools/slogic/usb2/usb2.fs
python3 tools/slogic/usb2/usb2.py           # состояние, счётчики, dbg контроллера
python3 tools/slogic/usb2/usb2.py log -n 200   # журнал пакетов (SOF не пишется)
"/mnt/c/Program Files/usbipd-win/usbipd.exe" attach --wsl --hardware-id 1209:0001
python3 tools/slogic/usb2/usb2stream.py --sec 5    # скорость и непрерывность EP1 IN
```

Свой стек (Daisho):

```sh
sh tools/slogic/usb2/build.sh d             # IP PHY/PLL из первой сборки → usb2d.fs
sh tools/slogic/usb2/sim/run.sh             # симуляция ядра с моделью UTMI и хоста (и -DFS)
$O/openFPGALoader -c ft2232 --busdev-num 1:$(cat /sys/bus/usb/devices/1-2/devnum) -m tools/slogic/usb2/usb2d.fs
python3 tools/slogic/usb2/usb2d.py --usb    # то же по USB (vendor-запросы EP0), без FT2232H
python3 tools/slogic/usb2/usb2d.py --jtag   # состояние шины, счётчики, ошибки CRC — по JTAG
python3 tools/slogic/usb2/usb2d.py log -n 60   # журнал: сброс, чирп, KJ хоста, пакеты
python3 tools/slogic/usb2/usb2d.py --off 1  # отключиться от шины (--off 0 — подключиться)
```

Поток под Windows, мимо usbipd (`usbipd detach`, если плата в WSL; `libusb-package` — один раз):

```sh
PY="/mnt/c/Program Files/Python310/python.exe"
"$PY" -m pip install --user libusb-package
PYTHONIOENCODING=utf-8 WSLENV=PYTHONIOENCODING "$PY" $(wslpath -w tools/slogic/usb2/usb2stream.py) --sec 30 --chunk 1048576
```

USB3 (нужен `veryl` в PATH — готовый бинарник релиза; кабель — с SS-жилами):

```sh
sh tools/slogic/usb3/build.sh               # IP (один раз), veryl build, 4 расстановки параллельно → лучшая в usb3ref.fs
$O/openFPGALoader -c ft2232 --busdev-num 1:$(cat /sys/bus/usb/devices/1-2/devnum) -m tools/slogic/usb3/usb3ref.fs
python3 tools/slogic/usb3/host/u3status.py  # LTSSM, история состояний, счётчики — по JTAG
"$PY" -m pip install --user libusb1          # один раз
PYTHONIOENCODING=utf-8 WSLENV=PYTHONIOENCODING "$PY" $(wslpath -w tools/slogic/usb3/host/u3prbs.py) -s 30
# … u3prbs.py --loop 500 — петля EP1 OUT → IN (приём DPP хоста) и поток в обе стороны
sh tools/slogic/usb3/build.sh d             # свой верх → usb3d.fs (4 расстановки, лучшая)
sh tools/slogic/usb3/sim/run.sh             # тракт потока в iverilog; sim/lint.sh — линт Verilator
"$PY" $(wslpath -w tools/slogic/usb3/host/usb3d.py)                 # состояние, регистры (+ --dly 4 задержки)
"$PY" $(wslpath -w tools/slogic/usb3/host/usb3d.py) test --rate 8   # тестовый источник 62,5 МБ/с, проверка
"$PY" $(wslpath -w tools/slogic/usb3/host/usb3d.py) cap -o run.bin  # трасса в файл
python3 tools/slogic/usb3/host/u3status.py log                      # журнал заголовков (JTAG)
(cd tools/slogic/usb3/ciniml/rtl/usb3 && PATH=$O:$PATH veryl test)   # тесты ciniml (Verilator), см. шаг 2
```

Привязка `usbipd bind --hardware-id 1209:0001` (администратор) и правило udev для `1209:0001`
уже сделаны. VID:PID — тестовый `1209:0001` pid.codes, только для своих опытов.

Тестовые наполнения EP1 IN — для проверки передачи HS: `usb2.py --pat 1|2|3` (0x00 / 0xFF / 0x7E вместо
счётчика), `--len N` — длина пакета в байтах; `--pat 0 --len 0` — обратно.

## 2026-10-25. Где D+ и D−

Схемы прибора нет, BSDL Gowin не публикует. Зацепка из [прозвонки](slogic-pinmap-journal.md): образ
с подтяжкой всех выводов вверх вызывал на хосте «0000:0002», а пустой — нет. Значит, к D+ идёт вывод ПЛИС.

Образ `uprobe`: 22 свободных GPIO (все, кроме CH0–CH15, JTAG, флеш, RECONFIG_N, DONE, READY, MODE),
каждый по команде ER2 — вход, 0 или 1 (DRIVE=4). По очереди ведём каждый и смотрим, кто идёт следом.

| Цепь | Выводы | Что |
|---|---|---|
| D+ | P2, H3 — напрямую; K3, C14 — каждый через свой резистор | |
| D− | P1, M2 — напрямую; K2 — через резистор | |
| опорное | H2 + M1 | ~0,13 В (1,8 кОм / 75 Ом) |
| — | D14 E14 G14 одиночные; C13 D13 E13 F13 F14 H13 H14 J12 M8 снаружи в 1; G13 — 1,26 МГц | |

Разделили D+ и D− пары LVDS: K3/K2 — пара IOL26 A/B, P2/P1 — IOL35 A/B, A всегда в первой цепи.
Проверка на хосте: C14 = 1 или K2 = 1 → Windows видит подключение; все Z → устройства нет.

Это ровно Single LVDS из IPUG781 (Arora V):

| Порт SoftPHY | Вывод | Тип (IPUG781) |
|---|---|---|
| `usb_dxp_io`/`usb_dxn_io` | P2/P1 (банк 3), 36 Ом — **неверно, см. HS ниже: dx = K3/K2** | LVCMOS33D, DRIVE=8 |
| `usb_rxdp_i` | H3, N = H2 | LVDS25 |
| `usb_rxdn_i` | M2, N = M1 | LVDS25 |
| `usb_term_dp_io`/`dn` | K3/K2 (банк 4), ~100 Ом | LVCMOS33 |
| `usb_pullup_en_o` | C14 (банк 1), 1,5 кОм | LVCMOS33 |

`rxdp`/`rxdn` — LVDS-приёмники «линия против опорного»: их N-выводы и есть общая цепь H2+M1.

**Для статьи: вывод, который перезагружает прибор.** Первый проход перебора оборвался: после «D13 = 0»
пропал образ, регистр состояния Gowin показал DONE и флаг зашифрованного образа — ПЛИС сама загрузила
заводское приложение из флеш. D13, видимо, разведён на RECONFIG_N. Второй проход оборвался на шаге
*после* «D13 = 1»: утилита отпускала вывод в порядке «уровень 0, потом выход выключить», и на долю
микросекунды D13 становился нулём. Теперь порядок: все выводы в Z → уровень → разрешение, а в 0 ведутся
только те выводы, что снаружи и так в 0.

## 2026-10-25. Такт: генератор, которого нет ни на одном выводе

USB HS требует ±500 ppm, OSCB ПЛИС для этого не годится. На всех GPIO нашёлся только такт 1,26 МГц на G13 —
похоже на DC-DC (TMI7003). Пользователь нашёл на плате генератор 125 МГц, выводы уходят во внутренние слои.
Раз его нет на GPIO, он на REFCLK SerDes — 125 МГц × 40 = 5 Гбит/с USB3.

Образ `sdprobe`: квад Q0 из `GowinModGen -type SERDES` (протокол USB3_0_PHY, своя заглушка вместо
протокольной части), CSR — из toml через `serdes_toml_to_csr_15k.exe`, в сборку — `set_csr`. Наружу:
детекторы REFCLK, CMU_OK, такты квада с частотомерами (счёт в своём домене, код Грея).

| Сигнал | Значение |
|---|---|
| CMU1_OK (QPLL1, 5 ГГц от 125 МГц) | **1** — захват |
| REFCLK_DET CM2, CM3 | 1 (CM0, CM1 — 0) |
| CM1_LIFE_CLK, CMU1_CLK, QUAD_CLK_RX | ~61,8 МГц по OSCB. Принял за 62,5 при «OSCB на 1 % быстрее» — **ошибка**: по SOF хоста эти такты на 1,05 % медленнее 62,5, с генератором они не связаны (см. HS ниже) |
| PCS линии 0 | ~31 МГц (линия не в рабочем режиме, не нужна) |

480 МГц из 62,5 одним PLL целочисленно не получить (7,68 = 192/25, PFD ≥ 19 МГц). Два PLLA каскадом:
62,5 × 16 / 25 = 40 МГц, 40 × 24 = 960 МГц → /2 = 480 (fclk SoftPHY), /16 = 60 МГц. На железе 60 МГц
против 62,5 — ровно 60,0000.

**Для статьи: toml без документации.** Утилита toml→csr для 15K — Python, собранный Nuitka; формата нет,
пример есть только для 138K. Ключи восстановлены по `KeyError`: скрипт сам добавлял недостающий ключ в
`[q0]`, потом в линии, потом наверх, и так 30 раз (`mclk_freq = "50M"` — строкой; `rx_seperated_width_mode`
— числом). Итог — [`sdprobe/serdes.toml`](../tools/slogic/sdprobe/serdes.toml).

**Для статьи: IP без GUI.** Генератор софт-IP Gowin живёт только в GUI, но всё, что он делает, —
пишет `*_name.v`/`*_define.v` и синтезирует зашифрованное тело. Шаблоны дефайнов — строками в DLL
(`strings`): типы точек Bulk = 0, Iso = 1, Int = 2; у SoftPHY `TX_DELAY_n_BIT`, `D_LVDS`, `V_120`,
`GW5AT`. Оба IP используют макрос `module_name`, поэтому каждый синтезируется отдельным проектом
(`-disable_io_insertion 1`) в нетлист, а нетлисты подключаются к основному. PLL и SerDes —
`GowinModGen -do x.mod`.

## 2026-10-25. Первое перечисление: читаем USB изнутри

Первый образ: PLL захвачены, HS = 1, хост 4 раза сбрасывал шину, принято 21 SETUP — и «сбой запроса
дескриптора». Чтобы не гадать, в образ встроен журнал пакетов на уровне UTMI: на каждый принятый и
переданный пакет — направление, PID, второй байт, длина, rxerror, метка 60 МГц; 4К пакетов в BSRAM,
чтение через JTAG.

```
← SETUP адрес 0 → DATA0 80 06 …     → ACK       (GET_DESCRIPTOR)
← IN адрес 0                         → NAK, NAK, NAK …
```

**Для статьи: cork, который запирает и нулевую точку.** `txcork` у контроллера Gowin описан как «не
отдавать неполный пакет» для потоковых точек, и я держал его в 1 для всех точек, кроме EP1. Оказалось,
он действует и на EP0 — ответы на стандартные запросы ждали, пока приложение «разрешит». В справочном
проекте Gowin для EP0 cork снят. После исправления:

```
← SETUP → DATA0 80 …  → ACK
← IN    → DATA1 12 01 00 02 … (21 байт: PID + 18 + CRC)  ← ACK
← OUT ZLP → ACK
```

Интерфейс ПЗУ дескрипторов — как у usb_serial: адрес контроллер защёлкивает сам, байт нужен в следующем
такте — ПЗУ комбинационное; `desc_oscfg_addr` указывает на один байт 0x07, им подменяется тип
дескриптора при запросе other_speed_configuration.

## 2026-10-25. FS работает, HS — нет

Без `HSSUPPORT` (нет chirp) устройство перечисляется полностью: Windows — `1209:0001 SLogic16U3 trace`
со строками; в WSL (usbipd, 12M) `usb2stream.py`: 5,57 МБ за 5 с, **1,10 МБ/с** (потолок FS ~1,2),
**0 разрывов** счётчика; EP1 OUT принял 4096 байт; 87040 IN-транзакций, у каждой txpktfin.

С `HSSUPPORT` после сброса идёт chirp (в журнале — передача на 1023 байта), HS = 1, и приём ломается:
каждые 124 мкс (микрокадры SOF) — «пакеты» по 0–1 байта с PID F1–FD, то есть `1111xxxx`. В NRZI
единица — отсутствие перехода: детектор активности (rxdp/rxdn против опорного) срабатывает, а со входа
данных после нескольких бит переходов нет.

| Опыт | Результат |
|---|---|
| RX Normal | обрывки 0–1 байт, PID 1111xxxx |
| RX Advance (`V_120`, рекомендован для Arora V) | всплески rxactive без единого байта |
| TX Delay 1, 2 (× Normal/Advance) | то же |
| терминаторы DRIVE=4 | в HS тишина |
| терминаторы DRIVE=16, dxp/dxn DRIVE=12 | всплески rxactive без байтов |
| терминаторы IP уведены на свободные E14/D14 | хост сбрасывает 229 раз, ни одного SOF |

Заводской DFU Sipeed (по всей видимости, на том же SoftPHY) на этой плате — **480M** (`lsusb -t` через
usbipd). Железо HS держит; ошибка — в моих настройках.

## 2026-10-25. HS работает: три ошибки разом

Ошибок оказалось три, и каждая маскировала следующую. Помогли два чужих проекта: ciniml
(`eda/slogic16u3_usb2`) поднял HS на этом же приборе со своим PHY, а пример Sipeed для Tang Mega 138K Pro —
это Gowin SoftPHY на Arora V.

**1. Пары перепутаны.** dx — это K3/K2, терминаторы — P2/P1 (у ciniml: «в FS работает любое назначение,
в HS — только это»). Мой uprobe отличал «напрямую» от «через резистор», но какая пара передатчик, а какая
терминатор, по этому не скажешь. После перестановки — та же картина: HS-приём даёт PID F8…FD по 0–1 байту.

**2. fclk 960 МГц, а не 480.** IPUG781 пишет «fclk_i — 480 МГц», но у Sipeed на Arora V PHY получает
960 МГц (VCO 960, CLKOUT0 /1, CLKOUT1 /16 = 60), `sclk` PHY выходит 120 МГц. IDES16 на 960 МГц DDR —
4 отсчёта на бит HS; на 480 их было 2, и DRU, рассчитанный на 4, ловил SYNC, а дальше выдавал мусор.
После этого приём HS заработал полностью: SOF 8000/с, SETUP, перечисление в Windows, строки читаются.
Но bulk-пакеты по 512 байт хост не подтверждал (`tx_failed` растёт, IN повторяется).

**3. Такт квада не от генератора.** Сбой передачи зависел от данных (`--pat`/`--len`, 40 попыток на
клетку, после ошибки `clear_halt`):

| Наполнение | 4 | 8 | 16 | 32 | 64 | 128 | 512 байт |
|---|---|---|---|---|---|---|---|
| 0x00 (переход на каждом бите) | 0 | 0 | 0 | 2 | 0 | 4 | 40 |
| 0xFF (вставка бита каждые 6) | 0 | 39 | 40 | 40 | 40 | 40 | 40 |
| 0x7E (шесть единиц в каждом байте) | 0 | 4 | 32 | 40 | 40 | 40 | 40 |

Длинные участки без переходов и длинные пакеты — так ведёт себя приёмник хоста, когда частота передатчика
далеко за допуском. Замер по SOF (журнал UTMI с записью SOF: номера кадров подряд, время по 60 МГц)
показал 59 371 такт на 1 мс хоста вместо 60 000 — **−10 483 ppm**, при допуске HS ±500 ppm. FS (±2500 ppm
по спецификации) и приём HS (DRU подстраивается) это терпели. Источником опоры был `CM1_LIFE_CLK`
квада; `CMU1_CLK` и `QUAD_CLK_RX` дали то же самое. С тактом от линии 0 в режиме Customized PHY
(REFCLK0 → CPLL0, 1,25 Гбит/с, `tx_pcs_clkout` 125 МГц — настройка SerDes ciniml) и цепочкой
125 → 60 (VCO 1200) → 960/60 (VCO 960): **+42 ppm**, все наполнения и длины — 0 сбоев из 40.

| Проверка (WSL, usbipd) | Результат |
|---|---|
| `lsusb -t` | 480M, bulk 512 байт |
| дескрипторы 10–34 байта, 1500 запросов | 0 сбоев |
| EP1 IN, 30 с | 763,6 МБ, **25,45 МБ/с**, 0 разрывов счётчика, `tx_failed` 0 |
| EP1 OUT | 65 536 байт приняты |

25 МБ/с — скорее предел usbipd, а не прибора: каждая IN-транзакция с txpktfin, NAK нет.

Опыты, которые не помогли (ради полноты): TX Delay 0/1/2, RX Normal/Advance, LVPECL33E и DRIVE 4/12 на dx,
сдвиг фазы clk60 на 2/4/6 тактов VCO (hold-нарушения синхронизаторов FIFO PHY ушли, сбои — нет), PHY
из старой Gowin EDA 1.9.10 (нетлист из примера Sipeed). Терминаторы при передаче HS PHY держит в 0
(подсмотрено, выведя наружу сети IOBUF из незашифрованной верхушки нетлиста PHY).

**Для статьи: генератор, которого не было.** В sdprobe всё сходилось: QPLL1 «захвачен», в логике
«62,5 МГц», отношение PLL ровно 60,0000. Единственное расхождение — OSCB показывал 61,8, и я списал его на
неточный внутренний генератор ПЛИС. А неточным был как раз «точный» такт. Отношения двух тактов внутри
ПЛИС ничего не говорят о том, какой из них верный, — нужен внешний эталон, и он был под рукой всё время:
хост шлёт SOF ровно каждые 125 мкс.

**Для статьи: «480 МГц» в документации.** IPUG781 для всех семейств пишет fclk_i 480 МГц. Для Arora V это
не так: PHY там считает отсчёты IDES16 по 4 на бит и ждёт 960. Узнать это можно только из чужого проекта —
пример Sipeed, где PLL прямо называется `fclk_960M`.

## 2026-10-25. Свой стек: Daisho поверх UTMI

Device Controller Gowin — закрытый нетлист с комбинационным ПЗУ дескрипторов и без EP0 для своих
запросов. Замена — USB2-часть Daisho: пакетный уровень (`usb2_packet`), EP0 со стандартными запросами,
двойные буферы bulk по 512 байт. Она написана под внешний PHY с ULPI. SoftPHY Gowin умеет и ULPI, но гонять
ULPI внутри ПЛИС незачем: я заменил `usb2_ulpi.v` своим `usb2_utmi.v` с тем же интерфейсом к пакетному уровню.

Передача. Пакетный уровень рассчитан на ULPI: первый байт — TX_CMD `{4'h4, PID}`, байты уходят по `nxt`,
`stp` — в такте после последнего принятого байта. На UTMI это ложится почти один к одному: фронт `latch` →
PID `{~P, P}` с `txvalid`; `nxt` = `txready`; `txvalid` снимается комбинационно по регистру `stp`,
так что лишнего байта PHY не видит. Приём: `act` = `rxactive`, `latch` = `rxactive & rxvalid`.

Шина. У Daisho согласование HS вслепую: чирп K 2 мс и сразу HS, KJ хоста не проверяется; сброс шины
адрес не обнуляет. Свой автомат: SE0 ≥ 4 мкс в FS → сброс (пакетный и протокольный уровни в сбросе) →
чирп K 2 мс (XcvrSelect HS, TermSelect FS, OpMode 2, данные 00h) → K-J-K-J-K-J хоста по LineState,
каждый ≥ 2,5 мкс → HS. Нет чирпов 1,5 мс → FS. В HS 3 мс без активности → FS, через 100 мкс SE0 —
сброс, J — приостановка, K — выход из неё в прежнюю скорость. Будет ли LineState SoftPHY показывать
чирпы хоста при XcvrSelect = HS, по документации понять нельзя (PHY зашифрован). Поэтому в журнал
пишутся события автомата: смены состояния и LineState вне FS/HS. Оказалось — показывает:

```
    9 +      4.05 мкс  ── CHIRP_K    linestate SE0 opmode 2 xcvr 0 term 1 чирпов 0
   14 +   1999.87 мкс  ── CHIRP_WAIT linestate K   opmode 2 xcvr 0 term 1 чирпов 0
   16 +     25.47 мкс  ── CHIRP_WAIT linestate K   opmode 2 xcvr 0 term 1 чирпов 0
   17 +     48.85 мкс  ── CHIRP_WAIT linestate J   opmode 2 xcvr 0 term 1 чирпов 1
   ...
   21 +     48.88 мкс  ── CHIRP_WAIT linestate J   opmode 2 xcvr 0 term 1 чирпов 5
   22 +      2.55 мкс  ── HS         linestate J   opmode 0 xcvr 0 term 0 чирпов 6
   23 +  85282.63 мкс  ← хост SETUP  адрес 0        3 байт
```

Хост отвечает чирпом через 25 мкс, чирпы по 49 мкс. Перечисление под Windows прошло с первого раза,
без единого повтора; ACK уходит через 0,17 мкс после конца пакета хоста, DATA — через 0,3–0,8 мкс.

До железа — симуляция (`sim/tb_usb2d.v`, iverilog): модель UTMI и хоста с CRC5/CRC16, сброс, чирп, KJ,
GET_DESCRIPTOR, SET_ADDRESS (старый адрес больше не отвечает), строка, GET_STATUS, CLEAR_FEATURE,
SET_CONFIGURATION, 6 IN по EP1 (третий без ACK — повтор того же пакета), PING и OUT по EP2, сброс после
3 мс тишины; HS и FS (байт раз в 40 тактов). Она нашла три ошибки Daisho, которых нет в FPGA с
нулевой инициализацией регистров, и ложный чирп при подключении (SE0 до подъёма линии подтяжкой → OFF
идёт через FSRST, ждать J). В Gowin ядро собралось после переноса объявлений до использования; логика
25 %, BSRAM 55 %; нарушения тайминга — те же, что у сборки с контроллером Gowin (частотомеры, сброс PHY).

| Проверка (WSL, usbipd) | Результат |
|---|---|
| `lsusb -t`, дескрипторы | 480M, 0x81 и 0x02 по 512, строки на месте |
| EP1 IN, 30 с | 713,4 МБ, **23,78 МБ/с**, 0 разрывов счётчика; ошибок CRC (PID, токены, данные) 0 |
| EP2 OUT | 1 МиБ, 2048 пакетов приняты |
| наполнения 0x00 / 0xFF / 0x7E | всё по образцу, кроме первых 1024 байт — два буфера, заполненные до переключения |
| пакеты по 16 байт | 0 разрывов (78 КБ/с: каждый короткий пакет — отдельная передача через usbipd) |
| `usb2d.py --off 1` / `--off 0` | отключение, новый сброс, HS, поток с нуля |

23,8 против 25,4 МБ/с у контроллера Gowin — в пределах разброса прогонов через usbipd (тот же образ
давал 23,8–24,6). Предел по-прежнему, похоже, usbip.

**Для статьи: ядро на чужой PHY.** Пакетный уровень Daisho знает про ULPI ровно три вещи: первый
байт — команда с PID, байты идут по `nxt`, конец — `stp` следующим тактом. Заменить ULPI на UTMI —
это 30 строк, а не новое ядро. Остальной слой ULPI — чирп и сброс — пришлось писать заново, и это оказалась
та часть, где у оригинала были упрощения: HS вслепую, адрес, переживающий сброс шины.

## 2026-10-25. Команды по USB

Управление шло только по JTAG: FT2232H и OpenOCD на каждый запрос, около секунды. Теперь — vendor-запросы
EP0, без стадии данных у записи:

| Запрос | bmRequestType | Что |
|---|---|---|
| `0x10 + n` | `0x40` | регистр n ← `{wIndex, wValue}`; n = 0 — `cmd` (метка 0xA в [31:28], как у JTAG) |
| `0x01` | `0xC0` | слова состояния с `wIndex`, `wLength` ≤ 64 байт (16 слов), младший байт первым |

Для чтения пришлось достроить EP0 Daisho: запрос к хосту теперь отвечает стадией данных IN из внешнего
порта с той же задержкой в такт, что у ПЗУ дескрипторов (`vend_rd_addr`/`vend_rd_data`), и `wIndex`
выведен наружу. Слова 0..23 собраны в один вектор: его читают и ER1, и USB. `cmd` переехал в домен 60 МГц:
JTAG пишет через переключатель, USB — по `vend_req_act`; действует последняя запись, счётчики записей —
слова 21, 22. Журнал пакетов остался только на JTAG: он нужен, когда USB не работает.

| Проверка | Результат |
|---|---|
| симуляция | vendor OUT (wValue/wIndex доходят), vendor IN 64 и 8 байт, GET_DESCRIPTOR после них — снова из ПЗУ |
| `usb2d.py --usb` | кадр двумя запросами (слова 0–15, 16–23) |
| запись по USB → чтение по JTAG и наоборот | значения сходятся, счётчики записей USB/JTAG растут |
| чтение по USB во время потока EP1 IN | раз в секунду, поток **24,77 МБ/с**, 0 разрывов |

`--off 1` по USB отказывается: команда отключила бы сам USB, подключать обратно — только по JTAG.

## 2026-10-25. Windows без usbipd: 46 МБ/с, а предел был в Python

Чтобы мерить мимо usbip, плате нужен драйвер под Windows. Ставить WinUSB через Zadig не стал: `usb2d`
теперь сам его просит. bcdUSB 2.10, `GET_DESCRIPTOR(BOS)` → 40 байт: расширение USB 2.0 (без LPM) и
платформа MS OS 2.0, код вендора `0x20`; vendor IN `0x20`, `wIndex` 7 → 30 байт набора MS OS 2.0
(заголовок + CompatibleID `WINUSB`, без DeviceInterfaceGUID — libusb он не нужен). Оба ответа идут из ПЗУ
дескрипторов (`mkdesc.py daisho`) с явной длиной, как у конфигурации; запрос 0x20 наружу (`vend_req_act`) не
уходит. bcdDevice 0x0101 — чтобы Windows не взяла старый кэш. BOS всё равно понадобится для USB3.

Windows поставила WinUSB сразу после перезаливки: `Service WINUSB, Status OK`. Состояние «Shared» в usbipd 5
драйвер не подменяет, `unbind` (нужен администратор) не понадобился. Python 3.10 на Windows: pyusb уже был,
libusb-1.0 — из `libusb-package`; `usb2stream.py` берёт её сам при `sys.platform == "win32"`.

Первый замер — 27,5 МБ/с при любом размере чанка. Похоже на предел. Но это был сам скрипт: проверка счётчика
шла циклом `struct.iter_unpack`, а 7 млн слов/с в цикле Python съедают ядро процессора. После перехода на
numpy и чтения в заранее выделенный буфер:

| Путь | чанк 64 КБ | чанк 1 МБ |
|---|---|---|
| Windows, WinUSB (libusb, одна передача за раз) | 43,1 МБ/с | **46,3–46,5 МБ/с**; 30 с — 45,8, 1 374 683 136 байт, 0 разрывов |
| WSL через usbipd | 35,5 МБ/с | **43,7 МБ/с**, 0 разрывов |

Непрерывность проверена и между запусками: счётчик прибора вырос ровно на число принятых слов. Потолок HS
bulk — 13 пакетов по 512 байт за микрокадр = 53,2 МБ/с; 46,5 — это 87 %. NAK прибора в этом замере не считал.
Вывод: прежние 24–25 МБ/с через usbipd упирались в Python, а не в usbip и не в
прибор. usbipd отнимает 6 % на больших чанках и около 20 % на малых. Остаток до 53 МБ/с — синхронное
чтение по одной передаче. Асинхронная очередь передач (libusb async, как у sigrok) должна его закрыть.

| Проверка | Результат |
|---|---|
| симуляция | bcdUSB 0210; BOS 40 байт, 2 возможности, код 0x20; MS OS 2.0 30 байт, CompatibleID WINUSB; прежние проверки — без изменений |
| перечисление в Windows | `USB\VID_1209&PID_0001\0001`, класс USBDevice, служба WINUSB |

## 2026-10-25. USB3: эталон ciniml и кабель без SuperSpeed

План был — ядро Daisho `core/usb3` поверх USB 3.0 PHY Gowin. Перед началом нашлось, что у К. Иды (ciniml) в
`fpga_samples` USB 3.0 на этой же плате уже работает: свой стек на Veryl `rtl/usb3` (LTSSM, link, протокол, EP0 и
EP1) и образ `eda/slogic16u3_usb3`. Там же найдено то, чего в Daisho нет: PHY Gowin не выдаёт LFPS в P0
(Polling.LFPS — в P2), вставляет RxValid=0 посреди пакета, сам по себе RxElecIdle в P0 врёт, и ещё пяток ошибок
протокола, найденных по живому xHC. Решили брать это ядро.

| Что | Где |
|---|---|
| SS RX | A2/A1 = Q0 LN0 RXP/RXM |
| SS TX | B3/C3 = Q0 LN0 TXP/TXM |
| Опорный такт | A8/A7 = Q0 REFCLK0, генератор 125 МГц, D14 = OE |
| Ориентация Type-C | переключает мультиплексор VL162 на плате сам |

Методика: сначала эталон «как есть», чтобы отделить железо и сборку от своих правок. Veryl 0.22.0 (готовый
бинарник релиза, `~/.local/bin`) → SystemVerilog; IP SerDes с USB 3.0 PHY и CSR — из их каталога `usb3_ln0`;
сборка — наша Gowin 1.9.12.04 на Windows из WSL через `set_csr` (их `project.tcl` подсовывает csr через
`.gprj.user` — у нас `set_csr` работает и так). ER1 их образа (LTSSM, история состояний, счётчики, 432 бита)
читается нашей FT2232H через OpenOCD одним `drscan` на 448 бит, разбор полей — из их `usb3_status.py`.

| Сборка | pclk, МГц (нужно 125) |
|---|---|
| place 3, route 2 (device_version A или B — одинаково) | 110,7 |
| то же + `serdesRetiming=1` | 122,3 |

**Для статьи: кабель.** Первая заливка: LTSSM ушёл в RxDetect.Active и стоял там 50 с — PHY не отвечал PhyStatus
на обнаружение приёмника. С `serdesRetiming` — то же. Проверка заводской прошивкой (она только USB3, отката на
USB2 нет): после передёргивания питания Windows не видит ничего, ни в одной ориентации Type-C, хотя DFU (USB2) на
том же порту появляется. Кабель оказался только USB2 — без SS-жил. Пользователь тут же узнал, почему с этим
кабелем медленно работала камера. С родным кабелем заводская прошивка — `359f:3031` на 1-23 (SS-порт корневого
хаба Intel; USB2-порты там до 14), эталон ciniml — с первой заливки:

```
PhyWait > RxDetActive > PollLfps > PollRxEq > PollActive > PollConfig > PollIdle > U0
U0 u0=1 link_cfg=1 dev_cfg=1 addr=57 … dppErr=0      → 1209:0001 «USB SS Sample», WinUSB (MS OS 2.0)
```

Вывод на будущее: «PHY не отвечает PhyStatus в RxDetect» у PHY Gowin = на линии нет приёмника хоста; сначала
проверять тракт заводской прошивкой.

Скорость EP1 IN (PRBS15, вендор-запрос 0x02 = 1, каждый байт сверяется), Windows, WinUSB, без usbipd:

| Хост | МБ/с | Ошибок |
|---|---|---|
| pyusb, синхронно, запрос 64 КБ … 4 МБ | 268–291 | 0 |
| python-libusb1, асинхронно, очередь 2–4 × 1–4 МБ | **461–466** | 0 |
| то же, 60 с, 27,8 ГБ | **462,7** | 0; линк всё время в U0 (u0# = 1), dppErr 0 |

У ciniml на Linux асинхронно — 446 МБ/с (bMaxBurst 15); предел линка с SKP — около 482. Под Windows вышло больше.
Против USB2 — в 10 раз; трасса TPIU на 57 МГц (57 МБ/с) проходит с восьмикратным запасом.

## 2026-10-25. USB3, шаг 1: своя сборка, IP — из своей Gowin EDA

Эталон перенесён в `tools/slogic/usb3/`. Исходники ciniml — в `ciniml/` без изменений (BSL-1.0, происхождение —
в `ciniml/README.md`): стек на Veryl, эталонный верх, csr квада. Зашифрованные IP Gowin из их репозитория не
взяты — `build.sh` делает их сам из установленной Gowin EDA, так же как IP в usb2.

| Что | Как |
|---|---|
| обёртка `SerDes_Top` (`serdes.v`) | `GowinModGen -do ip/serdes.mod`, `-type SERDES`, протокол `usb30phy`, Q0 LN0, QPLL0, REFCLK0 125 МГц |
| арбитр upar | синтез `SERDES_IP/data/Upar_Arbiter` в нетлист, верх — `~upar_arbiter_wrap.SerDes_Top`; `define.vh` = `` `define MODULE_NAME SerDes_Top ``, `parameter.vh` = `DRP_NUM = 4` |
| USB 3.0 PHY | синтез `IPlib/USB30PHY/data` в нетлист, верх `USB3_0_PHY_Top`; `usb3_0_phy_name.v` = `` `define module_name USB3_0_PHY_Top ``, `usb3_0_phy_top_define.vh` = `` `define Q0_LN0 `` |
| csr квада | `ciniml/board/serdes.csr` (из GUI) — в сборку через `set_csr` |
| стек | `veryl build` → `.sv` (в git не идут), `-verilog_std sysv2017` |

**Для статьи: ключ, без которого PHY глух.** `serdes.mod` из sdprobe (там протокол был только ради квада) давал
обёртку без арбитра upar: порт DRP у USB 3.0 PHY висел в воздухе. GUI же ставит `GTR12_UPARA` + арбитр. Разница —
один ключ `-USB3_0_PHY_TopEnableDRP true` (нашёлся строкой `EnableDRP true` в `SERDES_IP.dll`). С ним и
`-mod_name SerDes_Top` обёртка совпала с GUI-шной до байта (без учёта CRLF). Шаблоны define-файлов — тоже строками
в DLL: `` `define module_name %1 ``, `` `define Q0_LN0 `` (USB30PHY.dll), `` `define MODULE_NAME %1 ``,
`define.vh`/`parameter.vh` (SERDES_IP.dll); `DRP_NUM` = 4 — по ширине портов обёртки.

Не вышло: csr из toml. `serdes_toml_to_csr_15k.exe` не принимает toml из GUI (`KeyError: 'cpll_to_mipi_enable'`
— у GUI свой набор ключей, как было и с sdprobe). csr — не зашифрованный IP, а данные настройки квада, поэтому
взят готовым из того же BSL-репозитория; toml лежит рядом для справки.

| Проверка | Результат |
|---|---|
| нетлисты IP | те же имена модулей, что у ciniml, размеры ±1 % |
| сборка (place 3, route 2, `serdesRetiming=1`) | pclk **122,293 МГц** — ровно как с IP из GUI ciniml |
| железо | U0 с первой заливки (один сброс хостом — «device firmware changed», как у ciniml) |
| `u3prbs.py`, Windows, очередь 4 × 1 МиБ, 30 с | **460,6 МБ/с**, 13,8 ГБ, 0 ошибочных байт |

## 2026-10-25. USB3, шаг 2: pclk 125 МГц — правка RTL и перебор расстановок

Методика: худшие пути из отчёта PnR (`*.tr`), сгруппированные по паре «откуда → куда», и **по нескольким
расстановкам сразу**. У PnR Gowin нет зерна, а на кристалле, занятом на 81 % CLS, результат от малой правки
прыгает на ±10 МГц: по одной сборке не отличить улучшение от удачи. Мера — распределение pclk по
`place_option` 1…4 (`route_option 2`, `serdesRetiming 1`), четыре сборки параллельно, ~3 мин.

| RTL | place 1 | 2 | 3 | 4 | среднее | худшее |
|---|---|---|---|---|---|---|
| ciniml как есть | 113,2 | 101,9 | 122,3 | 125,2 | 115,6 | 101,9 |
| + LTSSM: флаги `pb_full`/`tar_full`, `tseq_cnt` по `st_chg` | — | — | 116,2 | 119,7 | | |
| + CRC-32 в разборщике в две стадии | 116,4 | 121,3 | 118,4 | 119,9 | 119,0 | 116,4 |
| + счётчики LTSSM без обнуления из next-state | **125,0** | **125,05** | 123,1 | 120,3 | 123,4 | 120,3 |

Перебор опций без правки RTL не помог: `retiming=1` (ретайминг синтеза) — тот же результат до сотых,
`replicate_resources=1` — 120,3, `resource_sharing=0 max_fanout=32` — 114,8. Зерна расстановки в gw_sh нет
(искал в бинарниках).

Что правил (в `ciniml/`, помечено `rln:`):

1. **Обнуление счётчиков из next-state.** LTSSM ciniml обнуляет счётчики «действиями при входе» — по `ns`,
   а `ns` — вся логика переходов. Худший путь: `state` → 5-битное сравнение `pb_sent == POLL_LFPS_SENT`
   (цепочка переноса) → выход из Polling.LFPS → сброс 17-битного `tseq_cnt` (26 приёмников), 11 уровней.
   Лечение по месту: сравнения с порогом — флагами, которые ставятся при инкременте до порога (точно в тот же
   такт, что и сравнение); `tseq_cnt`/`skp_cnt`/`idle_sent` — обнулять в первом такте нового состояния по
   `st_chg` (у ciniml это уже регистр — им маскируются таймауты); `pb_sent`/`tx_after_rx` — держать в нуле
   вне Polling.LFPS, как ciniml держит `pb_us` в 15. Каждый перенос проверен на «первый такт»: в нём счётчик не
   растёт (`ts_word` начинается с 0), а все проверки `idle_sent` идут в паре с `idle_rx`, который вход обнуляет.
2. **CRC-32 приёма DPP за один такт.** `pos` → мультиплексор окна → CRC-32 от 4 байт → `crc32`, ~14 уровней.
   Теперь DPP-состояния только регистрируют слово и число байт, `crc32` считается тактом позже; вердикт DPP
   (`o_dpp_end`/`o_dpp_err`) — ещё тактом позже, когда хвост уже в `crc32` (сравнение принятого CRC тоже из
   регистра). Следующий пакет даёт свой выход не раньше чем через 2 такта, поэтому порядок событий не меняется.

Осталось и не тронуто: `out_len → in_ram` (петля EP1 OUT → IN эталонного верха — в своём верхе её не будет),
«цикл решения» разборщика `pos → pos` (сделан ciniml нарочно узким), разрозненные `det_fail`, `tx_mux_data`.

`build.sh` теперь сам собирает четыре расстановки и кладёт в `usb3ref.fs` лучшую, с вердиктом «закрыт / НЕ
закрыт». Результаты детерминированы: повторная сборка дала те же частоты до тысячных.

**Для статьи: тесты, которые не на чем прогнать.** У ciniml к стеку есть тесты (`veryl test`, Verilator с
моделью хоста). Verilator из OSS CAD Suite (5.053) их не компилирует (task из function, неявный static, `#0`), а
с ослабленными предупреждениями `usb3_prim` проходит, а `usb3_link`/`frame`/`device` падают на нетронутом RTL —
линк в модели не поднимается (переделка задач модели в функции не помогла). Видимо, модель опиралась на поведение
старого Verilator. Поэтому регрессия правок — на железе, и база снята на исходном RTL:

| Проверка | ciniml как есть | после правок (p2, 125,05 МГц) |
|---|---|---|
| тайминг (все домены, setup/hold) | pclk −4,4 нс TNS | 0 / 0 |
| `u3prbs.py --loop`: EP1 OUT → IN, посылки 8…3072 байт (приём DPP хоста через новый CRC) | 200 / 0 расхождений | 500 / 0 |
| поток в обе стороны | 45,2 МБ/с | 45,4 МБ/с, 0 расхождений |
| EP1 IN PRBS15, 60 с | 462,7 МБ/с | **463,7 МБ/с**, 0 ошибок |
| перезаливка × 3 | — | U0 и перечисление 3/3 |
| после прогонов | — | U0 = 1 вход, ошибок DPP 0, 8b10b 0 |

## 2026-10-25. USB3, шаг 3: свой верх usb3d — регистры, журнал, поток трассы

`usb3d.v` собран на каркасе эталона (PHY, сбросы, `Usb3Top`/`Usb3Device`, ER1 в той же раскладке — `u3status.py`
работает с обоими образами). Что своё:

| Часть | Как |
|---|---|
| регистры | готовый порт `Usb3Device`: vendor OUT 0x03 (wIndex — адрес, wValue — 16 бит), IN 0x04 — 32 бита; карта — шапка `usb3d.v` («RLU3», пуск/источник, IODELAY, частотомер TRACECLK, счётчики слов и потерь, заполнение FIFO, LTSSM) |
| приём трассы | как режим 2 tracela: TRACECLK с N9 на глобальную сеть, TRACED0..3 (CH8..11) → IODELAY (своя задержка у линии) → IDDR; байт = {спад, фронт}, 4 байта — слово; выравнивание слова по пуску |
| поток | `u3stream.v`: afifo 512 слов (код Грея, TRACECLK → pclk) → sfifo 4096 слов (16 КБ, pclk) → очередь на 2 слова за BSRAM → 32-битный вход EP1 IN, слово каждый такт без пузырей; трасса теряет слова только на afifo (счётчик в домене TRACECLK → код Грея), sfifo к afifo — с подпором |
| тестовый источник | счётчик в pclk, слово раз в `RATE` тактов, пишет прямо в sfifo; при полном слово теряется, счётчик идёт дальше — разрывы у хоста равны счётчику потерь |
| PRBS | vendor 0x02 = 1, как у эталона — `u3prbs.py` работает и с usb3d |
| журнал по JTAG | журнал заголовков эталона (128 записей, ER2, кольцевой режим EP1 IN до события); запись PIPE-слов (1024 × 76) убрана — ~5 BSRAM и место в CLS; петля EP1 OUT → IN убрана (с ней ушёл и путь `out_len → in_ram`) |

Ресурсы: логика 67 %, CLS 85 %, BSRAM 28/35. Тайминг: p2 125,077, p1 125,063, p3 125,011, p4 113,6 МГц — три
расстановки из четырёх закрыты.

Методика проверки — снизу вверх:

1. **Симуляция тракта** (`sim/run.sh`, iverilog): трасса 62,5 МГц при ready 50 % — без потерь; потребитель стоит
   600 мкс — 4768 потерь, ровно столько же пропало по разрывам; тестовый источник rate 1 при ready 100 % — 0 пузырей;
   при ready 30 % — 37 736 = 37 736. Сначала стенд «нашёл» расхождение на 2 слова — это хвост: слова, потерянные
   после последнего принятого, разрывом не видны, и ещё одно слово в пути в такт остановки; учёт в стенде поправлен.
2. **Линт Verilator** (`sim/lint.sh`, `-Wall`): свой код чистый; отключено одно `PROCASSINIT` — начальные значения
   регистров в объявлении для ПЛИС нарочные. Стек ciniml (`Usb3Top`, `Usb3Device`, с моими правками) — чистый с
   его же отключениями из `Veryl.toml` плюс `PINCONNECTEMPTY` (так Veryl выводит неподключённый выход `o_lfsr: _`).
   Исправлено по линту: имя модуля = имя файла (`usb3d`, `u3stream`, `afifo` — по своим файлам), неиспользуемые
   выходы — именованными проводами в явную свёртку `_unused`.
3. **Железо** (Windows, WinUSB, `usb3d.py test`):

| Источник | Очередь хоста | МБ/с | Разрывы | Учёт |
|---|---|---|---|---|
| rate 8 (62,5 МБ/с, как трасса 62,5 МГц), 60 с × 2 | 32 × 64 КБ | 62,5 | 2 и 2 | сходится до слова |
| rate 2 (250 МБ/с), 10 с | 4 × 1 МБ / 16 × 256 КБ / 32 × 64 КБ / 8 × 4 МБ | 250 | 500 / 65 / 14 / 247 | сходится |
| rate 1 (500 МБ/с — больше линка), 20 с | 4 × 1 МБ | 447 | 8,7 млн | сходится (2,2 млрд слов, назад — ни одного) |
| PRBS (`u3prbs.py`) | 4 × 1 МБ | 461–464 | 0 ошибок | — |

**Для статьи: потери — на хосте.** Устройство не теряет ничего, пока FIFO не полон, а полон он становится, когда
хост молчит дольше, чем покрывает буфер: 16 КБ sfifo + 16 КБ буферов EP1 IN `Usb3Device` — 128 мкс на 250 МБ/с,
0,5 мс на 62,5 МБ/с. Число разрывов зависит от очереди на хосте в 35 раз (500 → 14 при той же скорости), т. е.
паузы рождаются на стыках передач. libusb в Windows ходит через WinUSB без политики `RAW_IO` — запросы на канал
уходят по одному; в libusb 1.0.29 (её везёт `python-libusb1`) включить `RAW_IO` нельзя. Лечение — на хосте
(WinUSB напрямую с `RAW_IO`, или Linux), запас в BSRAM на устройстве — 7 блоков.

Разовое: в первом прогоне после первой заливки usb3d линк 9 раз прошёл через Recovery (73 ошибки 8b10b), и одна
передача кончилась статусом STALL. Повторить не удалось: две перезаливки и прогоны на всех скоростях — 1 вход в U0,
0 ошибок. Для следующего раза есть журнал заголовков (`u3status.py rearm 3` — кольцо EP1 IN до события).

Чтение ER2 по JTAG: длина скана — ровно 192 бита (проверено записью номера и чтением его в следующем снимке; скан
возвращает снимок до своей записи, поэтому журнал — 129 сканов в одном запуске OpenOCD).

Не проверено: приём от настоящего TRACECLK (IDDR → afifo). Стенд BE-U1000 (CH8..12) сейчас не подключён; лучше
всего — узор калибровки PIB (`5A 5A F0 0F`) на 25–50 МГц.

## 2026-10-25. Без программатора: usb3d.bin для DFU

Для работы FT2232H не нужен: регистры и состояние идут по USB, а образ можно писать во флеш через заводской
загрузчик DFU (`slogic_dfu.py write`). Чтобы после записи кнопка MODE возвращала в DFU, `build.sh` задаёт multiboot,
как у образа `probe`: `-multi_boot 1 -multiboot_spi_flash_address 800000 -multiboot_address_width 24`, и выдаёт
`usb3d.bin` рядом с `usb3d.fs`. Проверка заголовка: команда `0xD2` по смещению `0x48` — `d2 00 ff ff 00 80 00 00`,
адрес `0x800000` (то же место правит `mkdfu.py` ciniml). Разводка от опций не зависит — pclk тот же, 125,077 МГц.
Запись во флеш на приборе проверена 26.10 (ниже). Корневой README переписан под вариант на SLogic16U3 (схема —
`doc/img/slogic-trace.svg`).

## 2026-10-26. usb3d от настоящего TRACECLK: BE-U1000, 50 МБ/с без потерь

Первый живой источник: N-Trace BE-U1000 на 50 МГц (подробно — [журнал BE-U1000](beu1000-trace-journal.md)).
Частотомер `usb3d` — 50,000 МГц; окно IODELAY у этого образа 168–255 (рабочая 208); трасса разбирается без единой
ошибки, запись 20 с = 1,0 ГБ, потерь 0, sfifo не набирает больше слова.

Правка хоста: `usb3d.py` (`cap` и `test`) включает источник после постановки асинхронных чтений и выключает его до
их снятия, дочитывая остаток FIFO. Раньше на стыках терялось ~50 тыс. слов (FIFO 16 КБ при 50 МБ/с полон за
330 мкс) — счётчик это честно показывал, но запись начиналась и кончалась обрывом.

## 2026-10-26. usb3d во флеш через DFU — без JTAG и без usbipd

Полный цикл на приборе, FT2232H не участвует:

1. MODE → DFU (359f:30f1). Под Windows у загрузчика уже стоит WinUSB (веб-прошивальщик Sipeed ходит через
   WebUSB), поэтому `slogic_dfu.py` запускается Python Windows: pyusb + бэкенд `libusb_package`. Пришлось убрать
   `is_kernel_driver_active` на win32 — там это «не поддерживается». usbipd (и `bind` от администратора) не нужен.
2. `slogic_dfu.py write usb3d.bin --backup slogic16u3-factory.bin`: сверка золотого образа с дампом прибора,
   стирание 128 секторов по 4 КиБ, запись 596 001 байт (~15 КиБ/с), чтение и сверка — 47 с.
3. Передёрнуть USB: ПЛИС грузит образ с 0x0 → 1209:0001, U0, частотомер, тест 433 МБ/с со сходящимся
   учётом потерь, трасса STM32 50 МБ/с без потерь, ITM непрерывен.
4. MODE → снова 359f:30f1: multiboot на 0x800000 в заголовке образа работает.

Строки дескрипторов USB3 приведены к образу USB2: в ПЗУ ciniml оставались `fpga_samples` / `USB SS Sample` /
`000001`, и Windows показывала прибор как «USB SS Sample». Правка — в `gen_descriptor_rom.py` (`rln:`), ПЗУ
перегенерировано: `rln-trace` / `SLogic16U3 trace` / `0001`, VID:PID прежний 1209:0001. С тем же серийным номером
Windows и usbipd узнают прибор как прежний «SLogic16U3 trace» (usbipd — сразу Shared). Сборка: p4 125,011 МГц
(p2 123,8, p3 123,5, p1 110,1 — разброс расстановок прежний), записано через DFU, проверено: U0, тест 439 МБ/с
сходится, трасса STM32 без потерь.

## 2026-10-26. Публичный репозиторий slogic16u3-trace, релиз v0.1

Проект «отладка + трасса на SLogic16U3» вынесен в отдельный англоязычный репозиторий
[slogic16u3-trace](https://github.com/radiolok/slogic16u3-trace) (подмодуль `au/slogic16u3-trace/`), rln-trace
остаётся исследовательским. Раскладка: `rtl/` (usb3d, `stream.v` — бывший `u3stream.v`), `rtl/tpiu/tpiu_rx.v` —
приёмник трассы (IODELAY → IDDR → слова), вынесен из `usb3d.v` отдельным модулем для стенда B, `rtl/usb/` — стек
ciniml и входы генератора IP; `tools/` — DFU, `usb3d.py`, декодеры `tpiu_decode.py` / `ntrace_decode.py` (только
разбор записей, без кода tracela), прошивки-источники целей; `boards/` — платы. Комментарии переведены.

Проверки:
- декодеры сверены со старыми на записях `runs/`: N-Trace — 6 записей, все числа совпали; TPIU/ETM — те же
  19 641 инструкция построчно; прошивки целей дают тот же машинный код;
- новый тестбенч `tb_tpiu.v` (поведенческие IODELAY/IDDR): синтетический TPIU → `tpiu_rx` → декодер, 160 значений
  ITM без разрывов. Нашёл ошибку в самом стенде: простой перед потоком должен быть `FF 7F`, а не `FF`;
- CI на GitHub: OSS CAD Suite 2026-10-20 (как локально), Veryl 0.22, линт -Wall, оба тестбенча, тесты декодеров;
- сборка из нового репо: p2 125,055 МГц. В SRAM на приборе: PRBS 463 МБ/с без ошибок, тест-источник 446 МБ/с
  сходится, трасса STM32 50 МГц — 50,00 МБ/с без потерь. Одиночные сбои бита ITM (жгут) — с той же частотой и
  на прежнем образе. Во флеш через DFU релизный `.bin` не писался (нужна кнопка MODE).

## Открытые вопросы и что дальше

1. ~~Скорость HS без usbipd~~ — 46,5 МБ/с под Windows (WinUSB), 43,7 через usbipd; предел был в Python.
   Остаток до 53 МБ/с — очередь асинхронных передач на хосте.
2. Поток трассы — следующий шаг: приём режима 2 tracela (IDDR + IODELAY от TRACECLK) в `usb2d.v`,
   асинхронный FIFO TRACECLK → 60 МГц на BSRAM перед EP1 IN, флаг переполнения, отбрасывание простоя TPIU;
   настройка (пуск, IODELAY) — регистрами по vendor-запросам. TPIU 4 бита DDR = байт на такт TRACECLK:
   при 57 МГц это 57 МБ/с против ~46 по USB2 — без отбрасывания простоя только до ~40 МГц.
3. ~~Команды по EP0 (vendor) вместо JTAG~~ — сделаны.
4. ~~Переход на USB2-ядро Daisho~~ — сделан (`usb2d.v`); ~~команды по USB~~ — сделаны (vendor-запросы EP0).
5. USB3 — эталон ciniml работает (462 МБ/с). Дальше по шагам: ~~(1) перенос в `tools/slogic/usb3/` со своей сборкой и
   своим IP PHY из `GowinModGen`~~ — сделан; ~~(2) закрыть тайминг pclk 125 МГц~~ — закрыт (правка RTL + перебор расстановок); (3) свой верх `usb3d.v` — регистры по EP0,
   журнал по JTAG, поток трассы через FIFO в EP1 IN — сделан (`usb3d.v`), кроме проверки от
   настоящего TRACECLK.
6. Трасса по USB3 от живого источника: ~~BE-U1000 (N-Trace, 50 МГц)~~ — без потерь и ошибок; ~~STM32 TPIU~~ —
   50 МГц, ITM + ETM разбираются, редкие сбои от жгута (журнал трассы STM32, 26.10).
7. Хост без пауз: захват через WinUSB напрямую с `RAW_IO` (C, Visual Studio есть) или под Linux; на устройстве —
   sfifo больше (свободно 7 BSRAM) и, по желанию, отбрасывание простоя TPIU.
