radiolok/rln-trace/hw/slogic-mipi20/slogic-mipi20.kicad_sch

## KiCad design hw/slogic-mipi20/slogic-mipi20.kicad_sch (2026-11-08)

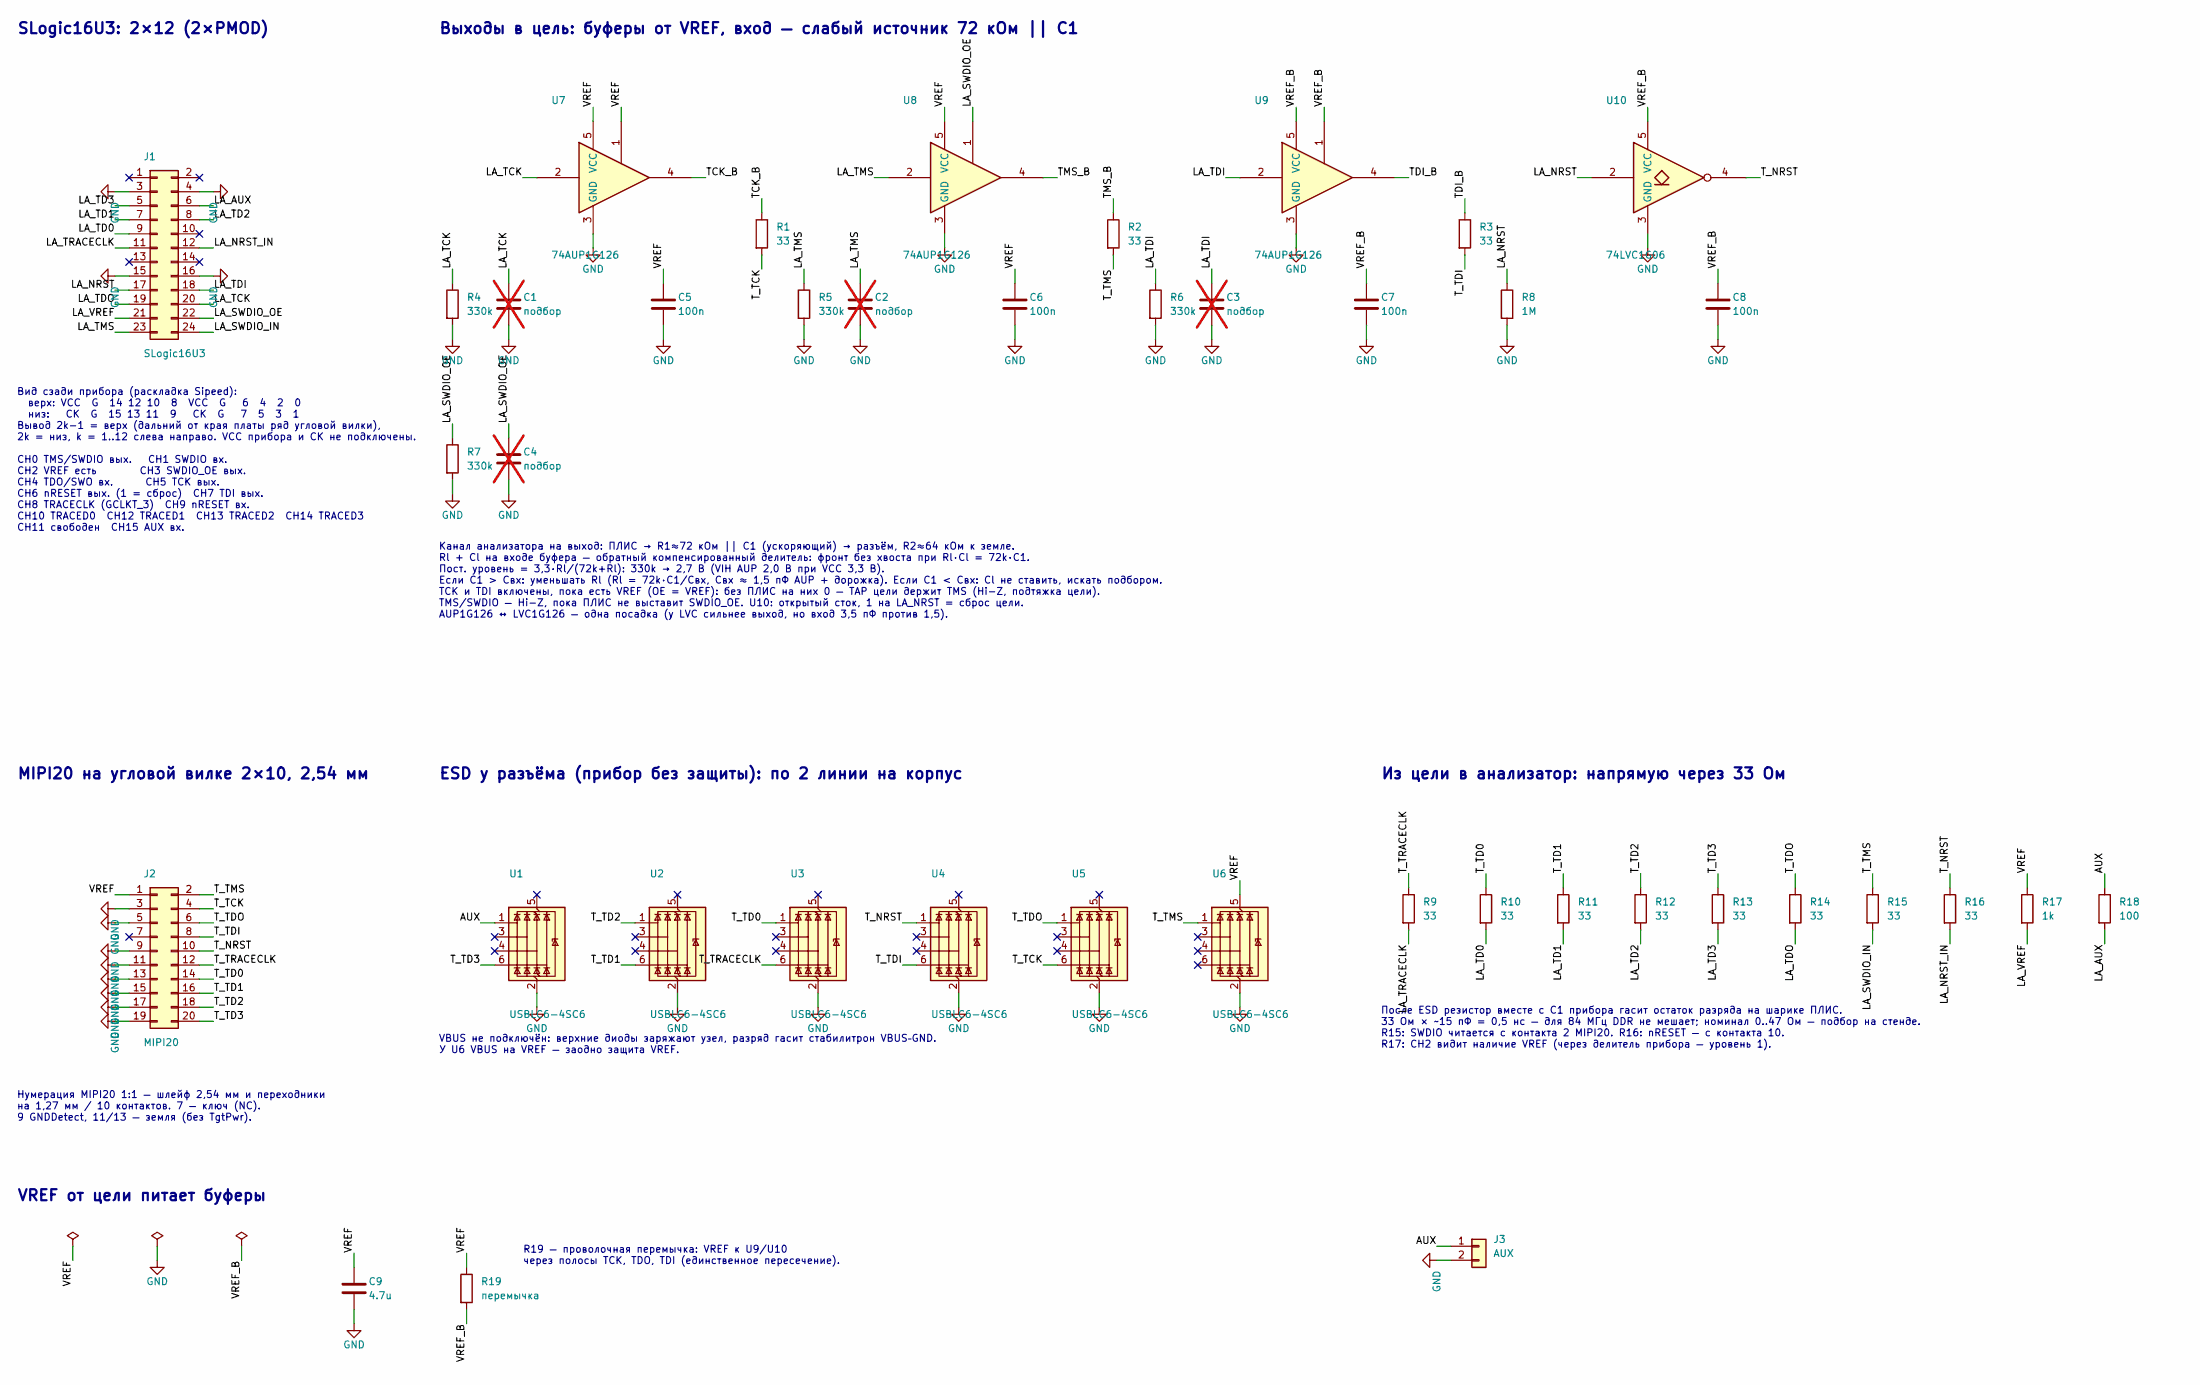
[picture p2: schematic slogic-mipi20.kicad_sch]

Parts:
C1, C2, C3, C4: подбор; C_0805_2012Metric_Pad1.18x1.45mm_HandSolder; not fitted
C5, C6, C7, C8: 100n; C_0805_2012Metric_Pad1.18x1.45mm_HandSolder
C9: 4.7u; C_0805_2012Metric_Pad1.18x1.45mm_HandSolder
J1: SLogic16U3; PinHeader_2x12_P2.54mm_Horizontal
J2: MIPI20; PinHeader_2x10_P2.54mm_Horizontal
J3: AUX; PinHeader_1x02_P2.54mm_Vertical
R1, R2, R3, R9, R10, R11, R12, R13, R14, R15, R16: 33; R_0805_2012Metric_Pad1.20x1.40mm_HandSolder
R4, R5, R6, R7: 330k; R_0805_2012Metric_Pad1.20x1.40mm_HandSolder
R8: 1M; R_0805_2012Metric_Pad1.20x1.40mm_HandSolder
R17: 1k; R_0805_2012Metric_Pad1.20x1.40mm_HandSolder
R18: 100; R_0805_2012Metric_Pad1.20x1.40mm_HandSolder
R19: перемычка; R_Axial_DIN0207_L6.3mm_D2.5mm_P10.16mm_Horizontal
U1, U2, U3, U4, U5, U6: USBLC6-4SC6; SOT-23-6; MPN USBLC6-4SC6
U7, U8, U9: 74AUP1G126; SOT-23-5; MPN SN74AUP1G126DBVR
U10: 74LVC1G06; SOT-23-5; MPN SN74LVC1G06DBVR

Connections:
AUX: J3.1, R18.1, U1.1 (I/O1)
GND: C1.2, C2.2, C3.2, C4.2, C5.2, C6.2, C7.2, C8.2, C9.2, J1.3, J1.4, J1.15, J1.16, J2.3, J2.5, J2.9, J2.11, J2.13, J2.15, J2.17, J2.19, J3.2, R4.2, R5.2, R6.2, R7.2, R8.2, U1.2 (GND), U2.2 (GND), U3.2 (GND), U4.2 (GND), U5.2 (GND), U6.2 (GND), U7.3 (GND), U8.3 (GND), U9.3 (GND), U10.3 (GND)
LA_AUX: J1.6, R18.2
LA_NRST: J1.17, R8.1, U10.2
LA_NRST_IN: J1.12, R16.2
LA_SWDIO_IN: J1.24, R15.2
LA_SWDIO_OE: C4.1, J1.22, R7.1, U8.1
LA_TCK: C1.1, J1.20, R4.1, U7.2
LA_TD0: J1.9, R10.2
LA_TD1: J1.7, R11.2
LA_TD2: J1.8, R12.2
LA_TD3: J1.5, R13.2
LA_TDI: C3.1, J1.18, R6.1, U9.2
LA_TDO: J1.19, R14.2
LA_TMS: C2.1, J1.23, R5.1, U8.2
LA_TRACECLK: J1.11, R9.2
LA_VREF: J1.21, R17.2
TCK_B: R1.1, U7.4
TDI_B: R3.1, U9.4
TMS_B: R2.1, U8.4
T_NRST: J2.10, R16.1, U4.1 (I/O1), U10.4
T_TCK: J2.4, R1.2, U5.6 (I/O4)
T_TD0: J2.14, R10.1, U3.1 (I/O1)
T_TD1: J2.16, R11.1, U2.6 (I/O4)
T_TD2: J2.18, R12.1, U2.1 (I/O1)
T_TD3: J2.20, R13.1, U1.6 (I/O4)
T_TDI: J2.8, R3.2, U4.6 (I/O4)
T_TDO: J2.6, R14.1, U5.1 (I/O1)
T_TMS: J2.2, R2.2, R15.1, U6.1 (I/O1)
T_TRACECLK: J2.12, R9.1, U3.6 (I/O4)
VREF: C5.1, C6.1, C9.1, J2.1, R17.1, R19.1, U6.5 (VBUS), U7.1, U7.5 (VCC), U8.5 (VCC)
VREF_B: C7.1, C8.1, R19.2, U9.1, U9.5 (VCC), U10.5 (VCC)

Notes on the sheet:
SLogic16U3: 2×12 (2×PMOD)
Вид сзади прибора (раскладка Sipeed): верх: VCC G 14 12 10 8 VCC G 6 4 2 0 низ: CK G 15 13 11 9 CK G 7 5 3 1 Вывод 2k-1 = верх (дальний от края платы ряд угловой вилки), 2k = низ, k = 1..12 слева направо. VCC прибора и CK не подключены. CH0 TMS/SWDIO вых. CH1 SWDIO вх. CH2 VREF есть CH3 SWDIO_OE вы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
Выходы в цель: буферы от VREF, вход — слабый источник 72 кОм || C1
Канал анализатора на выход: ПЛИС → R1≈72 кОм || C1 (ускоряющий) → разъём, R2≈64 кОм к земле. Rl + Cl на входе буфера — обратный компенсированный делитель: фронт без хвоста при Rl·Cl = 72k·C1. Пост. уровень = 3,3·Rl/(72k+Rl): 330k → 2,7 В (VIH AUP 2,0 В при VCC 3,3 В). Если C1 > Cвх: уменьшать Rl (R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
MIPI20 на угловой вилке 2×10, 2,54 мм
Нумерация MIPI20 1:1 — шлейф 2,54 мм и переходники на 1,27 мм / 10 контактов. 7 — ключ (NC). 9 GNDDetect, 11/13 — земля (без TgtPwr).
ESD у разъёма (прибор без защиты): по 2 линии на корпус
VBUS не подключён: верхние диоды заряжают узел, разряд гасит стабилитрон VBUS–GND. У U6 VBUS на VREF — заодно защита VREF.
Из цели в анализатор: напрямую через 33 Ом
После ESD резистор вместе с C1 прибора гасит остаток разряда на шарике ПЛИС. 33 Ом × ~15 пФ = 0,5 нс — для 84 МГц DDR не мешает; номинал 0..47 Ом — подбор на стенде. R15: SWDIO читается с контакта 2 MIPI20. R16: nRESET — с контакта 10. R17: CH2 видит наличие VREF (через делитель прибора — уровень 1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
VREF от цели питает буферы
R19 — проволочная перемычка: VREF к U9/U10 через полосы TCK, TDO, TDI (единственное пересечение).
