radiolok/rln-trace/hw/probe-b/kicad/fpga.kicad_sch

## KiCad design hw/probe-b/kicad/fpga.kicad_sch (2026-10-04)

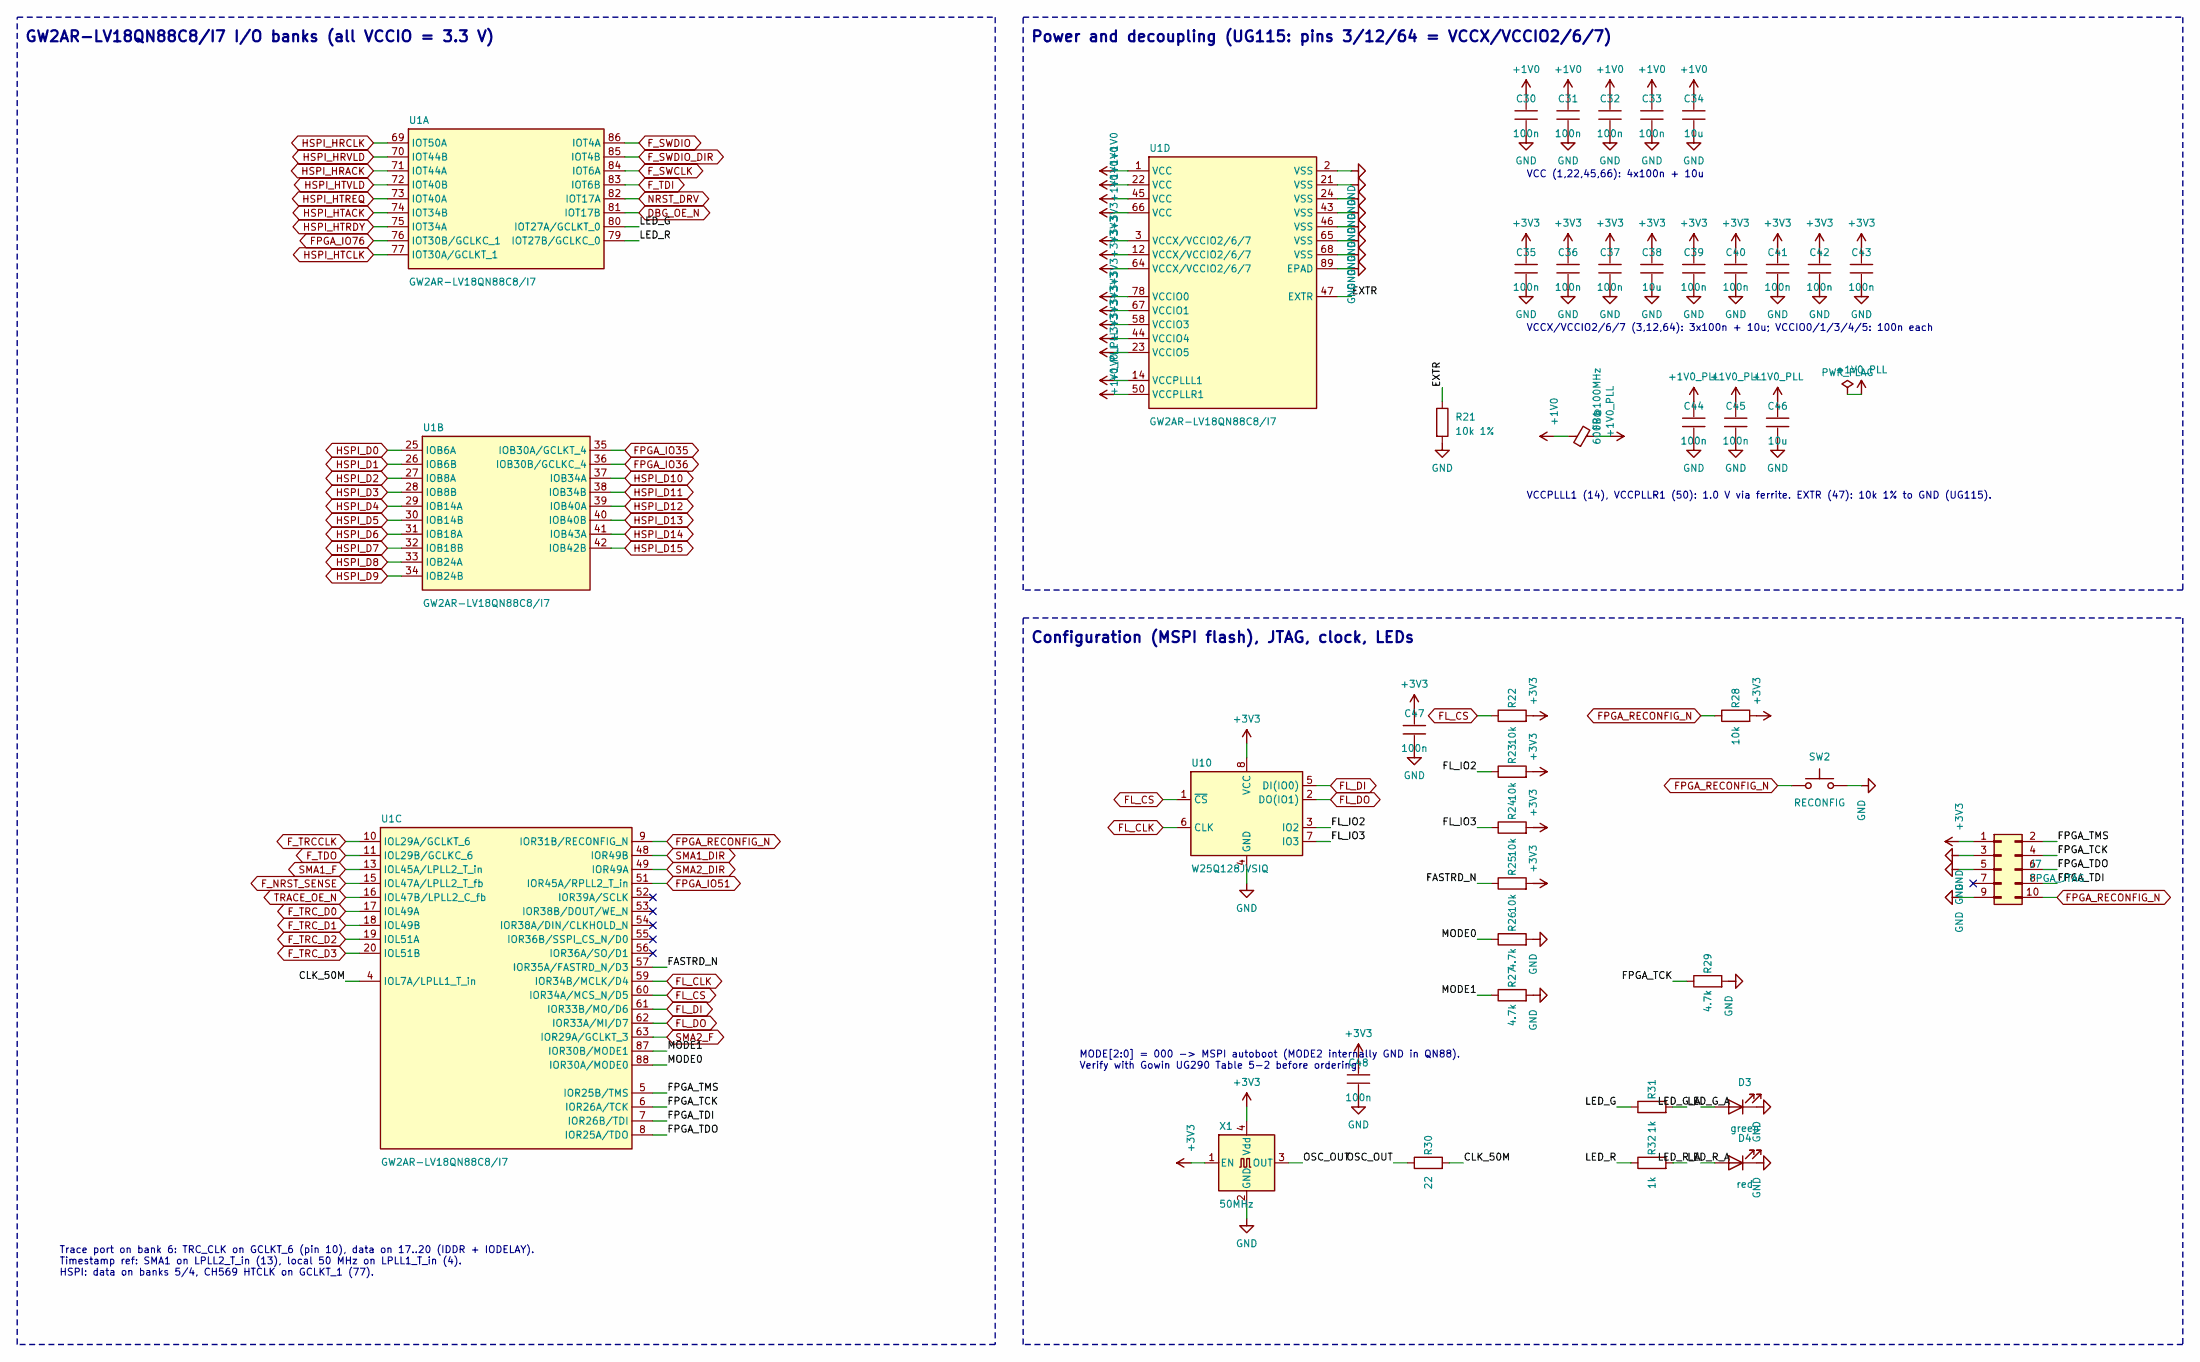
[picture p3: schematic fpga.kicad_sch]

Parts:
C30, C31, C32, C33, C35, C36, C37, C39, C40, C41, C42, C43, C44, C45, C47, C48: 100n; C_0402_1005Metric
C34, C38, C46: 10u; C_0805_2012Metric
D3: green; LED_0603_1608Metric
D4: red; LED_0603_1608Metric
FB1: 600R@100MHz; L_0603_1608Metric
J7: FPGA_JTAG; PinHeader_2x05_P1.27mm_Vertical_SMD
R21: 10k 1%; R_0402_1005Metric
R22, R23, R24, R25, R28: 10k; R_0402_1005Metric
R26, R27, R29: 4.7k; R_0402_1005Metric
R30: 22; R_0402_1005Metric
R31, R32: 1k; R_0402_1005Metric
SW2: RECONFIG; SW_SPST_PTS810
U1: GW2AR-LV18QN88C8/I7; QFN-88-1EP_10x10mm_P0.4mm_EP6.74x6.74mm
U10: W25Q128JVSIQ; SOIC-8_5.23x5.23mm_P1.27mm
X1: 50MHz; Oscillator_SMD_Abracon_ASE-4Pin_3.2x2.5mm

Connections:
+1V0: C30.1, C31.1, C32.1, C33.1, C34.1, FB1.1, U1.1 (VCC), U1.22 (VCC), U1.45 (VCC), U1.66 (VCC)
+1V0_PLL: C44.1, C45.1, C46.1, FB1.2, U1.14 (VCCPLLL1), U1.50 (VCCPLLR1)
+3V3: C35.1, C36.1, C37.1, C38.1, C39.1, C40.1, C41.1, C42.1, C43.1, C47.1, C48.1, J7.1, R22.2, R23.2, R24.2, R25.2, R28.2, U1.3 (VCCX/VCCIO2/6/7), U1.12 (VCCX/VCCIO2/6/7), U1.23 (VCCIO5), U1.44 (VCCIO4), U1.58 (VCCIO3), U1.64 (VCCX/VCCIO2/6/7), U1.67 (VCCIO1), U1.78 (VCCIO0), U10.8 (VCC), X1.1 (EN), X1.4 (Vdd)
CLK_50M: R30.2, U1.4 (IOL7A/LPLL1_T_in)
DBG_OE_N: U1.81 (IOT17B)
EXTR: R21.1, U1.47 (EXTR)
FASTRD_N: R25.1, U1.57 (IOR35A/FASTRD_N/D3)
FL_CLK: U1.59 (IOR34B/MCLK/D4), U10.6 (CLK)
FL_CS: R22.1, U1.60 (IOR34A/MCS_N/D5), U10.1 (~CS)
FL_DI: U1.61 (IOR33B/MO/D6), U10.5 (DI(IO0))
FL_DO: U1.62 (IOR33A/MI/D7), U10.2 (DO(IO1))
FL_IO2: R23.1, U10.3 (IO2)
FL_IO3: R24.1, U10.7 (IO3)
FPGA_IO35: U1.35 (IOB30A/GCLKT_4)
FPGA_IO36: U1.36 (IOB30B/GCLKC_4)
FPGA_IO51: U1.51 (IOR45A/RPLL2_T_in)
FPGA_IO76: U1.76 (IOT30B/GCLKC_1)
FPGA_RECONFIG_N: J7.10, R28.1, SW2.1, U1.9 (IOR31B/RECONFIG_N)
FPGA_TCK: J7.4, R29.1, U1.6 (IOR26A/TCK)
FPGA_TDI: J7.8, U1.7 (IOR26B/TDI)
FPGA_TDO: J7.6, U1.8 (IOR25A/TDO)
FPGA_TMS: J7.2, U1.5 (IOR25B/TMS)
F_NRST_SENSE: U1.15 (IOL47A/LPLL2_T_fb)
F_SWCLK: U1.84 (IOT6A)
F_SWDIO: U1.86 (IOT4A)
F_SWDIO_DIR: U1.85 (IOT4B)
F_TDI: U1.83 (IOT6B)
F_TDO: U1.11 (IOL29B/GCLKC_6)
F_TRCCLK: U1.10 (IOL29A/GCLKT_6)
F_TRC_D0: U1.17 (IOL49A)
F_TRC_D1: U1.18 (IOL49B)
F_TRC_D2: U1.19 (IOL51A)
F_TRC_D3: U1.20 (IOL51B)
GND: C30.2, C31.2, C32.2, C33.2, C34.2, C35.2, C36.2, C37.2, C38.2, C39.2, C40.2, C41.2, C42.2, C43.2, C44.2, C45.2, C46.2, C47.2, C48.2, D3.1 (K), D4.1 (K), J7.3, J7.5, J7.9, R21.2, R26.2, R27.2, R29.2, SW2.2, U1.2 (VSS), U1.21 (VSS), U1.24 (VSS), U1.43 (VSS), U1.46 (VSS), U1.65 (VSS), U1.68 (VSS), U1.89 (EPAD), U10.4 (GND), X1.2 (GND)
HSPI_D0: U1.25 (IOB6A)
HSPI_D1: U1.26 (IOB6B)
HSPI_D2: U1.27 (IOB8A)
HSPI_D3: U1.28 (IOB8B)
HSPI_D4: U1.29 (IOB14A)
HSPI_D5: U1.30 (IOB14B)
HSPI_D6: U1.31 (IOB18A)
HSPI_D7: U1.32 (IOB18B)
HSPI_D8: U1.33 (IOB24A)
HSPI_D9: U1.34 (IOB24B)
HSPI_D10: U1.37 (IOB34A)
HSPI_D11: U1.38 (IOB34B)
HSPI_D12: U1.39 (IOB40A)
HSPI_D13: U1.40 (IOB40B)
HSPI_D14: U1.41 (IOB43A)
HSPI_D15: U1.42 (IOB42B)
HSPI_HRACK: U1.71 (IOT44A)
HSPI_HRCLK: U1.69 (IOT50A)
HSPI_HRVLD: U1.70 (IOT44B)
HSPI_HTACK: U1.74 (IOT34B)
HSPI_HTCLK: U1.77 (IOT30A/GCLKT_1)
HSPI_HTRDY: U1.75 (IOT34A)
HSPI_HTREQ: U1.73 (IOT40A)
HSPI_HTVLD: U1.72 (IOT40B)
LED_G: R31.1, U1.80 (IOT27A/GCLKT_0)
LED_G_A: D3.2 (A), R31.2
LED_R: R32.1, U1.79 (IOT27B/GCLKC_0)
LED_R_A: D4.2 (A), R32.2
MODE0: R26.1, U1.88 (IOR30A/MODE0)
MODE1: R27.1, U1.87 (IOR30B/MODE1)
NRST_DRV: U1.82 (IOT17A)
OSC_OUT: R30.1, X1.3 (OUT)
SMA1_DIR: U1.48 (IOR49B)
SMA1_F: U1.13 (IOL45A/LPLL2_T_in)
SMA2_DIR: U1.49 (IOR49A)
SMA2_F: U1.63 (IOR29A/GCLKT_3)
TRACE_OE_N: U1.16 (IOL47B/LPLL2_C_fb)

Notes on the sheet:
GW2AR-LV18QN88C8/I7 I/O banks (all VCCIO = 3.3 V)
Power and decoupling (UG115: pins 3/12/64 = VCCX/VCCIO2/6/7)
Configuration (MSPI flash), JTAG, clock, LEDs
Trace port on bank 6: TRC_CLK on GCLKT_6 (pin 10), data on 17..20 (IDDR + IODELAY). Timestamp ref: SMA1 on LPLL2_T_in (13), local 50 MHz on LPLL1_T_in (4). HSPI: data on banks 5/4, CH569 HTCLK on GCLKT_1 (77).
VCC (1,22,45,66): 4x100n + 10u
VCCX/VCCIO2/6/7 (3,12,64): 3x100n + 10u; VCCIO0/1/3/4/5: 100n each
VCCPLLL1 (14), VCCPLLR1 (50): 1.0 V via ferrite. EXTR (47): 10k 1% to GND (UG115).
MODE[2:0] = 000 -> MSPI autoboot (MODE2 internally GND in QN88). Verify with Gowin UG290 Table 5-2 before ordering.
