radiolok/rln-trace/hw/probe-b/kicad/mcu.kicad_sch

## KiCad design hw/probe-b/kicad/mcu.kicad_sch (2026-10-04)

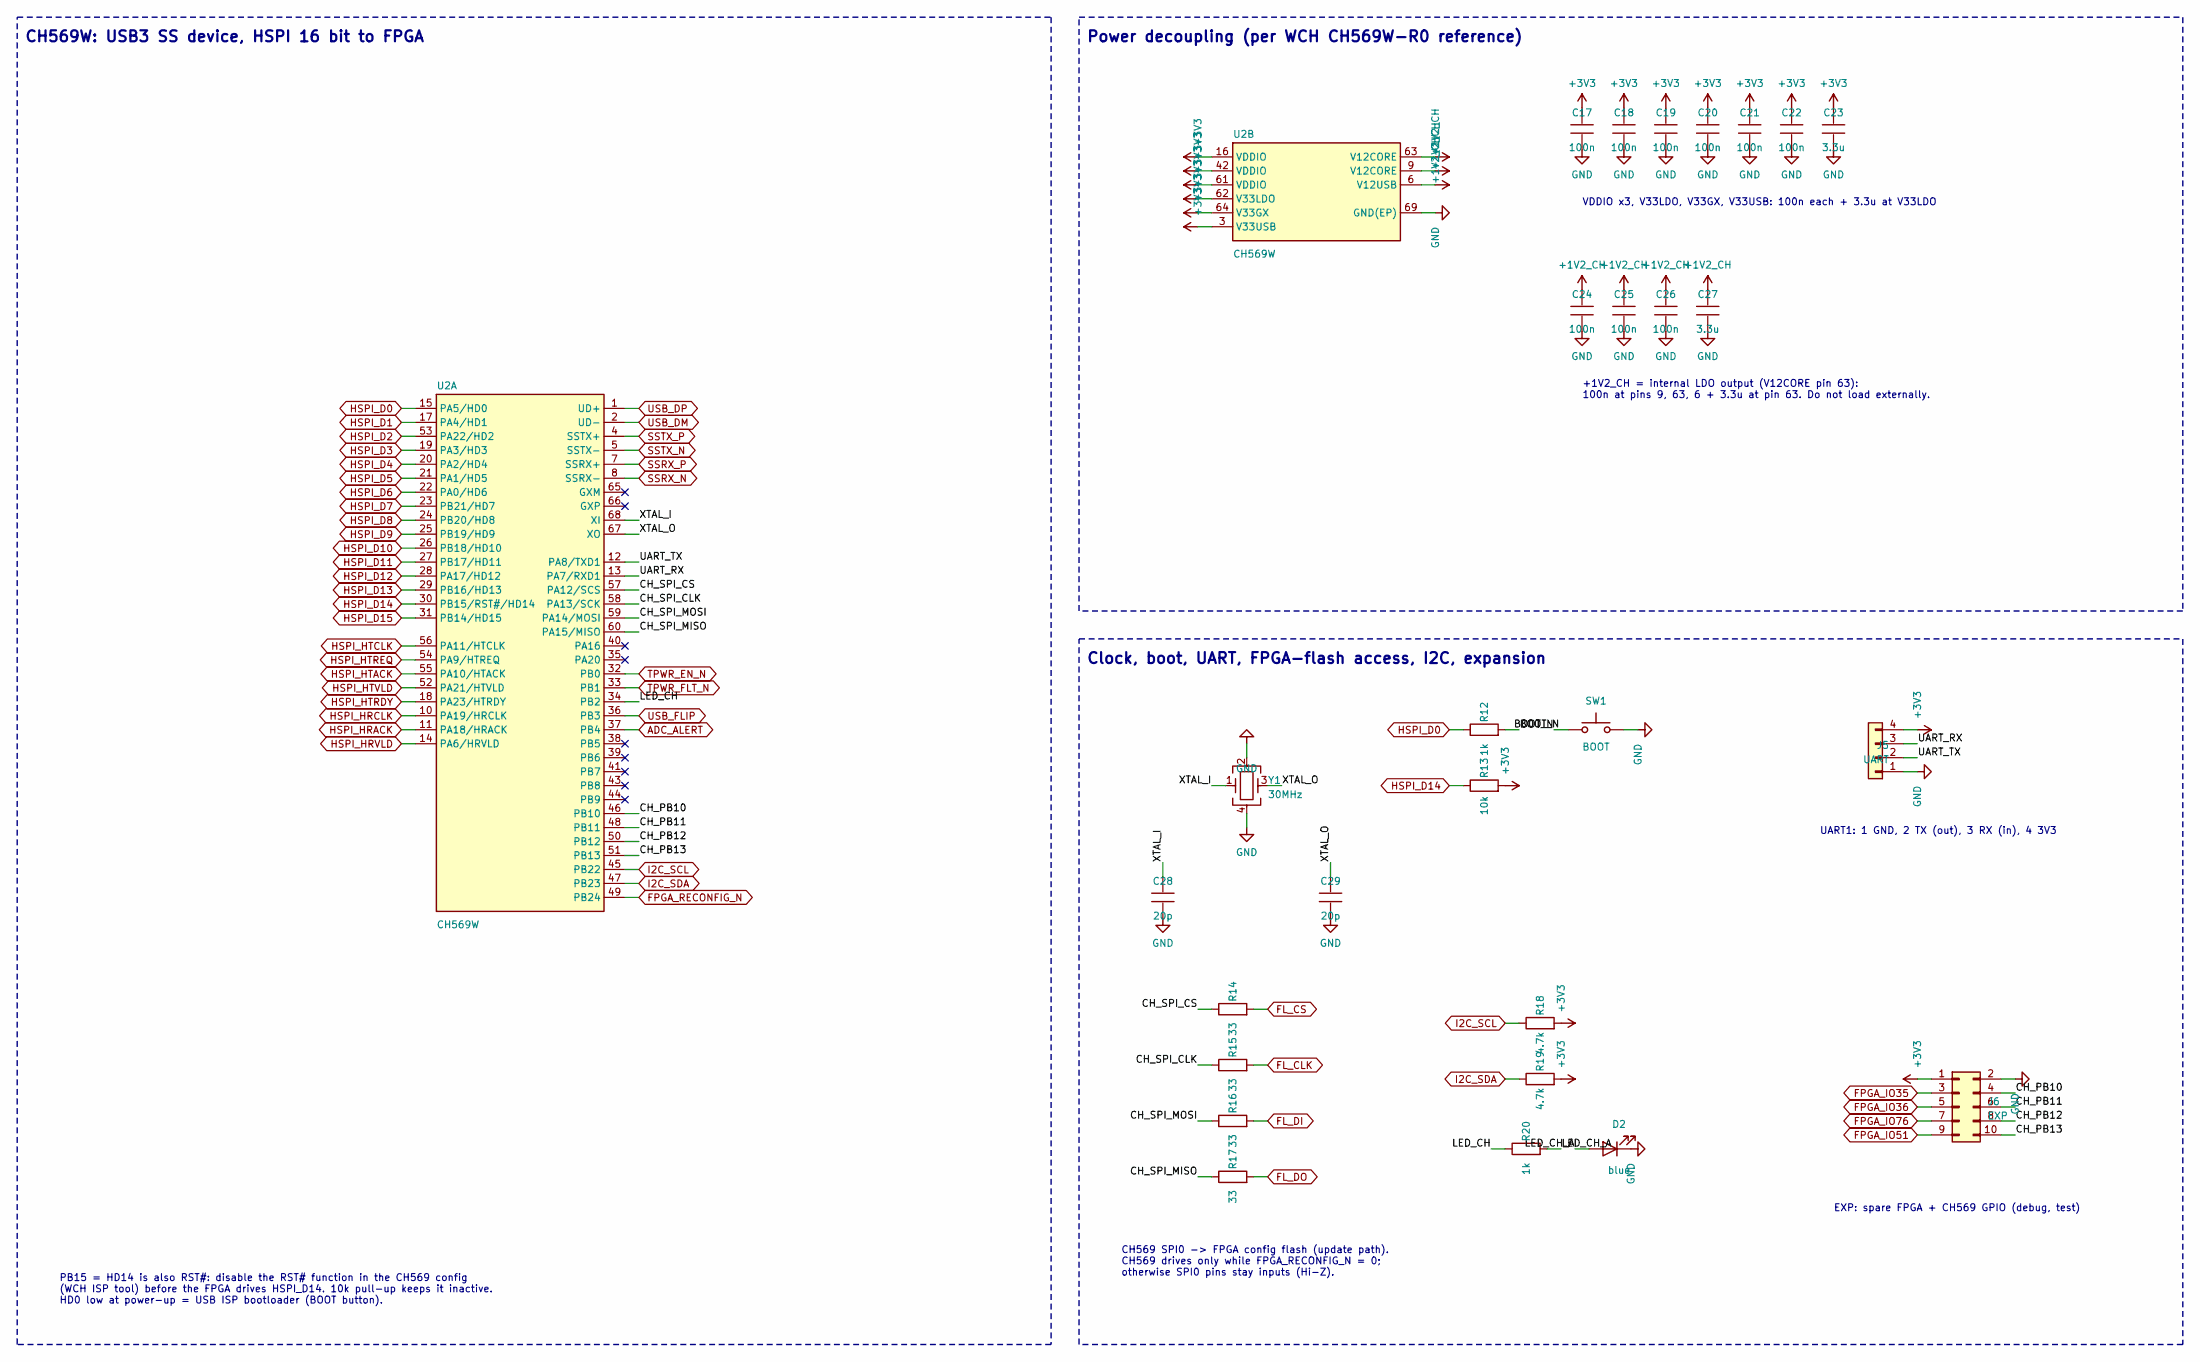
[picture p4: schematic mcu.kicad_sch]

Parts:
C17, C18, C19, C20, C21, C22, C24, C25, C26: 100n; C_0402_1005Metric
C23, C27: 3.3u; C_0603_1608Metric
C28, C29: 20p; C_0402_1005Metric
D2: blue; LED_0603_1608Metric
J5: UART; PinHeader_1x04_P2.54mm_Vertical
J6: EXP; PinHeader_2x05_P1.27mm_Vertical_SMD
R12, R20: 1k; R_0402_1005Metric
R13: 10k; R_0402_1005Metric
R14, R15, R16, R17: 33; R_0402_1005Metric
R18, R19: 4.7k; R_0402_1005Metric
SW1: BOOT; SW_SPST_PTS810
U2: CH569W; QFN-68-1EP_8x8mm_P0.4mm_EP5.2x5.2mm
Y1: 30MHz; Crystal_SMD_3225-4Pin_3.2x2.5mm

Connections:
+1V2_CH: C24.1, C25.1, C26.1, C27.1, U2.6 (V12USB), U2.9 (V12CORE), U2.63 (V12CORE)
+3V3: C17.1, C18.1, C19.1, C20.1, C21.1, C22.1, C23.1, J5.4, J6.1, R13.2, R18.2, R19.2, U2.3 (V33USB), U2.16 (VDDIO), U2.42 (VDDIO), U2.61 (VDDIO), U2.62 (V33LDO), U2.64 (V33GX)
ADC_ALERT: U2.37 (PB4)
BOOT_N: R12.2, SW1.1
CH_PB10: J6.4, U2.46 (PB10)
CH_PB11: J6.6, U2.48 (PB11)
CH_PB12: J6.8, U2.50 (PB12)
CH_PB13: J6.10, U2.51 (PB13)
CH_SPI_CLK: R15.1, U2.58 (PA13/SCK)
CH_SPI_CS: R14.1, U2.57 (PA12/SCS)
CH_SPI_MISO: R17.1, U2.60 (PA15/MISO)
CH_SPI_MOSI: R16.1, U2.59 (PA14/MOSI)
FL_CLK: R15.2
FL_CS: R14.2
FL_DI: R16.2
FL_DO: R17.2
FPGA_IO35: J6.3
FPGA_IO36: J6.5
FPGA_IO51: J6.9
FPGA_IO76: J6.7
FPGA_RECONFIG_N: U2.49 (PB24)
GND: C17.2, C18.2, C19.2, C20.2, C21.2, C22.2, C23.2, C24.2, C25.2, C26.2, C27.2, C28.2, C29.2, D2.1 (K), J5.1, J6.2, SW1.2, U2.69 (GND(EP)), Y1.2, Y1.4
HSPI_D0: R12.1, U2.15 (PA5/HD0)
HSPI_D1: U2.17 (PA4/HD1)
HSPI_D2: U2.53 (PA22/HD2)
HSPI_D3: U2.19 (PA3/HD3)
HSPI_D4: U2.20 (PA2/HD4)
HSPI_D5: U2.21 (PA1/HD5)
HSPI_D6: U2.22 (PA0/HD6)
HSPI_D7: U2.23 (PB21/HD7)
HSPI_D8: U2.24 (PB20/HD8)
HSPI_D9: U2.25 (PB19/HD9)
HSPI_D10: U2.26 (PB18/HD10)
HSPI_D11: U2.27 (PB17/HD11)
HSPI_D12: U2.28 (PA17/HD12)
HSPI_D13: U2.29 (PB16/HD13)
HSPI_D14: R13.1, U2.30 (PB15/RST#/HD14)
HSPI_D15: U2.31 (PB14/HD15)
HSPI_HRACK: U2.11 (PA18/HRACK)
HSPI_HRCLK: U2.10 (PA19/HRCLK)
HSPI_HRVLD: U2.14 (PA6/HRVLD)
HSPI_HTACK: U2.55 (PA10/HTACK)
HSPI_HTCLK: U2.56 (PA11/HTCLK)
HSPI_HTRDY: U2.18 (PA23/HTRDY)
HSPI_HTREQ: U2.54 (PA9/HTREQ)
HSPI_HTVLD: U2.52 (PA21/HTVLD)
I2C_SCL: R18.1, U2.45 (PB22)
I2C_SDA: R19.1, U2.47 (PB23)
LED_CH: R20.1, U2.34 (PB2)
LED_CH_A: D2.2 (A), R20.2
SSRX_N: U2.8 (SSRX-)
SSRX_P: U2.7 (SSRX+)
SSTX_N: U2.5 (SSTX-)
SSTX_P: U2.4 (SSTX+)
TPWR_EN_N: U2.32 (PB0)
TPWR_FLT_N: U2.33 (PB1)
UART_RX: J5.3, U2.13 (PA7/RXD1)
UART_TX: J5.2, U2.12 (PA8/TXD1)
USB_DM: U2.2 (UD-)
USB_DP: U2.1 (UD+)
USB_FLIP: U2.36 (PB3)
XTAL_I: C28.1, U2.68 (XI), Y1.1
XTAL_O: C29.1, U2.67 (XO), Y1.3

Notes on the sheet:
CH569W: USB3 SS device, HSPI 16 bit to FPGA
Power decoupling (per WCH CH569W-R0 reference)
Clock, boot, UART, FPGA-flash access, I2C, expansion
PB15 = HD14 is also RST#: disable the RST# function in the CH569 config (WCH ISP tool) before the FPGA drives HSPI_D14. 10k pull-up keeps it inactive. HD0 low at power-up = USB ISP bootloader (BOOT button).
VDDIO x3, V33LDO, V33GX, V33USB: 100n each + 3.3u at V33LDO
+1V2_CH = internal LDO output (V12CORE pin 63): 100n at pins 9, 63, 6 + 3.3u at pin 63. Do not load externally.
UART1: 1 GND, 2 TX (out), 3 RX (in), 4 3V3
CH569 SPI0 -> FPGA config flash (update path). CH569 drives only while FPGA_RECONFIG_N = 0; otherwise SPI0 pins stay inputs (Hi-Z).
EXP: spare FPGA + CH569 GPIO (debug, test)
