radiolok/rln-trace/hw/probe-b/kicad/sma.kicad_sch

## KiCad design hw/probe-b/kicad/sma.kicad_sch (2026-10-04)

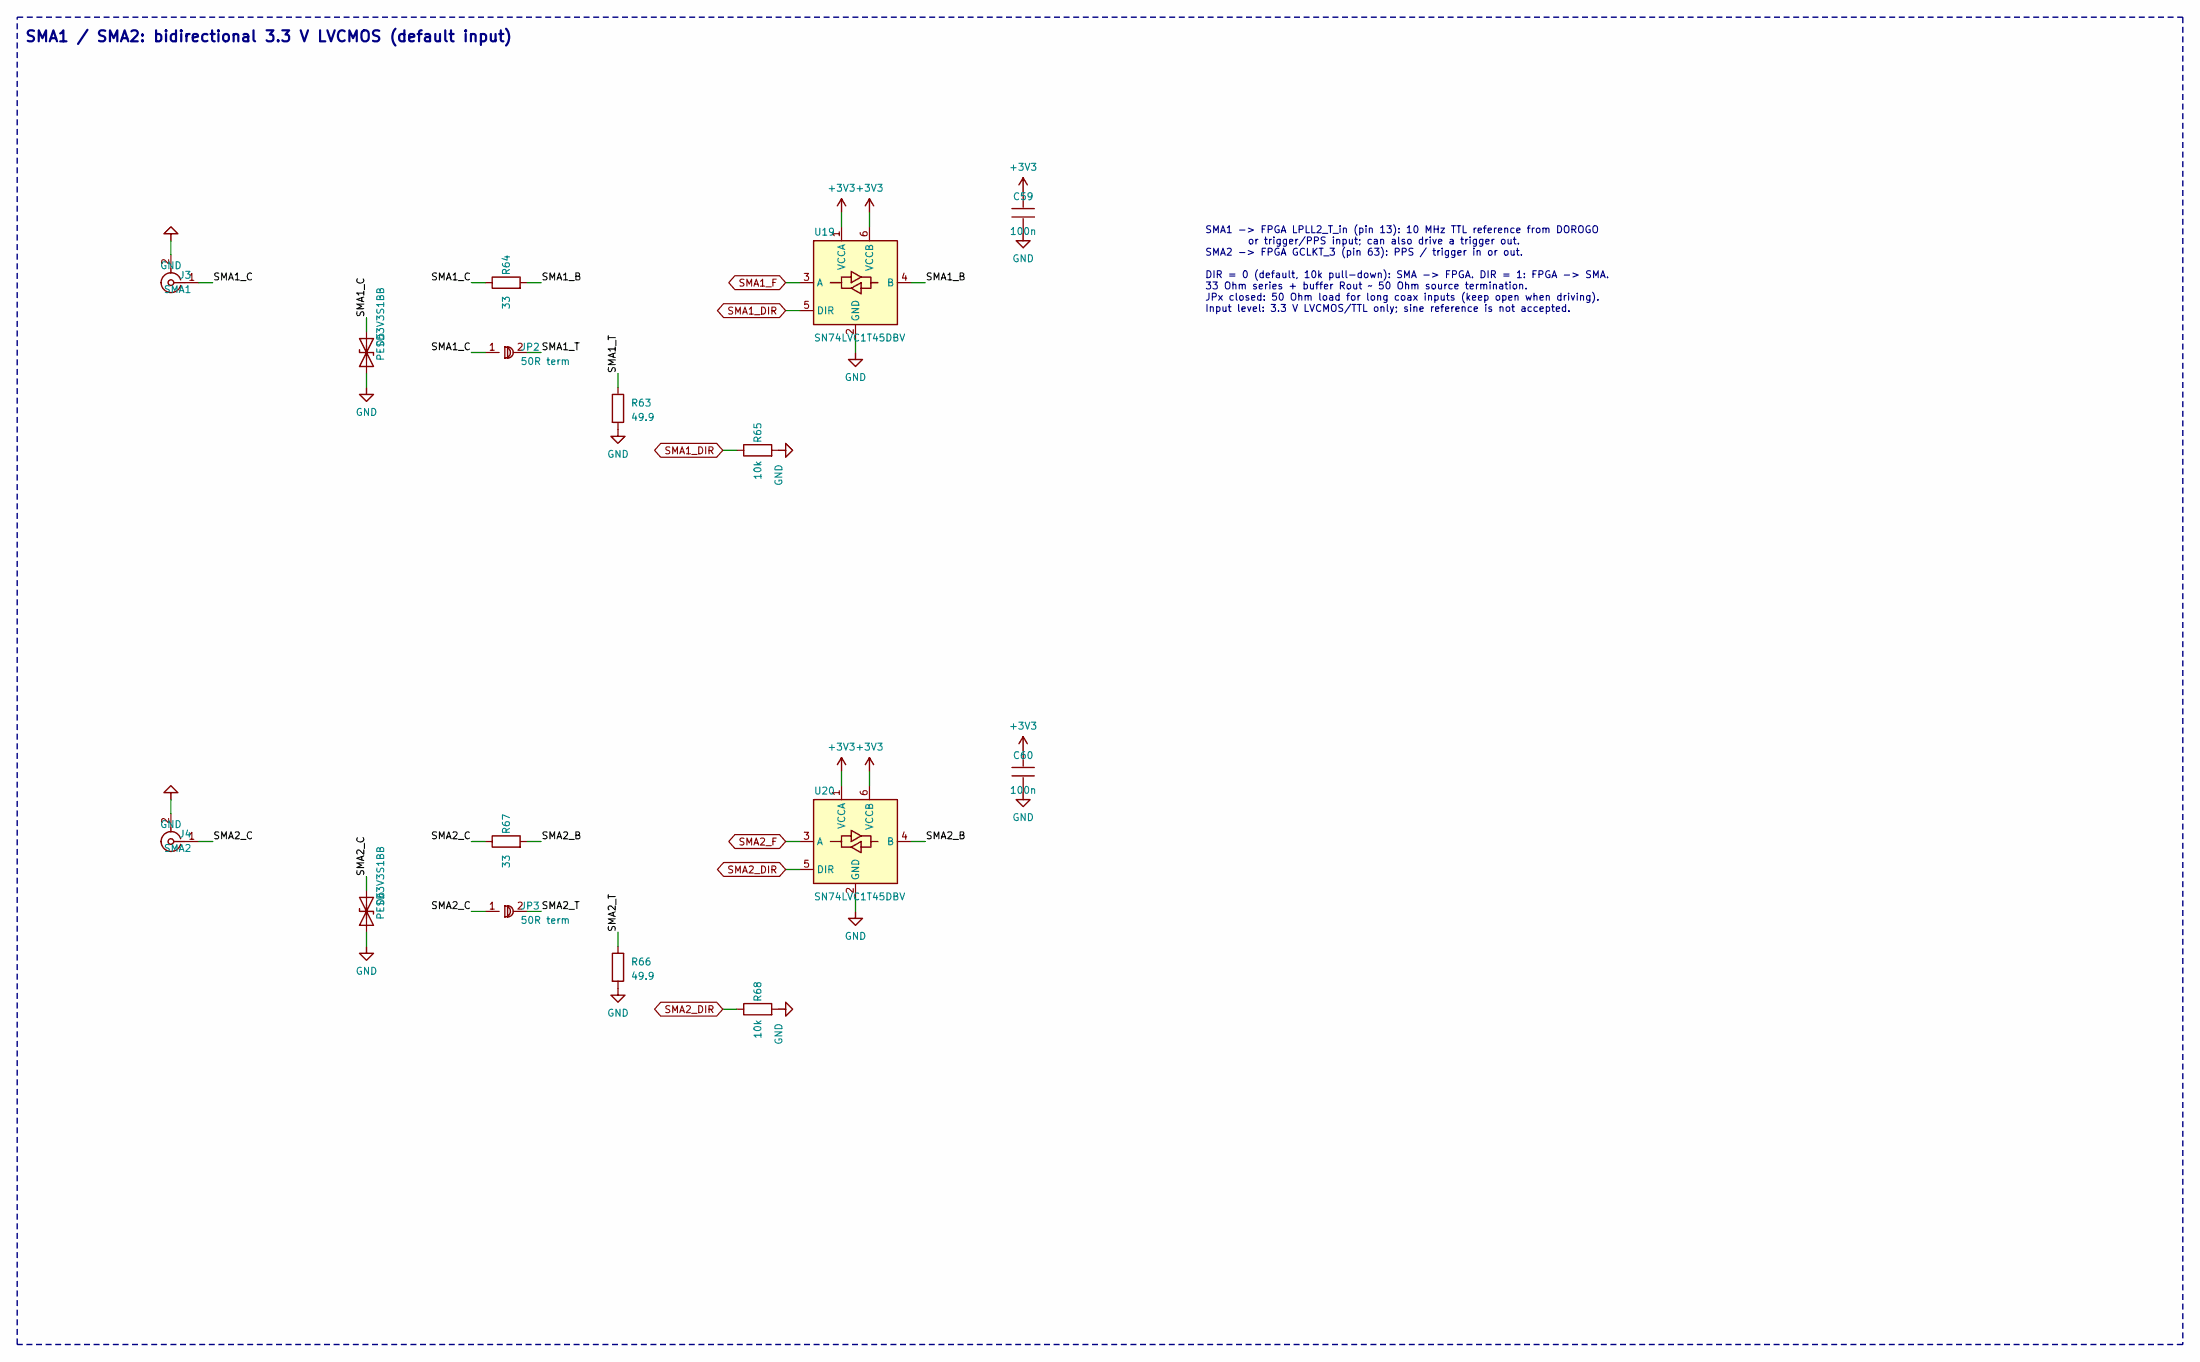
[picture p5: schematic sma.kicad_sch]

Parts:
C59, C60: 100n; C_0402_1005Metric
D5, D6: PESD3V3S1BB; D_SOD-523
J3: SMA1; SMA_Amphenol_132289_EdgeMount
J4: SMA2; SMA_Amphenol_132289_EdgeMount
JP2, JP3: 50R term; SolderJumper-2_P1.3mm_Open_RoundedPad1.0x1.5mm
R63, R66: 49.9; R_0402_1005Metric
R64, R67: 33; R_0402_1005Metric
R65, R68: 10k; R_0402_1005Metric
U19, U20: SN74LVC1T45DBV; SOT-23-6

Connections:
+3V3: C59.1, C60.1, U19.1 (VCCA), U19.6 (VCCB), U20.1 (VCCA), U20.6 (VCCB)
GND: C59.2, C60.2, D5.1 (A1), D6.1 (A1), J3.2 (Ext), J4.2 (Ext), R63.2, R65.2, R66.2, R68.2, U19.2 (GND), U20.2 (GND)
SMA1_B: R64.2, U19.4 (B)
SMA1_C: D5.2 (A2), J3.1 (In), JP2.1 (A), R64.1
SMA1_DIR: R65.1, U19.5 (DIR)
SMA1_F: U19.3 (A)
SMA1_T: JP2.2 (B), R63.1
SMA2_B: R67.2, U20.4 (B)
SMA2_C: D6.2 (A2), J4.1 (In), JP3.1 (A), R67.1
SMA2_DIR: R68.1, U20.5 (DIR)
SMA2_F: U20.3 (A)
SMA2_T: JP3.2 (B), R66.1

Notes on the sheet:
SMA1 / SMA2: bidirectional 3.3 V LVCMOS (default input)
SMA1 -> FPGA LPLL2_T_in (pin 13): 10 MHz TTL reference from DOROGO or trigger/PPS input; can also drive a trigger out. SMA2 -> FPGA GCLKT_3 (pin 63): PPS / trigger in or out. DIR = 0 (default, 10k pull-down): SMA -> FPGA. DIR = 1: FPGA -> SMA. 33 Ohm series + buffer Rout ~ 50 Ohm source termination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
