radiolok/rln-trace/hw/probe-b/kicad/target.kicad_sch

## KiCad design hw/probe-b/kicad/target.kicad_sch (2026-10-05)

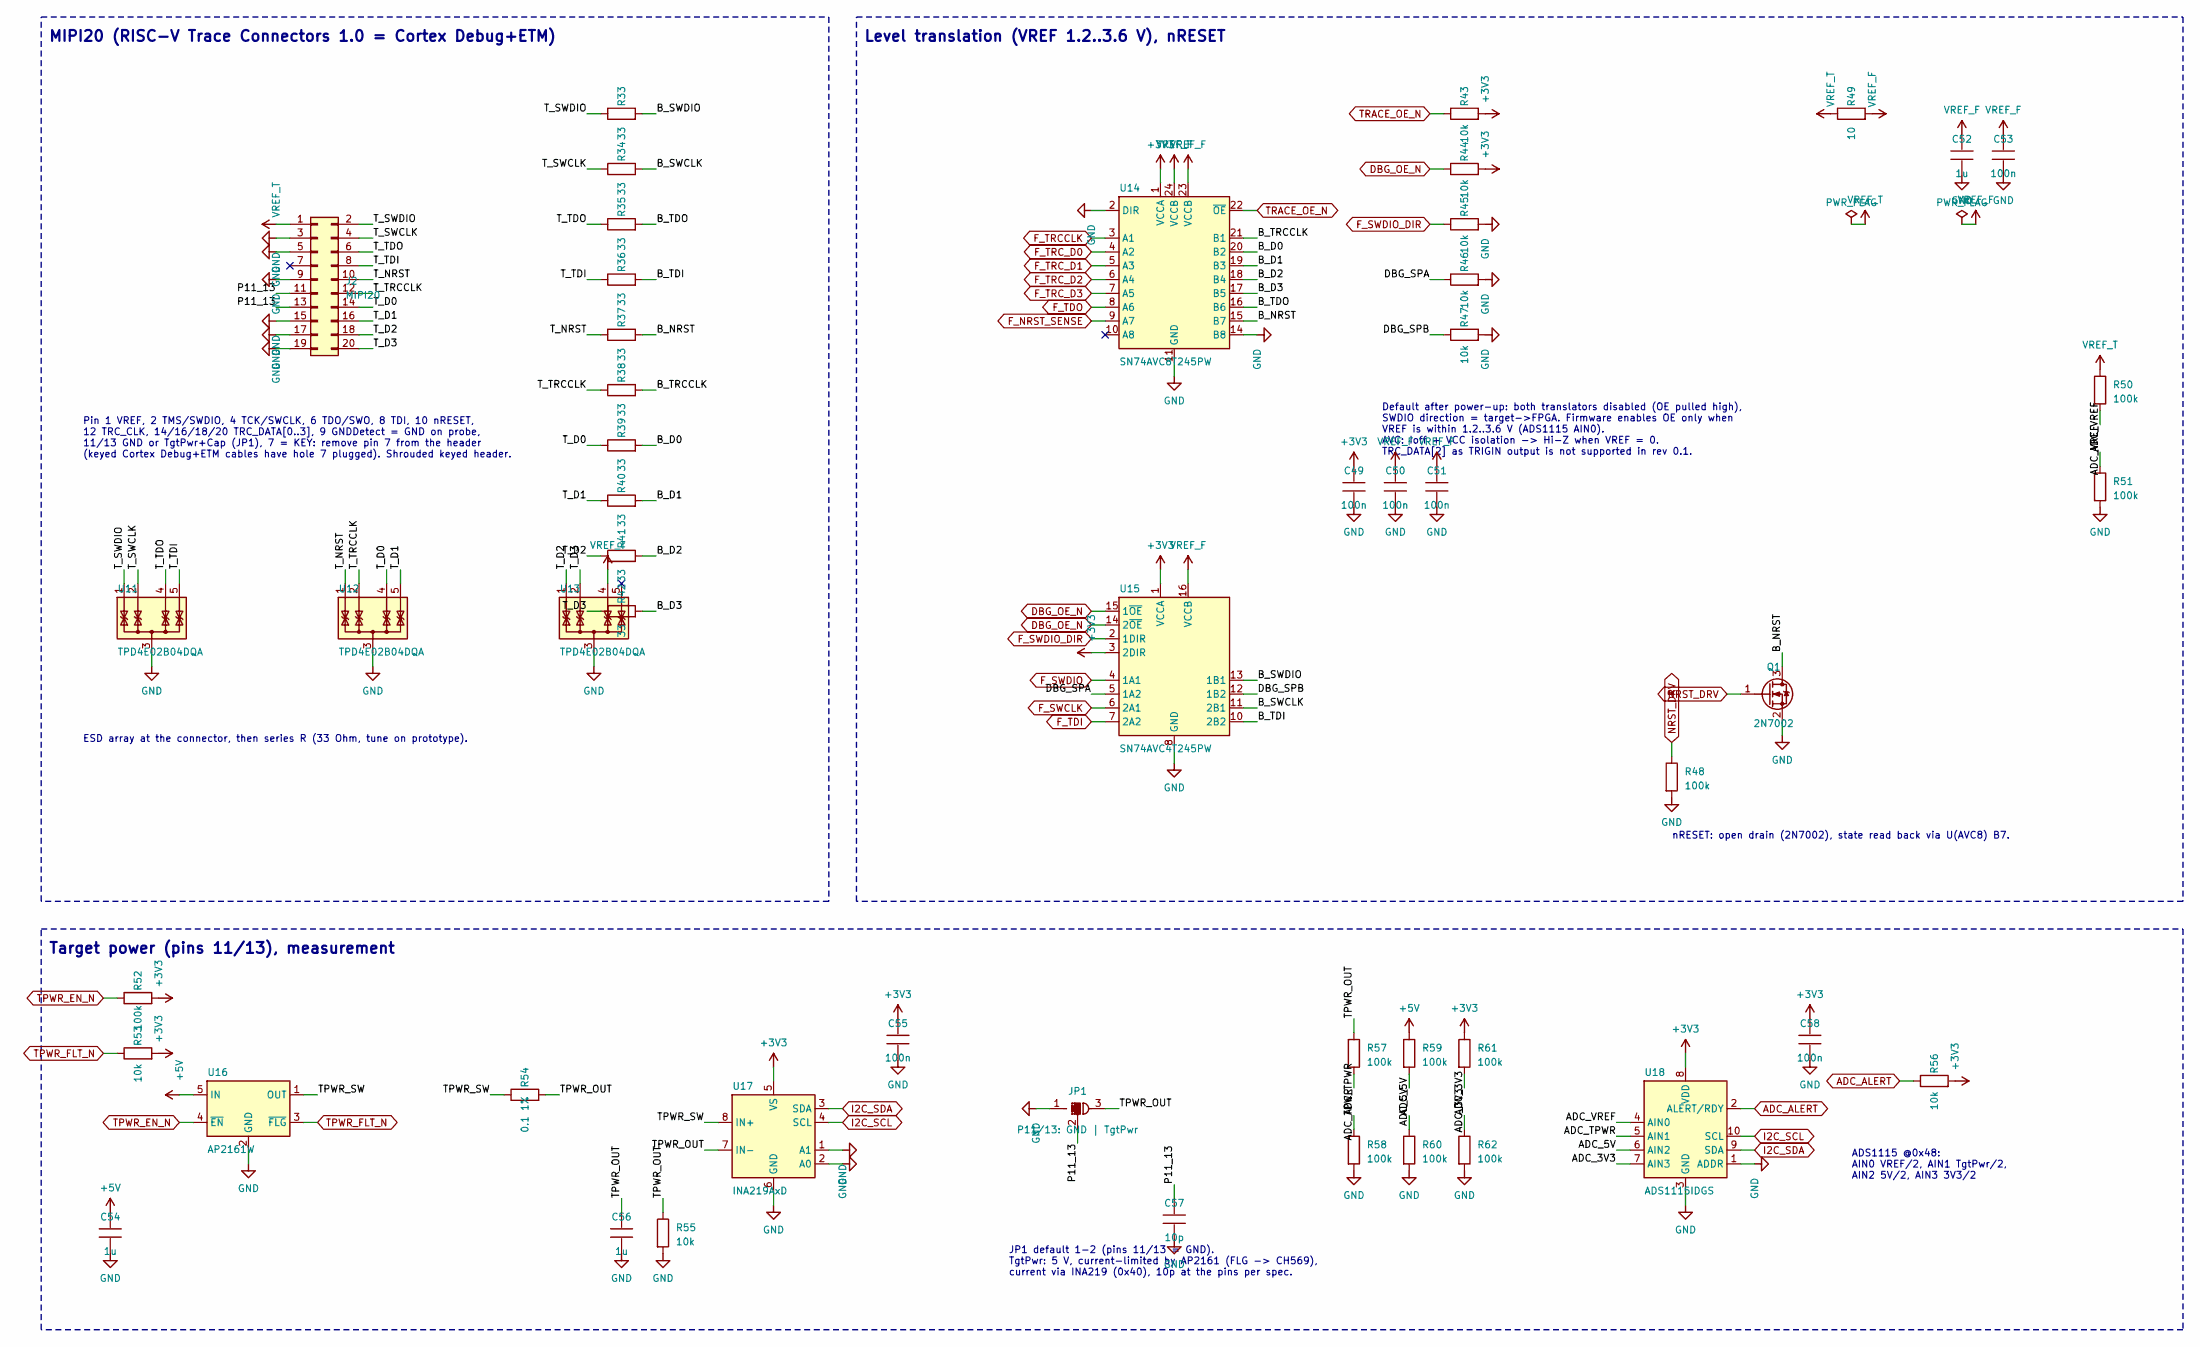
[picture p6: schematic target.kicad_sch]

Parts:
C49, C50, C51, C53, C55, C58: 100n; C_0402_1005Metric
C52, C54, C56: 1u; C_0603_1608Metric
C57: 10p; C_0402_1005Metric
J2: MIPI20; PinHeader_2x10_P1.27mm_Vertical_SMD
JP1: P11/13: GND | TgtPwr; SolderJumper-3_P1.3mm_Bridged12_RoundedPad1.0x1.5mm
Q1: 2N7002; SOT-23
R33, R34, R35, R36, R37, R38, R39, R40, R41, R42: 33; R_0402_1005Metric
R43, R44, R45, R46, R47, R53, R55, R56: 10k; R_0402_1005Metric
R48, R50, R51, R52, R57, R58, R59, R60, R61, R62: 100k; R_0402_1005Metric
R49: 10; R_0402_1005Metric
R54: 0.1 1%; R_0805_2012Metric
U11, U12, U13: TPD4E02B04DQA; USON-10_2.5x1.0mm_P0.5mm
U14: SN74AVC8T245PW; TSSOP-24_4.4x7.8mm_P0.65mm
U15: SN74AVC4T245PW; TSSOP-16_4.4x5mm_P0.65mm
U16: AP2161W; SOT-23-5
U17: INA219AxD; SOIC-8_3.9x4.9mm_P1.27mm
U18: ADS1115IDGS; VSSOP-10_3x3mm_P0.5mm

Connections:
+3V3: C49.1, C55.1, C58.1, R43.2, R44.2, R52.2, R53.2, R56.2, R61.1, U14.1 (VCCA), U15.1 (VCCA), U15.3 (2DIR), U17.5 (VS), U18.8 (VDD)
+5V: C54.1, R59.1, U16.5 (IN)
ADC_3V3: R61.2, R62.1, U18.7 (AIN3)
ADC_5V: R59.2, R60.1, U18.6 (AIN2)
ADC_ALERT: R56.1, U18.2 (ALERT/RDY)
ADC_TPWR: R57.2, R58.1, U18.5 (AIN1)
ADC_VREF: R50.2, R51.1, U18.4 (AIN0)
B_D0: R39.2, U14.20 (B2)
B_D1: R40.2, U14.19 (B3)
B_D2: R41.2, U14.18 (B4)
B_D3: R42.2, U14.17 (B5)
B_NRST: Q1.3 (D), R37.2, U14.15 (B7)
B_SWCLK: R34.2, U15.11 (2B1)
B_SWDIO: R33.2, U15.13 (1B1)
B_TDI: R36.2, U15.10 (2B2)
B_TDO: R35.2, U14.16 (B6)
B_TRCCLK: R38.2, U14.21 (B1)
DBG_OE_N: R44.1, U15.14 (2~OE), U15.15 (1~OE)
DBG_SPA: R46.1, U15.5 (1A2)
DBG_SPB: R47.1, U15.12 (1B2)
F_NRST_SENSE: U14.9 (A7)
F_SWCLK: U15.6 (2A1)
F_SWDIO: U15.4 (1A1)
F_SWDIO_DIR: R45.1, U15.2 (1DIR)
F_TDI: U15.7 (2A2)
F_TDO: U14.8 (A6)
F_TRCCLK: U14.3 (A1)
F_TRC_D0: U14.4 (A2)
F_TRC_D1: U14.5 (A3)
F_TRC_D2: U14.6 (A4)
F_TRC_D3: U14.7 (A5)
GND: C49.2, C50.2, C51.2, C52.2, C53.2, C54.2, C55.2, C56.2, C57.2, C58.2, J2.3, J2.5, J2.9, J2.15, J2.17, J2.19, JP1.1 (A), Q1.2 (S), R45.2, R46.2, R47.2, R48.2, R51.2, R55.2, R58.2, R60.2, R62.2, U11.3 (G), U11.8 (G), U12.3 (G), U12.8 (G), U13.3 (G), U13.8 (G), U14.2 (DIR), U14.11 (GND), U14.12 (GND), U14.13 (GND), U14.14 (B8), U15.8 (GND), U15.9 (GND), U16.2 (GND), U17.1 (A1), U17.2 (A0), U17.6 (GND), U18.1 (ADDR), U18.3 (GND)
I2C_SCL: U17.4 (SCL), U18.10 (SCL)
I2C_SDA: U17.3 (SDA), U18.9 (SDA)
NRST_DRV: Q1.1 (G), R48.1
P11_13: C57.1, J2.11, J2.13, JP1.2 (C)
TPWR_EN_N: R52.1, U16.4 (~EN)
TPWR_FLT_N: R53.1, U16.3 (~FLG)
TPWR_OUT: C56.1, JP1.3 (B), R54.2, R55.1, R57.1, U17.7 (IN-)
TPWR_SW: R54.1, U16.1 (OUT), U17.8 (IN+)
TRACE_OE_N: R43.1, U14.22 (~OE)
T_D0: J2.14, R39.1, U12.4 (IO3)
T_D1: J2.16, R40.1, U12.5 (IO4)
T_D2: J2.18, R41.1, U13.1 (IO1)
T_D3: J2.20, R42.1, U13.2 (IO2)
T_NRST: J2.10, R37.1, U12.1 (IO1)
T_SWCLK: J2.4, R34.1, U11.2 (IO2)
T_SWDIO: J2.2, R33.1, U11.1 (IO1)
T_TDI: J2.8, R36.1, U11.5 (IO4)
T_TDO: J2.6, R35.1, U11.4 (IO3)
T_TRCCLK: J2.12, R38.1, U12.2 (IO2)
VREF_F: C50.1, C51.1, C52.1, C53.1, R49.2, U14.23 (VCCB), U14.24 (VCCB), U15.16 (VCCB)
VREF_T: J2.1, R49.1, R50.1, U13.4 (IO3)

Notes on the sheet:
MIPI20 (RISC-V Trace Connectors 1.0 = Cortex Debug+ETM)
Level translation (VREF 1.2..3.6 V), nRESET
Target power (pins 11/13), measurement
Pin 1 VREF, 2 TMS/SWDIO, 4 TCK/SWCLK, 6 TDO/SWO, 8 TDI, 10 nRESET, 12 TRC_CLK, 14/16/18/20 TRC_DATA[0..3], 9 GNDDetect = GND on probe, 11/13 GND or TgtPwr+Cap (JP1), 7 = KEY: remove pin 7 from the header (keyed Cortex Debug+ETM cables have hole 7 plugged). Shrouded keyed header.
ESD array at the connector, then series R (33 Ohm, tune on prototype).
Default after power-up: both translators disabled (OE pulled high), SWDIO direction = target->FPGA. Firmware enables OE only when VREF is within 1.2..3.6 V (ADS1115 AIN0). AVC: Ioff + VCC isolation -> Hi-Z when VREF = 0. TRC_DATA[2] as TRIGIN output is not supported in rev 0.1.
nRESET: open drain (2N7002), state read back via U(AVC8) B7.
JP1 default 1-2 (pins 11/13 = GND). TgtPwr: 5 V, current-limited by AP2161 (FLG -> CH569), current via INA219 (0x40), 10p at the pins per spec.
ADS1115 @0x48: AIN0 VREF/2, AIN1 TgtPwr/2, AIN2 5V/2, AIN3 3V3/2
