radiolok/rln-trace/hw/probe-b/kicad/usb_power.kicad_sch

## KiCad design hw/probe-b/kicad/usb_power.kicad_sch (2026-10-04)

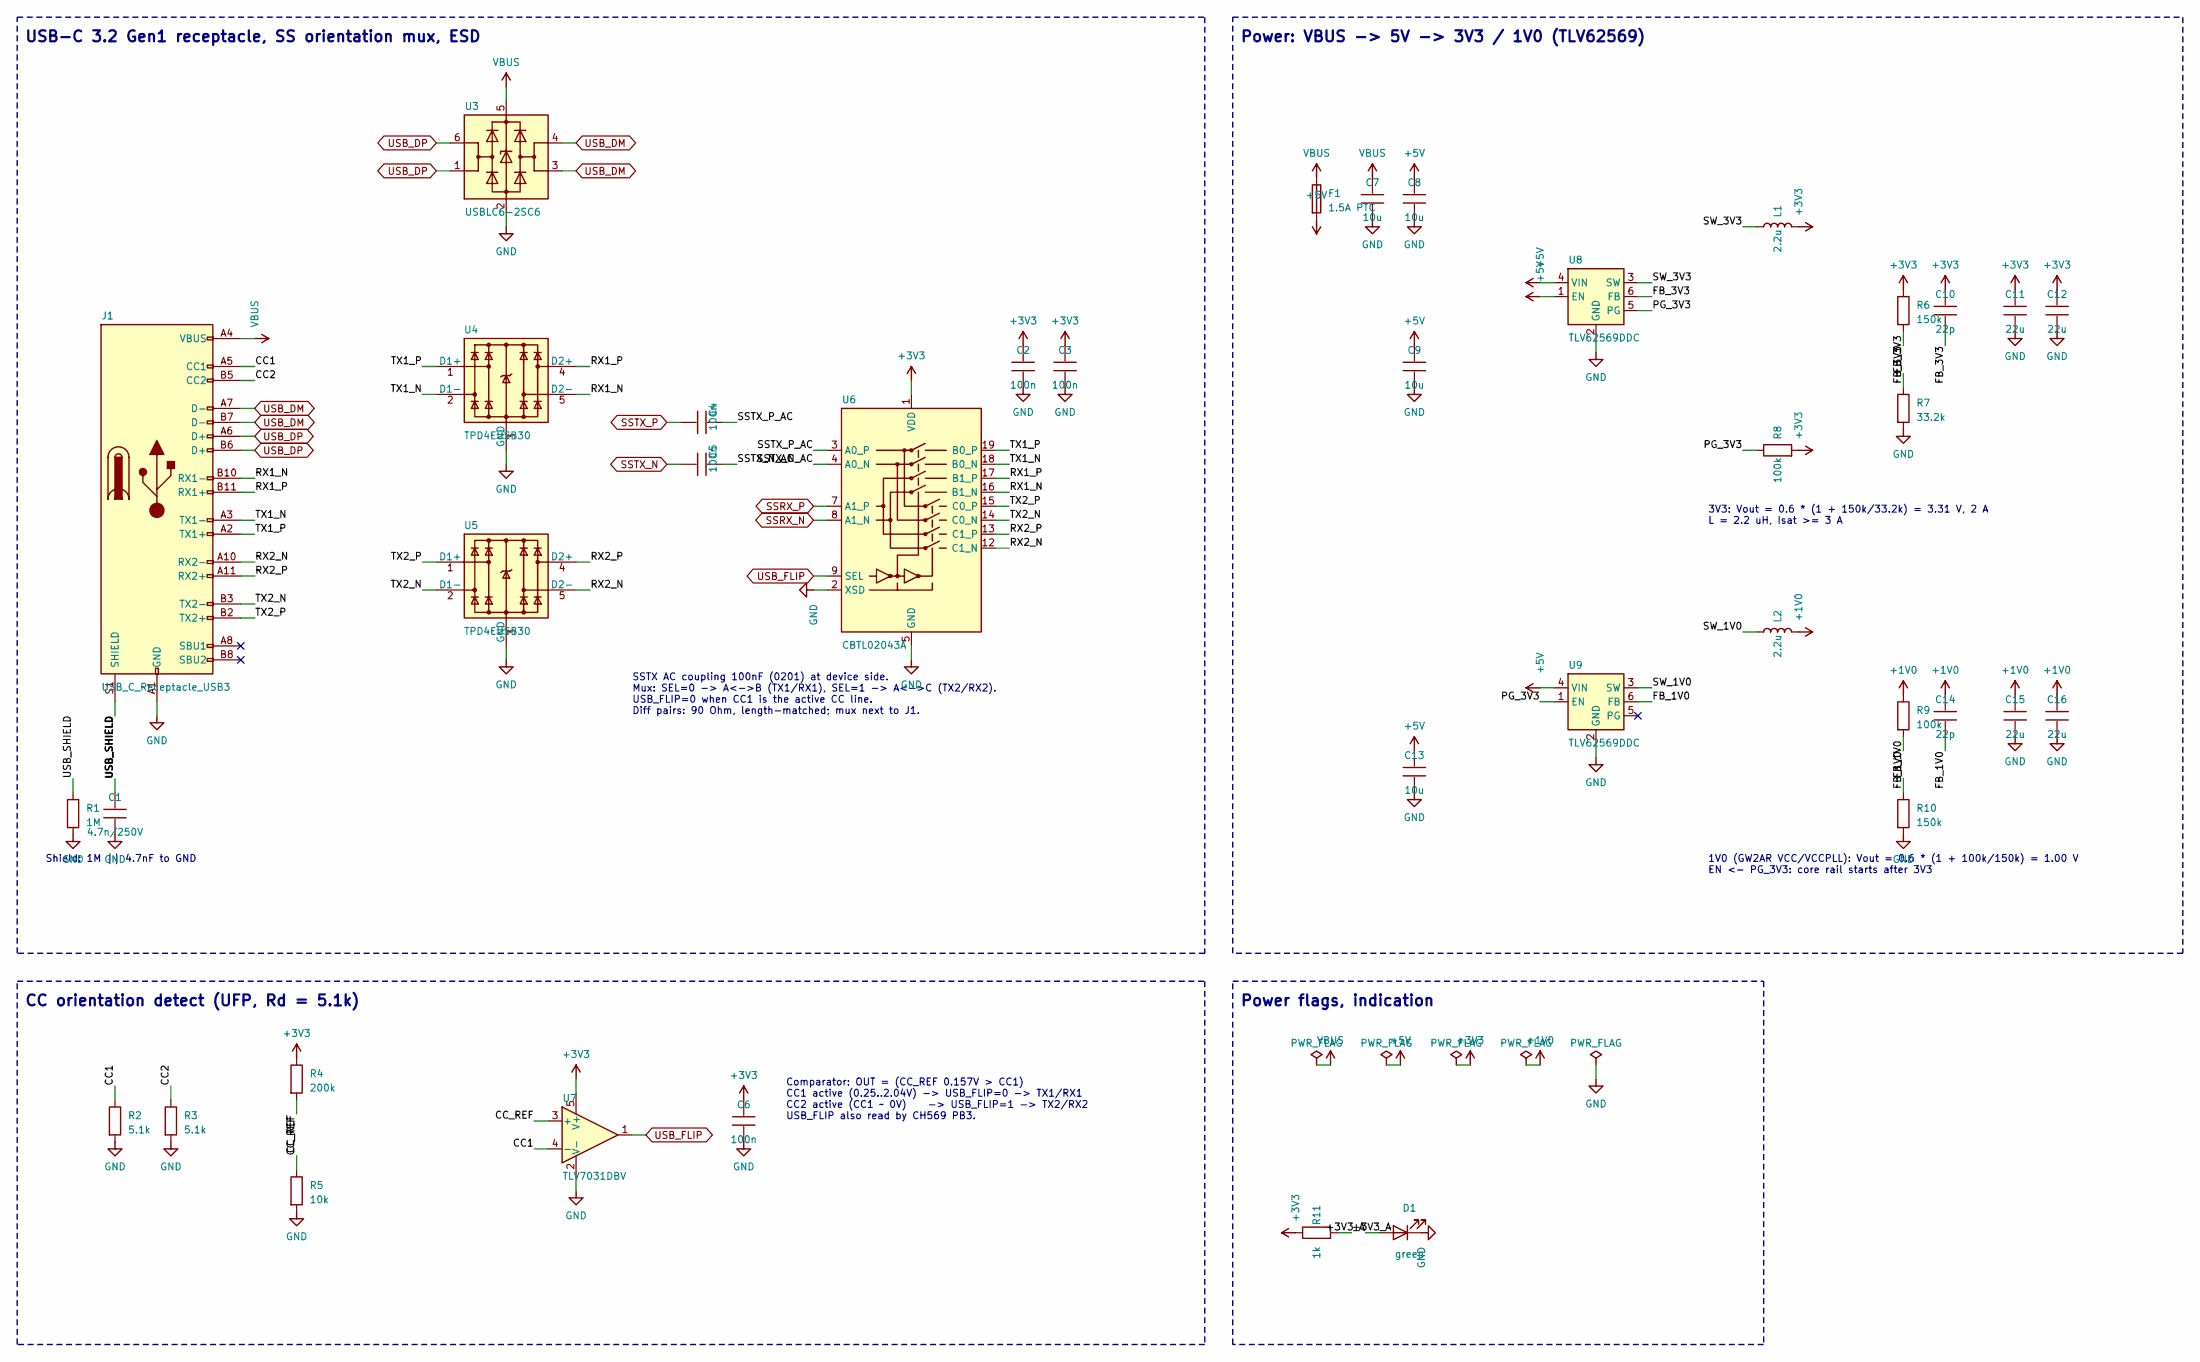
[picture p7: schematic usb_power.kicad_sch]

Parts:
C1: 4.7n/250V; C_0402_1005Metric
C2, C3, C6: 100n; C_0402_1005Metric
C4, C5: 100n; C_0201_0603Metric
C7, C8, C9, C13: 10u; C_0805_2012Metric
C10, C14: 22p; C_0402_1005Metric
C11, C12, C15, C16: 22u; C_0805_2012Metric
D1: green; LED_0603_1608Metric
F1: 1.5A PTC; Fuse_1206_3216Metric
J1: USB_C_Receptacle_USB3; USB_C_Receptacle_Amphenol_12401610E4-2A
L1, L2: 2.2u; L_1210_3225Metric
R1: 1M; R_0402_1005Metric
R2, R3: 5.1k; R_0402_1005Metric
R4: 200k; R_0402_1005Metric
R5: 10k; R_0402_1005Metric
R6, R10: 150k; R_0402_1005Metric
R7: 33.2k; R_0402_1005Metric
R8, R9: 100k; R_0402_1005Metric
R11: 1k; R_0402_1005Metric
U3: USBLC6-2SC6; SOT-23-6
U4, U5: TPD4EUSB30; USON-10_2.5x1.0mm_P0.5mm
U6: CBTL02043A; WQFN-20-1EP_2.5x4.5mm_P0.5mm_EP1x2.9mm
U7: TLV7031DBV; SOT-23-5
U8, U9: TLV62569DDC; SOT-23-6

Connections:
+1V0: C14.1, C15.1, C16.1, L2.2, R9.1
+3V3: C2.1, C3.1, C6.1, C10.1, C11.1, C12.1, L1.2, R4.1, R6.1, R8.2, R11.1, U6.1 (VDD), U6.6 (VDD), U6.10 (VDD), U7.5 (V+)
+3V3_A: D1.2 (A), R11.2
+5V: C8.1, C9.1, C13.1, F1.2, U8.1 (EN), U8.4 (VIN), U9.4 (VIN)
CC1: J1.A5 (CC1), R2.1, U7.4 (-)
CC2: J1.B5 (CC2), R3.1
CC_REF: R4.2, R5.1, U7.3 (+)
FB_1V0: C14.2, R9.2, R10.1, U9.6 (FB)
FB_3V3: C10.2, R6.2, R7.1, U8.6 (FB)
GND: C1.2, C2.2, C3.2, C6.2, C7.2, C8.2, C9.2, C11.2, C12.2, C13.2, C15.2, C16.2, D1.1 (K), J1.A1 (GND), J1.A12 (GND), J1.B1 (GND), J1.B12 (GND), R1.2, R2.2, R3.2, R5.2, R7.2, R10.2, U3.2 (GND), U4.3 (GND), U4.8 (GND), U5.3 (GND), U5.8 (GND), U6.2 (XSD), U6.5 (GND), U6.11 (GND), U6.20 (GND), U6.21 (GND), U7.2 (V-), U8.2 (GND), U9.2 (GND)
PG_3V3: R8.1, U8.5 (PG), U9.1 (EN)
RX1_N: J1.B10 (RX1-), U4.5 (D2-), U6.16 (B1_N)
RX1_P: J1.B11 (RX1+), U4.4 (D2+), U6.17 (B1_P)
RX2_N: J1.A10 (RX2-), U5.5 (D2-), U6.12 (C1_N)
RX2_P: J1.A11 (RX2+), U5.4 (D2+), U6.13 (C1_P)
SSRX_N: U6.8 (A1_N)
SSRX_P: U6.7 (A1_P)
SSTX_N: C5.1
SSTX_N_AC: C5.2, U6.4 (A0_N)
SSTX_P: C4.1
SSTX_P_AC: C4.2, U6.3 (A0_P)
SW_1V0: L2.1, U9.3 (SW)
SW_3V3: L1.1, U8.3 (SW)
TX1_N: J1.A3 (TX1-), U4.2 (D1-), U6.18 (B0_N)
TX1_P: J1.A2 (TX1+), U4.1 (D1+), U6.19 (B0_P)
TX2_N: J1.B3 (TX2-), U5.2 (D1-), U6.14 (C0_N)
TX2_P: J1.B2 (TX2+), U5.1 (D1+), U6.15 (C0_P)
USB_DM: J1.A7 (D-), J1.B7 (D-), U3.3 (I/O2), U3.4 (I/O2)
USB_DP: J1.A6 (D+), J1.B6 (D+), U3.1 (I/O1), U3.6 (I/O1)
USB_FLIP: U6.9 (SEL), U7.1
USB_SHIELD: C1.1, J1.S1 (SHIELD), R1.1
VBUS: C7.1, F1.1, J1.A4 (VBUS), J1.A9 (VBUS), J1.B4 (VBUS), J1.B9 (VBUS), U3.5 (VBUS)

Notes on the sheet:
USB-C 3.2 Gen1 receptacle, SS orientation mux, ESD
Power: VBUS -> 5V -> 3V3 / 1V0 (TLV62569)
CC orientation detect (UFP, Rd = 5.1k)
Power flags, indication
Shield: 1M || 4.7nF to GND
SSTX AC coupling 100nF (0201) at device side. Mux: SEL=0 -> A<->B (TX1/RX1), SEL=1 -> A<->C (TX2/RX2). USB_FLIP=0 when CC1 is the active CC line. Diff pairs: 90 Ohm, length-matched; mux next to J1.
Comparator: OUT = (CC_REF 0.157V > CC1) CC1 active (0.25..2.04V) -> USB_FLIP=0 -> TX1/RX1 CC2 active (CC1 ~ 0V) -> USB_FLIP=1 -> TX2/RX2 USB_FLIP also read by CH569 PB3.
3V3: Vout = 0.6 * (1 + 150k/33.2k) = 3.31 V, 2 A L = 2.2 uH, Isat >= 3 A
1V0 (GW2AR VCC/VCCPLL): Vout = 0.6 * (1 + 100k/150k) = 1.00 V EN <- PG_3V3: core rail starts after 3V3
