radiolok/rln-trace/tools/slogic/usb2/ip/usb_device_controller_define.v

// Настройки Gowin USB 2.0 Device Controller (шаблон — в USB_DEVICE_CONTROLLER.dll):
// High Speed (+ Full Speed), дескрипторы до 64 байт, питание от шины, UTMI, все точки — Bulk (0),
// отладочные выходы dbg_* (DEBUG).
`define module_name USB_Device_Controller_Top
`define HSSUPPORT
`define FSSUPPORT
`define DESC_PACKET_MAX64
`define UTMI
`define DEBUG
`define ENDPT1_IN_T_TYPE 0
`define ENDPT1_OUT_T_TYPE 0
`define ENDPT2_IN_T_TYPE 0
`define ENDPT2_OUT_T_TYPE 0
`define ENDPT3_IN_T_TYPE 0
`define ENDPT3_OUT_T_TYPE 0
`define ENDPT4_IN_T_TYPE 0
`define ENDPT4_OUT_T_TYPE 0
`define ENDPT5_IN_T_TYPE 0
`define ENDPT5_OUT_T_TYPE 0
`define ENDPT6_IN_T_TYPE 0
`define ENDPT6_OUT_T_TYPE 0
`define ENDPT7_IN_T_TYPE 0
`define ENDPT7_OUT_T_TYPE 0
`define ENDPT8_IN_T_TYPE 0
`define ENDPT8_OUT_T_TYPE 0
`define ENDPT9_IN_T_TYPE 0
`define ENDPT9_OUT_T_TYPE 0
`define ENDPT10_IN_T_TYPE 0
`define ENDPT10_OUT_T_TYPE 0
`define ENDPT11_IN_T_TYPE 0
`define ENDPT11_OUT_T_TYPE 0
`define ENDPT12_IN_T_TYPE 0
`define ENDPT12_OUT_T_TYPE 0
`define ENDPT13_IN_T_TYPE 0
`define ENDPT13_OUT_T_TYPE 0
`define ENDPT14_IN_T_TYPE 0
`define ENDPT14_OUT_T_TYPE 0
`define ENDPT15_IN_T_TYPE 0
`define ENDPT15_OUT_T_TYPE 0
