radiolok/rln-trace/(commit log)

2026-10-04 Initial project layout: README, architecture, probe-B rev 0.1 schematic
    - README with project goals, architecture summary, layout and status
    - hw/README.md: architecture of probe B (requirements, block diagram,
    MIPI20 front end, FPGA pin plan, trace pipeline, timestamps, USB
    interfaces, power, test plan, open questions)
    - hw/probe-b: KiCad 9 schematic rev 0.1 (draft), pin map, BOM, preview PDF
    - tools/schgen: schematic generator and connectivity check
    - au/: third-party projects as submodules (orbtrace, orbuculum, OpenCSD,
    free-dap, hydrausb3_fw)
    - gw/, fw/, sw/, doc/ placeholders with planned contents
    - BSD-3-Clause license
    Clau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
    [BOM_draft.csv, fpga.kicad_sch, mcu.kicad_sch, pinmap.csv, probe.kicad_sch, sma.kicad_sch, target.kicad_sch, usb_power.kicad_sch]
2026-10-04 docs: replace ASCII block diagrams with colour SVG diagrams
    - hw/img: system overview, front end, gateware, deformatter FSM,
    trace/event linkage (SVG, white background, readable in dark theme)
    - README and hw/README embed the diagrams instead of ASCII art
    - tools/diagrams/make_diagrams.py regenerates them
    Claude-Session: https://claude.ai/code/session_01C2rXcGumdBomkHLEESi7ny
    [make_diagrams.py]
2026-10-05 doc: отладочный стенд Tang Nano 20K + CH569 со схемой
    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
2026-10-05 doc: стенд на F4-Discovery и FT2232H, шаг 6 — свой SWD/JTAG
    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
2026-10-05 doc: PPS для тестов выдаёт сама цель, DOROGO убран со стенда
    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
2026-10-05 doc: переименовать схему стенда, чтобы сбросить кэш картинки
    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
2026-10-05 doc: эскизы адаптеров стенда (ПЛИС на CH569 EVT, цель на F4-Discovery)
    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
2026-10-05 MIPI20: требования к шлейфу, вывод 7 — ключ (удалён на вилках)
    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
    [target.kicad_sch]
2026-10-12 hw: универсальный JTAG-движок (R5), SBW следующим этапом, шаг 7 плана, вилка nTRST/RTCK/TEST
    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
2026-10-12 hw: без дополнительной вилки JTAG — SBW через TEST/RST на SWCLK/SWDIO, nTRST/RTCK не нужны
    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
2026-10-12 au: pico-usb-blaster; режим USB-Blaster для Quartus как следующий этап
    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
2026-10-18 CH32H417 как альтернатива CH569: сравнение, UHSIF, сменный мост в гейтваре, заметки по libUHSIF
    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
2026-10-18 uhsif-re: вскрытие libUHSIF.a — перелинковка, опкоды xw2p2, spike на Unicorn, карта регистров
    Методика для статьи в doc/uhsif-re-method.md, результаты в doc/ch32h417-uhsif.md,
    воспроизводимый конвейер tools/uhsif-re/run.sh (трассы в build/, не в репозитории).
2026-10-18 uhsif-re: выводы и питание UHSIF, Trans_Cfg, сверка с руководствами
    pinmap.py снимает раскладку UHSIF_GPIO_Init для всех ремапов и ширин; совпадает с
    даташитом V1.8 (UHSIF_PORTn) и руководством (сигнал -> PORTn), кроме AF# (вход с подтяжкой).
    Выводы UHSIF в домене VIO18 (1.2/1.8/2.5/3.3 В), UHSIF есть в QFN88. Разобран
    UHSIF_Trans_Cfg: окно дескрипторов 0x20000000..0x201FFFFF, бит 30/31 S+0x0C, ловушка
    с длиной во втором круге.
2026-10-18 fw/uhsif: открытый драйвер UHSIF, совпадает с libUHSIF.a в spike
    Драйвер с тем же API, что libUHSIF.a; таблицы WCH извлекает extract_tables.py из
    пользовательской копии библиотеки при сборке. compare.py гоняет обе реализации в Unicorn
    по 12 сценариям (~12 тыс. обращений к периферии) и сравнивает нормализованные журналы —
    совпадение полное; проверено мутантами. Поправки в карте регистров: разрешения сокета в
    S+0x14, бит 3 CTRL —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
2026-10-18 ci: сборка fw/uhsif штатными тулчейнами и сверка с libUHSIF.a в spike
    GitHub Actions: GCC rv32imac (с Zb* и без) и clang, тестовая сборка и сборка против
    заголовков StdPeriph WCH с -Werror; run.sh с закреплённой ревизией openwch/ch32h417
    сравнивает драйвер с библиотекой. run.sh теперь возвращает код compare.py
    (раньше терялся в конвейере с tee); UHSIF_IRQ_ATTR можно переопределить.
2026-10-19 doc: схемы и временные диаграммы UHSIF/CH32H417, подмодуль openwch/ch32h417
    12 схем: запись, пакет нулевой длины, чтение, окно захвата при 125 МГц (WaveDrom,
    исходники в tools/diagrams/wavedrom); каналы/сокеты/дескрипторы, карта адресов, драйвер и
    прерывание, перевзвод сокета; такт, выводы, домены питания, блок-схема МК. Встроены в
    doc/ch32h417-uhsif.md, hw/README.md, fw/uhsif/README.md. Оригиналы WCH для сверки
    генерирует uhsif_originals.py (*.orig*.png, в .giti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
2026-10-19 ci: WCH SDK из подмодуля au/ch32h417 вместо отдельного клона
    Composite action .github/actions/wch-sdk поднимает только этот подмодуль (shallow);
    ручной запуск с wch_ref переключает его на другую ревизию. run.sh берёт libUHSIF.a
    из подмодуля, скачивает только при заданном WCH_REF.
2026-10-19 ci: actions на Node 24 (checkout, setup-python, upload-artifact v7)
    Убирает предупреждение GitHub об устаревшем Node 20.
2026-10-19 hw: замер USB3 WCH на QFN88 вместе с UHSIF
    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
2026-10-19 hw: строка «Открытость» — открытый драйвер fw/uhsif
    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
2026-10-19 au: nanoCH32H417; разбор схемы платы для UHSIF — для шины с ПЛИС не подходит, стенд на WCH EVT
    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
2026-10-20 fw/ch569, sw/usbstream: поток самопроверки USB3 с CH569 без ПЛИС
    CH569 сам отдаёт в bulk EP2 IN блоки с номером и известной нагрузкой,
    утилита на ПК проверяет каждый блок и считает скорость. Половина шага 0:
    потолок USB3 -> ПК отдельно от HSPI.
    - fw/ch569/usbstream: BSP HydraUSB3 из подмодуля, форк двух файлов стека
    (EP2 IN — источник потока, EP2 OUT отбрасывается), проверка размера
    образа под USER_MEM = RAMX 96 КБ + ROM 32 КБ;
    - sw/usbstream: асинхрон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
2026-10-20 gw: приём TPIU на SystemVerilog с тестами Verilator, CI
    Гейтвар пишется на SystemVerilog вместо Chisel: подмножество, которое читают
    Verilator, Yosys и Gowin EDA.
    - tpiu_align: выравнивание по полному синхрослову на всех 32 сдвигах по биту
    (порты 1/2/4 бита), дальше поток полуслов;
    - tpiu_deframer: автомат ПОИСК/ПРОВЕРКА/ЗАХВАТ, кадры 16 байт с 64-битным
    номером, вырезка синхрослов и полусинхрослов, таймауты и счётчики;
    - tpiu_idle: выброс пу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
2026-10-20 gw: тестбенчи по абсолютным путям для Verilator 5.020, бинарники не удаляются
    Verilator 5.020 из Ubuntu 24.04 ищет относительные .cpp от -Mdir, 5.034 — от
    текущего каталога. Make считал tb промежуточным файлом и стирал его.
2026-10-20 stream: вид нагрузки в заголовке блока, PRBS31 для генератора в ПЛИС
    Слово [3] заголовка — вид нагрузки: 0 — stream_word(k), как раньше
    (прошивка CH569 шлёт его), 1 — PRBS31 x^31+x^28+1 от STREAM_PRBS31_SEED
    в каждом блоке. check.c проверяет оба вида, ожидаемые слова PRBS31 считает
    один раз; неизвестный вид — нет синхронизации.
2026-10-20 gw: генератор самотеста и передатчик HSPI, модель приёмника CH569, проверка check.c
    - selftest_gen: блоки в формате stream.h, нагрузка stream_word(k) бегущей
    суммой или PRBS31 по 32 бита за такт;
    - hspi_tx: передача в CH569 по главе 10 даташита, шина 8/16/32 бита,
    заголовок с номером пакета и USDF, CRC16 0x8005 / CRC32 0x04C11DB7 с
    параметрами init/reflect/xorout (в даташите их нет, мерить на шаге 0);
    - selftest_hspi: генератор и передатчик, блок на пакет — ПЛ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
2026-10-21 gw: захват трассы в домене TRC_CLK и переход в sys через асинхронный FIFO
    - trace_capture: две выборки IDDR за такт TRC_CLK (порядок подъём/спад
    настраивается) -> 32-битные слова для порта 1, 2 и 4 бита;
    - async_fifo: указатели в коде Грея, чтение без задержки;
    - trace_rx: захват -> FIFO -> tpiu_rx; без обратного давления на цель,
    выброшенные слова считаются и передаются в sys кодом Грея;
    - tb_trace: два независимых такта, все ширины и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
2026-10-21 gw: приём HSPI от CH569, модель передатчика CH569, подбор CRC по сырым пакетам
    - hspi_rx: приём на такте HTCLK, HTRDY только при месте под целый пакет,
    CRC отделяется линией задержки, признак «пакет хороший» (CRC, номер,
    TLL2B, длина) на закрывающем слове; номер подстраивается при верном CRC;
    сырой режим отдаёт пакет вместе с CRC для замера на шаге 0;
    - async_fifo: чтение через регистр с упреждением — FIFO hspi_rx уходит в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
2026-10-21 fw/ch569: мост HSPI -> USB3, файл платы WCH EVT, общий форк стека USB
    - common/: стек USB из BSP с EP2 IN под приложение (ep2.h: ready/done/send
    для USB3 и USB2), запуск USB и неблокирующий светодиод статуса, правила
    сборки app.mk, слой платы с тремя логическими светодиодами;
    - board_evt.c по схеме CH569W EVT: LED0 PB24, LED1 PB22, LED2 PB23 (горят
    нулём), кнопки на GPIO нет. Прежний файл HydraUSB3 читал PB23 (светодиод на
    EVT) как кнопку. Сборка по умолчанию — EVT,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
2026-10-21 gw: Tang Nano 20K для шага 0 — HSPI в CH569, замер CRC через UART, битстрим
    - boards/tangnano20k/top_step0: rPLL 27->60 МГц, selftest_hspi 8 бит в
    CH569 (HRCLK через ODDR в противофазе), hspi_rx в сыром режиме на HTCLK ->
    uart_hex -> UART BL616 hex-строками для find_crc.py; пакеты не начинаются,
    пока CH569 держит HTREQ; HD отпущена с подтяжкой вверх (HD0 — загрузчик);
    - tangnano20k.cst по распиновке гребёнок Sipeed, clocks.py: clk 60 МГц,
    HTCLK 120 МГц для nextpnr;
    - uart_tx, uart_hex с тестом (линия дек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
2026-10-21 gw: сборка Tang Nano 20K в Gowin EDA из WSL, регистр на wfree в async_fifo
    - make board-gowin: исходники, cst, SDC и Tcl во временный каталог Windows,
    gw_sh.exe, отчёты и битстрим обратно в build/tangnano20k/gowin;
    - top_step0.sdc: clk27 и производный clk 60 МГц, HTCLK 120 МГц, домены
    асинхронны;
    - async_fifo: wfree считается в регистре по следующему указателю записи
    (на такт консервативнее). Критический путь HTCLK в hspi_rx шёл через
    перевод из кода Грея и вычитание: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
2026-10-21 gw/boards/tangnano20k: цифры nextpnr после регистра на wfree
2026-10-21 Стенд: HSPI 16 бит, раскладка выводов Tang Nano 20K v2 без светодиодов
    - tangnano20k.cst v2: резисторы светодиодов сняты, все 34 вывода гребёнок
    заняты: HSPI 16 бит (24), трасса (5), PPS и SMA2, SWD; HTCLK на GCLKC_1
    (76), GCLKT_1 (77) остаётся TRACECLK; для JTAG шага 7 HSPI возвращается
    на 8 бит;
    - top_step0: W=16, CLK_MHZ 15 (проводки) / 30 / 60 / 96 с расчётом PLL и
    UART; вместо светодиодов строка состояния в UART раз в секунду;
    принятые пакеты считаются в домен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
2026-10-21 Стенд: Tang Nano 9K — источник трассы TPIU, PPS и меандра
    - tpiu_tx: синтетический порт TPIU, кадры вычисляются по номеру (байт 0 —
    смена ID на 1, байты 1/3/5/7 — номер, остальное — из номера, чётные байты
    без 0xFF), синхрослова, полусинхрослова, порт 4/2/1 бит, DDR-выборки;
    - tb_loop: tpiu_tx -> trace_rx на разных тактах, 12 сочетаний ширины,
    частоты синхрослов и полусинхрослов, каждый кадр сверяется с номером;
    - boards/tangnano9k/to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
2026-10-21 tools/slogic: чтение SPI-флеш SLogic16U3 в режиме DFU
    Мост USB-SPI по протоколу веб-прошивальщика Sipeed (slogic_ota_server):
    JEDEC ID, UID, дамп флеш и карта занятых блоков 64 КиБ. Только чтение —
    сначала бэкап заводского образа. Пакеты сверены с записанным трафиком
    эталонного прошивальщика.
2026-10-21 tools/slogic: запись флеш SLogic16U3 и открытый пробный образ
    Дамп прибора: флеш 16 МиБ, приложение с 0x0, золотой образ DFU с
    0x800000; оба зашифрованы AES (синхрослово A5DB). Утилита получила
    write и restore: стирают всю основную область, сверяют результат, в
    золотую область не пишут и проверяют, что бэкап от этого прибора.
    probe/ — пустой открытый битстрим с multiboot на 0x800000, чтобы
    проверить, грузит ли ПЛИС незашифро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
2026-10-21 tools/slogic: опыт с открытым битстримом на SLogic16U3 удался
    Пустой открытый образ загрузился вместо заводского: eFuse cfg_aes_only
    не прожжён, своя прошивка возможна. Кнопка MODE разведена на
    RECONFIG_N — с multiboot на 0x800000 она возвращает прибор в DFU,
    restore из дампа вернул заводское приложение. Статус направления A
    в README и hw/README; следующий шаг — прозвонка выводов.
2026-10-21 tools/slogic: прозвонка выводов SLogic16U3, прибор не вернулся в DFU
    pinmap/: образ для GW5AT-15 CS130 — 40 свободных выводов входами, счёт
    фронтов за 5 с, отчёт страницей во флеш по 0x7F0000; модель флеш в tb.v;
    источник меандров на STM32F4-Discovery и разбор отчёта pinmap.py.
    После записи pinmap.bin USB2 не поднимается (0000:0002), MODE больше не
    даёт DFU, отчёт не прочитан. slogic_dfu.py получил --ftdi: та же работа
    с флеш напрямую через FT2232H для вскр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
2026-10-25 tools/slogic: восстановление SLogic16U3 через JTAG, компоненты платы
    - на плате отладочный разъём 5V/TMS/TDO/TCK/TDI/RXD/TXD/GND (JTAG GW5AT,
    3,3 В) -> FT2232H; openFPGALoader читает ID и флеш, запись для XT25F128F
    стирает сектора и падает на write enable — пустой 0x0 сам даёт DFU через
    золотой образ, дальше slogic_dfu.py restore. Прибор так и вернули:
    после restore горит голубым;
    - отчёт прозвонки из дампа: ни одного фронта на 40 выводах, D3/F7/K2/N2
    держатся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
2026-10-25 tools/slogic: прозвонка входов SLogic16U3 через JTAG, все 16 каналов
    Образ jprobe (только SRAM): 36 входов без подтяжки, счёт фронтов в окне,
    результат в пользовательском регистре GW_JTAG (ER1 0x42), чтение через
    OpenOCD + FT2232H; bench.py управляет источником на STM32 через постоянный
    сервер OpenOCD (гашение линий, статика).
    Каналы CH0..CH15 — банк 1, пары IOB41, IOB12..IOB24: J14 J13 N14 P14 N13
    P13 N12 P12 N11 P11 N10 P10 N9 P9 N8 P8. Входы — делитель ~0,47, поэтому
    нуж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
2026-10-25 tools/slogic: трасса STM32F407 на SLogic16U3, шаг 1 — данные идут
    Источник: ITM-счётчик через TPIU (PE2..PE6), режим из RAM под сбросом —
    ST-LINK не держит ядро на HCLK 31 кГц. Приёмник: пятиканальный анализатор
    на OSCB с выдачей через GW_JTAG, разбор TPIU/ITM в trace.py (только
    полусловная синхронизация FF 7F, в том числе внутри кадров). Счётчик принят
    без разрывов от TRACECLK 15,6 кГц до 3,96 МГц, порт 4 бита. Журнал —
    doc/slogic-trace-journal.md.
    Co-Authored-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
2026-10-25 tools/slogic: трасса STM32 на SLogic16U3, шаг 2 — приём от TRACECLK
    Режим 2: TRACECLK на глобальный такт, данные через IODELAY (своя задержка
    на линию) в IDDR, частотомер TRACECLK в его домене через код Грея. Чисто
    до 57 МГц на штатном жгуте; выше ошибки от одновременных переключений
    линий (до 66 МГц со средней крутизной выводов STM32). JTAG-логика по спаду
    tck_o: он у GW_JTAG на GW5A инвертирован, работа по фронту была гонкой.
    Прошивк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
2026-10-25 tools/slogic: трасса инструкций ETM STM32F407 через SLogic16U3 на 50 МГц
    Прошивка включает ETM-M4 (ID 2) рядом с ITM, сохраняет ETMIDR. trace.py show
    разбирает запись на пакеты ITM и ETM (ETMv3.5, альтернативное кодирование
    адреса ветвления, правила по OpenCSD) и восстанавливает выполненные
    инструкции по objdump. На TRACECLK 50 МГц: 19 641 инструкция без потерь
    адреса, I-sync сходится с декодером, 496 записей в ITM_STIM0 = 31 × 16.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
2026-10-25 tools/slogic: примеры пакетов и таблица «исходник → ETM» в журнале трассы
    Журнал: разбор кадра TPIU с ID 1 и 2, пакеты ITM и ETM по байтам, таблицы
    строка main.c → инструкция → байт P-заголовка и атом → решение декодера.
    trace.py table печатает такие таблицы для любого места записи; прошивка
    собирается с -g (код не изменился, бинарник сверен).
2026-10-25 tools/slogic: трасса RISC-V N-Trace с BE-U1000 через SLogic16U3
    Тот же приёмник tracela.v (режим 2, IDDR от TRACECLK) принимает PIB
    BE-U1000 на EVU-BA-2.5: PB0–PB4 на XP10, R5 у QSPI-флеш снят. Трассер
    настраивается по SBA через OpenOCD из Baikal MCU SDK; он сбрасывает МК при
    каждом запуске, поэтому живёт постоянным сервером (beu1000/ocd.py,
    процедуры в trace.tcl). Прошивка fw/ — известная последовательность
    ветвлений в TCM ядра 0.
    ntrace.py: окно линий по узору калиб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
2026-10-25 au/mcu-sdk: Baikal MCU SDK подмодулем, схема стенда трассы BE-U1000
    SDK 2.4.0 с gitflic: OpenOCD лежит в самом репозитории — ocd.py берёт его
    оттуда (проверено на плате). Тулчейн — вложенный подмодуль на 1,7 ГБ,
    закреплён на Windows-ветке; на Linux клонируется тег 2.4.0_lin
    (au/README.md), собирает прошивку побайтно так же, как архив 2.3.0.
    fw/Makefile и ntrace.py берут компилятор из подмодуля, иначе из архива.
    Журнал: ссылки на PDF — на сайт Байк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
2026-10-25 tools/slogic: свой USB2 на SLogic16U3 — FS работает, HS ещё нет
    - uprobe: прозвонка свободных GPIO ведением по JTAG — найдены выводы Gowin
    USB 2.0 SoftPHY (Single LVDS по IPUG781); D13 = 0 перезапускает ПЛИС
    - sdprobe: генератор 125 МГц на REFCLK SerDes Q0, QPLL1 захватывается,
    62,5 МГц в логику; CSR из toml без GUI
    - usb2: SoftPHY + Device Controller из CLI, 2 PLL 62,5→40→480/60 МГц,
    ПЗУ дескрипторов, журнал пакетов UTMI через JTAG; FS: перечисление,
    bulk IN 1,10 МБ/с без разрывов, bulk OUT.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
2026-10-25 doc/slogic-usb-journal: Daisho как кандидат на стек USB3/USB2
2026-10-25 tools/slogic/usb2: USB2 HS на SLogic16U3 — bulk IN 25 МБ/с без потерь
    Три ошибки, каждая маскировала следующую:
    - пары перепутаны: dx = K3/K2, терминаторы = P2/P1 (в FS работает любое
    назначение); D14 — разрешение генератора 125 МГц, теперь в 1 явно
    - на Arora V SoftPHY ждёт fclk 960 МГц, а не 480 (IPUG781): IDES16 DDR,
    4 отсчёта на бит; так в примере Sipeed для Tang Mega 138K Pro.
    TX Delay 1, RX Normal — как там же
    - CM1_LIFE_CLK квада не от генератора: −10 483 ppm к SOF хоста.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
2026-10-25 tools/slogic/usb2: свой стек USB2 — ядро Daisho поверх UTMI SoftPHY
    Device Controller Gowin заменён USB2-частью Daisho (daisho/, BSD-2, с
    коммита 27bc20c зеркала enjoy-digital). Вместо слоя ULPI — свой
    usb2_utmi.v с тем же интерфейсом к пакетному уровню:
    - передача: TX_CMD → PID {~P, P}, nxt = txready, stp снимает txvalid
    - сброс шины и согласование HS по USB 2.0 7.1.7.5: чирп K 2 мс, ждать
    K-J-K-J-K-J хоста по LineState (у Daisho было вслепую); 3 мс тишины в
    HS → FS, SE0 — сброс, J — приостано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
2026-10-25 tools/slogic/usb2: команды по USB — vendor-запросы EP0
    - vendor OUT 0x10 + n (без стадии данных): регистр n ← {wIndex, wValue};
    n = 0 — cmd (метка 0xA, как у JTAG)
    - vendor IN 0x01: слова состояния с wIndex, до 64 байт одним пакетом
    EP0 Daisho достроен: стадия данных IN из внешнего порта (задержка в такт,
    как у ПЗУ дескрипторов), wIndex наружу. В usb2d.v слова 0..23 общие для
    ER1 и USB; cmd в домене 60 МГц, пишется по USB и по JTAG (через
    переключатель), действует по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
2026-10-25 tools/slogic/usb2: WinUSB через MS OS 2.0 — 46,5 МБ/с под Windows без usbipd
    - usb2d: bcdUSB 2.10, BOS (расширение USB 2.0 + платформа MS OS 2.0),
    vendor IN 0x20 / wIndex 7 → набор MS OS 2.0 с CompatibleID WINUSB, оба из
    ПЗУ дескрипторов; Windows ставит WinUSB сама, без Zadig
    - usb2stream.py: проверка счётчика на numpy, чтение в готовый буфер; под
    Windows libusb из libusb-package
    Замер (чанк 1 МБ): Windows WinUSB 46,5 МБ/с, через usbipd 43,7 МБ/с, без
    разрывов. Прежние 24–25 МБ/с ограничивала проверка в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
2026-10-25 doc/slogic-usb-journal: USB3 SS на эталоне ciniml — 462 МБ/с под Windows
    Ядро USB3 — rtl/usb3 К. Иды (ciniml/fpga_samples, BSL-1.0), уже поднятое на
    SLogic16U3, вместо Daisho. Эталон eda/slogic16u3_usb3 собран нашей Gowin
    1.9.12.04 из WSL (set_csr), ER1 со статусом LTSSM читается через FT2232H.
    - LTSSM стоял в RxDetect.Active: кабель без SS-жил (заводская прошивка
    на нём тоже не появлялась); с родным кабелем — U0 с первой заливки
    - EP1 IN PRBS15, WinUSB: синхронно 268–291 МБ/с, асинхронная о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
2026-10-25 tools/slogic/usb3: USB3 на стеке ciniml — своя сборка, IP из своей Gowin EDA
    - ciniml/: rtl/usb3 (Veryl) и эталонный верх eda/slogic16u3_usb3 К. Иды
    без изменений (BSL-1.0, коммит 41354eb), csr квада оттуда же
    - build.sh: обёртка SerDes из GowinModGen (ip/serdes.mod), нетлисты
    USB 3.0 PHY и арбитра upar — синтезом зашифрованных исходников Gowin
    со своими define-файлами; veryl build → .sv; set_csr
    - ключ EnableDRP true: без него обёртка без арбитра upar
    - host/u3status.py — ER1 (LTSSM, история, счёт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
2026-10-25 tools/slogic/usb3: pclk 125 МГц закрыт — правка LTSSM и CRC-32, перебор расстановок
    PnR Gowin без зерна: на GW5AT-15 (81 % CLS) малая правка двигает pclk
    на ±10 МГц, мера — распределение по place_option 1..4.
    - usb3_ltssm: сравнения с порогом — флагами при инкременте; счётчики
    обнуляются по st_chg или держатся в 0 вне Polling.LFPS, а не из
    next-state (state → сравнение → ns → сброс 17-битного tseq_cnt)
    - usb3_rx_parser: CRC-32 приёма DPP в две стадии, вердикт DPP так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
2026-10-25 tools/slogic/usb3: свой верх usb3d — регистры по EP0, журнал по JTAG, поток трассы
    - usb3d.v на каркасе эталона ciniml: регистры через порт Usb3Device
    (vendor 0x03/0x04), приём трассы как режим 2 tracela (IODELAY → IDDR
    от TRACECLK), журнал заголовков в ER2; запись PIPE-слов и петля
    EP1 OUT → IN убраны (BSRAM, CLS, путь out_len → in_ram)
    - u3stream.v: afifo 512 слов (TRACECLK → pclk) → sfifo 16 КБ → EP1 IN
    слово в такт; счётчики потерь на обоих стыках; тестовый источник
    - sim/run.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
2026-10-25 README: проект — приёмник трассы на SLogic16U3; usb3d.bin для DFU
    - корневой README только про вариант на SLogic16U3: что это, схема работы
    (doc/img/slogic-trace.svg), как начать (купить, установить, собрать,
    записать во флеш через DFU, запустить), JTAG/SWD цели — следующий этап
    (адаптер MIPI20 с буферами), статус; вариант ПЛИС + CH569 — ссылкой
    - build.sh: multiboot на 0x800000 (MODE → DFU) и usb3d.bin для
    slogic_dfu.py — программатор для работы не нужен
    Co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
2026-10-26 usb3d: трасса BE-U1000 через USB 3.0 — 50 МБ/с, 20 с без потерь и ошибок
    - usb3d.py: источник включается после постановки чтений и выключается до их снятия
    с дочитыванием FIFO — потерь на стыках записи больше нет;
    - ntrace.py decode принимает сырой .bin из usb3d.py cap;
    - окно IODELAY у usb3d — 168…255 (рабочая 208); калибровка PIB при работающем
    кодере подмешивает простой и данные;
    - журналы BE-U1000 и USB, статус в README.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
2026-10-26 usb3d: трасса STM32F407 через USB 3.0 — ITM + ETM на 50 МГц
    - trace.py decode / show --file принимают сырой .bin из usb3d.py cap (--skip, --words);
    - окно IODELAY для STM32 у usb3d — 0…88 при OSPEEDR 1 (рабочая 40);
    - на OSPEEDR 3 и 50 МГц сбоит жгут — и с usb3d, и с tracela: сбои от
    одновременного переключения всех линий, не от USB 3.0;
    - журналы трассы STM32 и USB, статус в README.
2026-10-26 usb3d во флеш через DFU: проверено на приборе без JTAG и без usbipd
    - slogic_dfu.py работает из Python Windows (pyusb + libusb_package, WinUSB
    у загрузчика уже стоит): usbipd и bind от администратора не нужны;
    - запись usb3d.bin 47 с со сверкой, загрузка из флеш по питанию — U0, поток
    и трасса STM32 как из SRAM; MODE возвращает в DFU (multiboot 0x800000);
    - README: HowTo через Python Windows, статус; журнал USB.
2026-10-26 usb3: строки дескрипторов как у USB2 — «SLogic16U3 trace»
    VID:PID прежний 1209:0001; в ПЗУ ciniml оставались строки эталона
    («USB SS Sample»). gen_descriptor_rom.py: rln-trace / SLogic16U3 trace / 0001,
    ПЗУ перегенерировано. Сборка p4 125,011 МГц, записано через DFU и проверено.
2026-10-26 slogic16u3-trace: публичный репозиторий подключён подмодулем, релиз v0.1
2026-10-26 slogic16u3-trace: подмодуль переехал в au/
2026-10-27 hw/slogic-mipi20: переходник SLogic16U3 → MIPI20, схема rev 0.1
    Выходы JTAG/SWD через 74AUP1G126 от VREF с обратным компенсированным
    делителем на входе (канал прибора — источник 72 кОм || C1), nRESET —
    74LVC1G06 с открытым стоком, ESD TPD4E02B04 на всех линиях MIPI20.
    Генератор tools/kisch из символов KiCad 10, ERC 0 нарушений.
2026-10-28 doc: план отладочной части (JTAG, SWD, SWO, cJTAG) по этапам D0–D7
    Новый doc/debug-plan.md: стенд Tang Nano 20K + F4-Discovery через UART,
    remote_bitbang, сдвиговый движок и командный протокол, SWD, SWO,
    перенос на CH569 (free-dap) и SLogic16U3 (адаптер MIPI20), SBW и cJTAG.
    R5 дополнен cJTAG и SWO, ссылки из README, hw/README, bench, doc/README.
2026-11-08 JTAG цели, шаг 1: OpenOCD через remote_bitbang на Tang Nano 9K
    uart_rx + rbb_jtag: протокол remote_bitbang по UART BL702 (3 Мбод), выводы
    JTAG на J5 к STM32F4-Discovery. Мост TCP<->UART sw/rbb/rbb_bridge.py и
    конфиг OpenOCD. Сессия работает: обе TAP, reset halt, чтение памяти
    3,7 КБ/с. Тест test-rbb, линт и синтез в CI. Журнал doc/jtag-journal.md.
2026-11-08 hw/slogic-mipi20 rev 0.2: односторонняя плата без пересечений сигналов
    Угловые вилки 2,54 мм (MIPI20 1:1), пассив 0805, ESD USBLC6-4SC6 по две
    линии на корпус. Каналы разложены в порядке контактов MIPI20: TRACECLK
    на CH8 (GCLKT_3), D0..D3 = CH10 CH12 CH13 CH14; OE TCK/TDI от VREF вместо
    отдельного EN. Одна проволочная перемычка по VREF. План полос — в README.
2026-11-08 Трасса: порт 1 и 2 бита, настройка цели своим JTAG-зондом, звон на 1 МГц
    Подмодуль: tpiu_decode --width, stm32cfg -f. Журналы: 4/2 бита чисто с
    ITM + ETM, 1 бит — только ITM; OSPEEDR 0 на текущей укладке жгута.
2026-11-08 JTAG цели, шаг 2: SWD через remote_bitbang на тех же проводах
    rbb_jtag: команды O/o, c, d..g; TMS/SWDIO двунаправленный. Конфиг
    stm32f4-rbb-swd.cfg. DPIDR 0x2ba01477, reset halt; чтение 0,28 КБ/с —
    OpenOCD читает биты SWD синхронно, по кругу через USB на бит.
2026-11-08 JTAG цели, шаг 3: CMSIS-DAP в ПЛИС, проверен на STM32F407
    dap_core: команды CMSIS-DAP v2 и сдвиговое ядро, Transfer для SWD с
    отложенными чтениями AP и повтором при WAIT; транспорт отдельно
    (dap_uart — кадры по UART BL702). Тест с моделями DP/MEM-AP и TAP.
    F407: SWD 99 КиБ/с на 3,375 МГц, JTAG IDCODE, флеш совпал с ELF.
    Сброс при включении в top_dap и top_jtag.
2026-11-08 JTAG цели, шаг 4: SWO в режиме UART через DAP_SWO_Data
    swo_rx: приём NRZ с фазовым аккумулятором (любая скорость до 27/8 МГц),
    FIFO 8 КиБ. dap_core: команды SWO_*, caps 0x07. F407: ITM по PB3 на
    1 Мбод без разрывов (97,6 кБ/с); 2 Мбод чисто, пока UART до ПК успевает.
    Подмодуль: прошивка цели не откатывает SWO (ITM_TCR.BUSY).
2026-11-12 SLogic16U3: выводы ПЛИС по прозвонке платы без ПЛИС
    vik-mva-lab снял ПЛИС и прозвонил площадки: каналы совпали с нашей
    раскладкой; CK0/CK1 = H13/G13 через 33 Ом; D13 соединён с RECONFIG_N;
    N1 (MODE1) несёт 125 МГц; M12 - синий светодиод; схема USB2 SoftPHY с
    опорным 0,1 В; неразведённый разъём на 30 контактов с линиями 1-3
    SerDes и REFCLK (путь к PCIe).
2026-11-13 BE-U1000: модель QEMU против кристалла, пробы для обоих ядер
    probe/: одна и та же проверка карты памяти, CSR и триггеров для модели
    (make qemu, машина evu-ba) и для платы (make hw: Core 0 из TCMA, Core 2
    из своего TCMB через окно Core 0). Расхождения модели: Smrnmi у BR350
    уводит любое исключение на 0, misa обоих ядер, 2 триггера вместо 4,
    кодер под заглушкой CORE2_PIO, остальной трассер и регистры Core 2
    дают fault, Core 2 видит всю шину. Кристал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
